padington/cambusa-cabinet/references/README.md

# Источники проекта

[Полный индекс ссылок](source-index.json) указывает, в каких файлах использовался или упоминался каждый адрес. [Исходный список референсов](design-links.txt) включает предоставленные ссылки. Часть публикаций Instagram потребовала входа, поэтому присутствие ссылки не означает, что публикация была просмотрена.

| Что использовали | Где это повлияло на проект | Источник |
|---|---|---|
| Cambusa Fly, пропорции и организация хранения | Компактный деревянный корпус на высоком основании, рамочные двери с внутренними полками | [Каталог Riva 1920](https://www.riva1920.it/it/prodotti/mobili-zona-giorno/mobili-contenitori/cambusa-fly) · [Фотография из галереи](https://www.riva1920.it/components/com_riva/files/product_gallery/76/cambusa-fly-1753679982.jpg) |
| Скосы, открытая кромка фанеры, стол и панель с отверстиями | Ранние эскизы и подбор пропорций. Стол использован как референс формы | [Референсы дизайна](design-links.txt) · [The IDEA](https://www.instagram.com/the_idea/) |
| Врезные петли Sugatsune HES3D-120BL | Номинальные карманы, размерные базы и расчётные крайние положения v15/v16 | [Петля](https://www.sugatsune.com/3-way-adjustable-concealed-hinge-black-hes3d-120bl/) · [Монтажная схема](https://www.sugatsune.com/content/site-assets/Instructions/0522-7_hes3d120e.pdf) · [Каталожный чертёж](https://www.sugatsune.com/content/site-assets/201B_PDF/182.pdf) · [Страница CAD и траектории](https://global.sugatsune.com/global/en/tech/products/21590_t) |
| Промышленный профиль 30 × 30 | Габарит каркаса v16. Пазы профиля в модели упрощены | [Bosch Rexroth 3842990723](https://www.boschrexroth.com/en/de/p/strut-profile-3842990723/) |
| Blum TANDEM 560H3500B и T51.1700.04 | Историческая проверка ящика v14. Полная сборка с парой замков остаётся в очереди | [Конфигуратор Blum](https://www.blum.com/us/en/services/e-services/onlineproductconfigurator/) · [Каталог, код DQD1XA](https://publications.blum.com/2024/catalogue/en/435/) · [Отчёт v14](../history/outputs/tandem-review-v14/ПРОЧИТАТЬ-СНАЧАЛА.md) |
| Раскрой и фрезеровка в Санкт-Петербурге | Подбор поставщиков и исторические ставки v10 | [Исследование поставщиков](../history/work/spb-plywood-research.json) · [Расчёт v10](../history/outputs/layout-cost-v10/РАСЧЁТ.md) |
| Печать и коммерческие соединители | Ранние варианты изготовления и сборки | [3D-печать в СПб](../history/work/spb-printing-research.json) · [Соединители](../history/work/order_hardware_candidates.json) |
| Проекты мебели с помощью ИИ | Сравнение подходов к проектированию и подготовке производства | [Проверенные примеры](../history/work/ai-furniture-cases.json) |

Присланные фотографии и скриншоты собраны в [фотогалерее](photos/README.md). Каталоги и исходный CAD производителей приведены ссылками на оригиналы. Собственные модели, эскизы, карты раскроя и код собраны в [истории проекта](../history/README.md) и в [актуальных исходниках](../README.md).
