padington/cambusa-cabinet/references/photos/README.md

# Фотографии и скриншоты для проекта

Референсы формы, материалов и деталей. Авторство исходных изображений принадлежит их авторам.

| Референс | Файл |
|---|---|
| Комод со скошенными боковинами | [Открыть фото](beveled-sideboard.jpg) |
| Слои фанеры и скругление торца | [Открыть фото](plywood-edge-detail.jpg) |
| Наклонный профиль секретера | [Открыть фото](sloped-secretary.jpg) |
| Стол YOUK, тёмный вариант | [Открыть фото](youk-dark-angle.jpg) |
| Стол YOUK, пропорции опор | [Открыть фото](youk-natural-angle.jpg) |
| Стол YOUK, диагональный вид | [Открыть фото](youk-yellow-angle.jpg) |
| Стол YOUK, детали верхней секции | [Открыть фото](youk-yellow-detail.jpg) |
| Стол YOUK, вид спереди | [Открыть фото](youk-yellow-front.jpg) |
| Перфорированная боковина | [Открыть фото](pegboard-reference.png) |
| Cambusa Fly, фотография из каталога Riva 1920 | [Открыть фото](cambusa-fly-riva.png) |
| Cambusa Fly с открытыми створками и подсветкой | [Открыть фото](cambusa-open-lit.jpg) |
| Крупный план петли, полок и ящиков | [Открыть фото](cambusa-hinge-shelves.jpg) |
| Открытый шкаф Cambusa Fly, вид спереди | [Открыть фото](cambusa-open-front.jpg) |
