padington/cambusa-cabinet/references/design-links.txt

Референсы пользователя, без утверждения о доступности всех публикаций:
https://www.instagram.com/reel/DeNH8KUxL0F/
https://www.instagram.com/reel/DQRs9qPiD78/
https://www.instagram.com/p/DdYVaM4irWC/
https://www.instagram.com/reel/DeH7xiDxZNn/
https://www.instagram.com/domj0hnson/
https://www.instagram.com/greg.dean.mann/
https://www.instagram.com/reel/DMUpQAet0EN/
https://www.instagram.com/reel/DMUqrTBt7dS/
https://www.instagram.com/p/DUC9AhtCOgn/
https://www.instagram.com/p/DUDbeApl1VM/
https://www.instagram.com/guillaume_jandin/
https://www.riva1920.it/ru/produkty/mebel-dlya-dnevnoj-zony/mebel-dlya-khraneniya
https://www.riva1920.it/ru/produkty/mebel-dlya-dnevnoj-zony/knizhnye-shkafy
https://www.riva1920.it/it/prodotti/mobili-zona-giorno/mobili-contenitori/cambusa-fly
