padington/cambusa-cabinet/outputs/cambusa-doors-v15/ПРОЧИТАТЬ-СНАЧАЛА.md

# Cambusa v15 — рамочные двери с полками

[3D с открытыми дверями](open.glb) · [3D с закрытыми дверями](closed.glb) · [Общий вид](ДВЕРИ-v15.png) · [Карман петли крупно](КАРМАНЫ-ПЕТЛИ.png) · [Координаты операций и результаты проверок](ПРОВЕРКА.json)

Шкаф 1000 × 1800 × 500 мм. Деревянный корпус высотой 1000 мм стоит на чёрном основании высотой 800 мм. В каждой створке 457,5 × 958 × 85 мм три полки с бортиками. Полезная площадка каждой полки — 379,5 × 58,2 мм. Стойка у центрального шва тоньше, а глубокая часть двери заканчивается за 20 мм до шва. Это даёт место для начала поворота. Стык створок в закрытом положении — 6 мм.

## Привязки карманов

В сборке начало координат — на полу под передним левым углом корпуса. X идёт вправо, Y вглубь шкафа, Z вверх. Все размеры в миллиметрах. Дверной карман расположен в торце со стороны петли, ответный — на обращённом к проёму торце стойки корпуса. Глубину измеряем от поверхности этого торца.

| Привязка | Дверь | Стойка корпуса |
|---|---:|---:|
| Передняя граница кармана от передней кромки детали | 3 | 4 |
| Ширина кармана | 23 | 25 |
| Нижняя граница внешней ступени от низа детали, нижняя и верхняя петли | 79 / 759 | 82 / 762 |
| Высота × глубина внешней ступени | 120 × 6,5 | 120 × 6,5 |
| Нижняя граница глубокой ступени от низа детали, нижняя и верхняя петли | 94 / 774 | 97 / 777 |
| Высота × полная глубина глубокой ступени | 90 × 21 | 90 × 21 |
| Радиус в углах | 6 | 6 |
| Остаток дерева за глубокой ступенью | 19 | 15 |

Центры обеих пар петель находятся на высотах 960 и 1640 мм от пола. Номинальные оси винтов идут по середине кармана на 53 мм выше и ниже центра петли. Предусмотрены отдельные стойки корпуса толщиной 36 мм, чтобы карман глубиной 21 мм помещался целиком. Пилотные отверстия и обработку сопряжённых кромок нужно согласовать на пробном узле. [Монтажная схема Sugatsune HES3D-120](https://www.sugatsune.com/content/site-assets/Instructions/0522-7_hes3d120e.pdf)

## Что показала модель

- Вырезаны все 16 ступеней карманов и пазы дверных деталей. В закрытом положении и в расчётном положении на 180° пересечений деревянных деталей не обнаружено. На 180° шкаф занимает 1843 мм по ширине.
- При закрытых дверях между их тыльной границей и внутренними полками остаётся 17 мм. Это зазор пустых полок. При загрузке нужно учитывать выступ предметов.
- Проверен путь вставки передней панели в пазы до установки последней стойки. После закрытия рамки полки и бортики вставляются со стороны внутренней поверхности. Проверка касается геометрии дерева. Разъёмные крепления рамки и фиксаторы полок ещё нужно подобрать.
- Для зазора у шва рассчитан сценарий поворота вокруг неподвижного ребра. Он помог подобрать форму стойки. Реальная HES3D-120BL перемещает створку на рычагах, поэтому движение между 0 и 180° нужно проверить по файлу траектории или на собранной паре стоек с петлёй.

Масса пустой двери с двумя петлями оценена в 9,15 кг при плотности дерева 720 кг/м³, без прочей фурнитуры. Каталожная грузоподъёмность пары петель 30 кг относится к условиям производителя. Для дверных полок нужны отдельная проверка нагрузки и проверка устойчивости шкафа с открытыми створками. Выпуск обработки для полного заказа пока закрыт. [Данные HES3D-120BL](https://www.sugatsune.com/3-way-adjustable-concealed-hinge-black-hes3d-120bl/)

Ящики отложены. Проход в каждую секцию после установки стоек — 455 мм. Фасад прежнего ящика шириной 465 мм в этот проём не проходит. Короб шириной 455 мм также требует пересчёта для рабочего зазора.
