padington/cambusa-cabinet/history/outputs/cabinet-six-concepts/01-portal.png

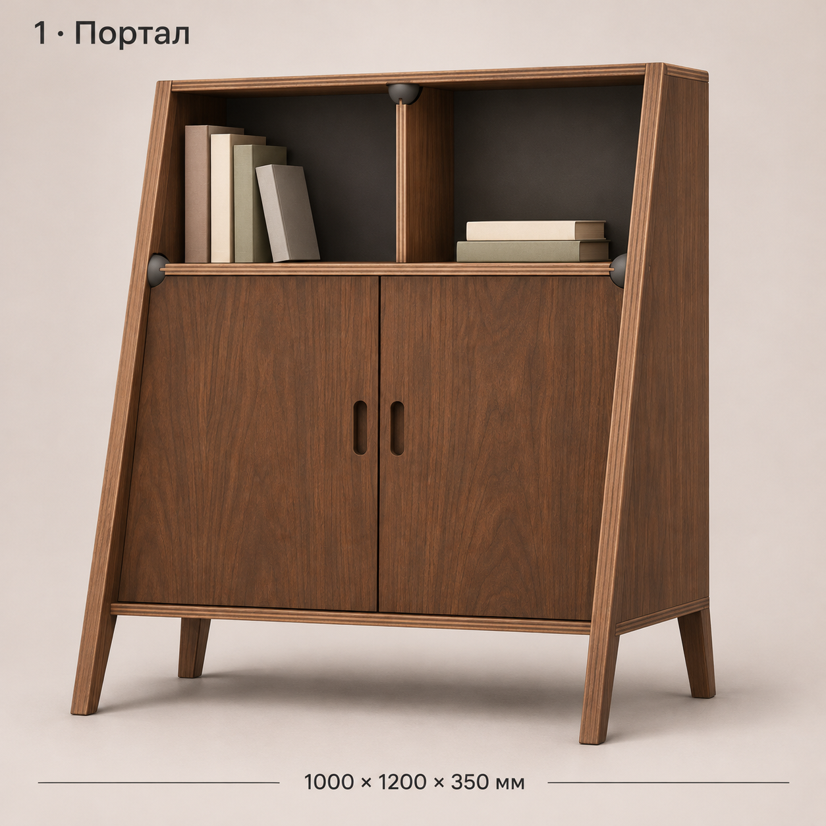
history/outputs/cabinet-six-concepts/01-portal.png
