padington/cambusa-cabinet/history/outputs/cabinet-six-concepts/02-vertical.png

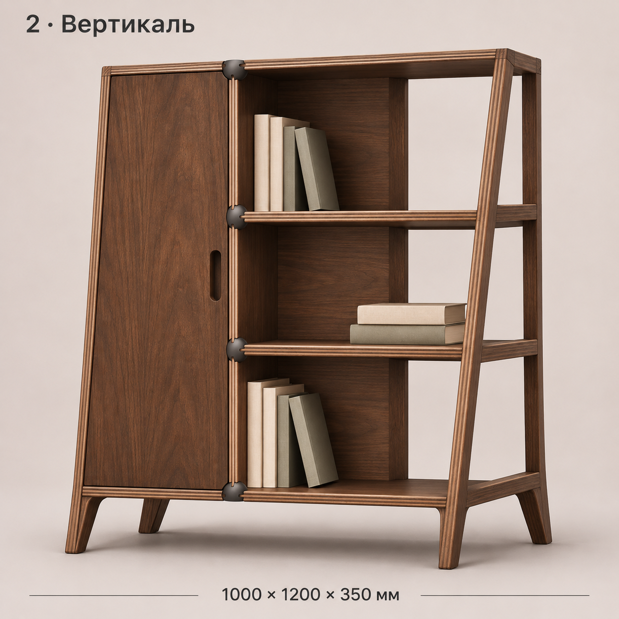
history/outputs/cabinet-six-concepts/02-vertical.png
