padington/cambusa-cabinet/history/outputs/cabinet-six-concepts/03-offset.png

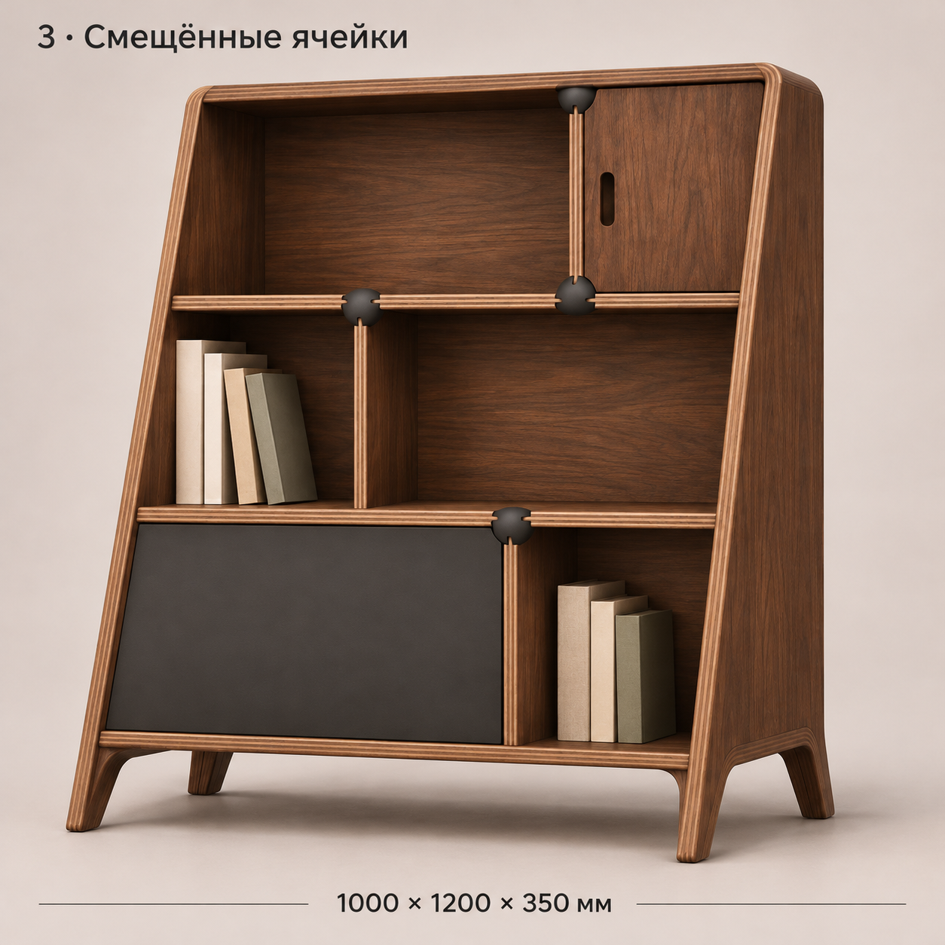
history/outputs/cabinet-six-concepts/03-offset.png
