padington/cambusa-cabinet/history/outputs/cabinet-six-concepts/05-ladder.png

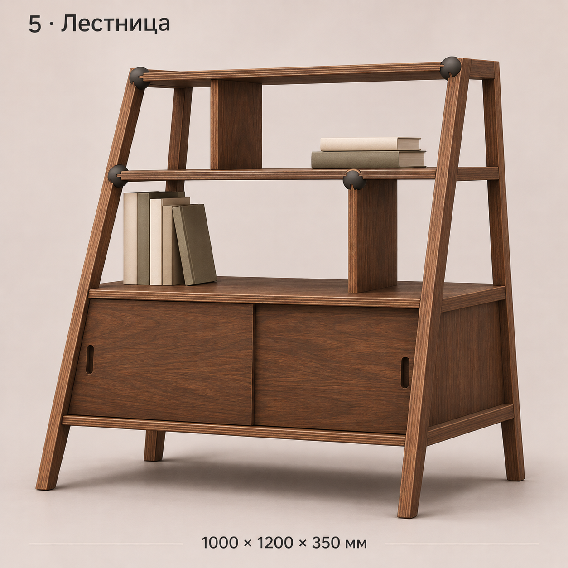
history/outputs/cabinet-six-concepts/05-ladder.png
