padington/cambusa-cabinet/history/outputs/cabinet-six-concepts/06-gallery.png

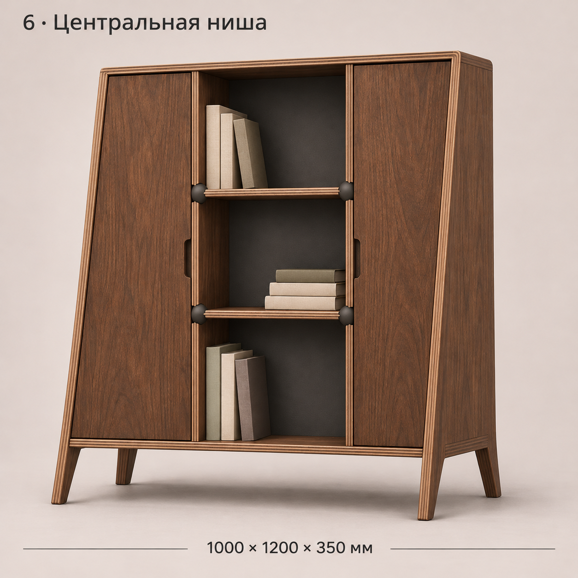
history/outputs/cabinet-six-concepts/06-gallery.png
