padington/cambusa-cabinet/history/outputs/early-visual-sketches/sloped-cabinet-concept-v01.png

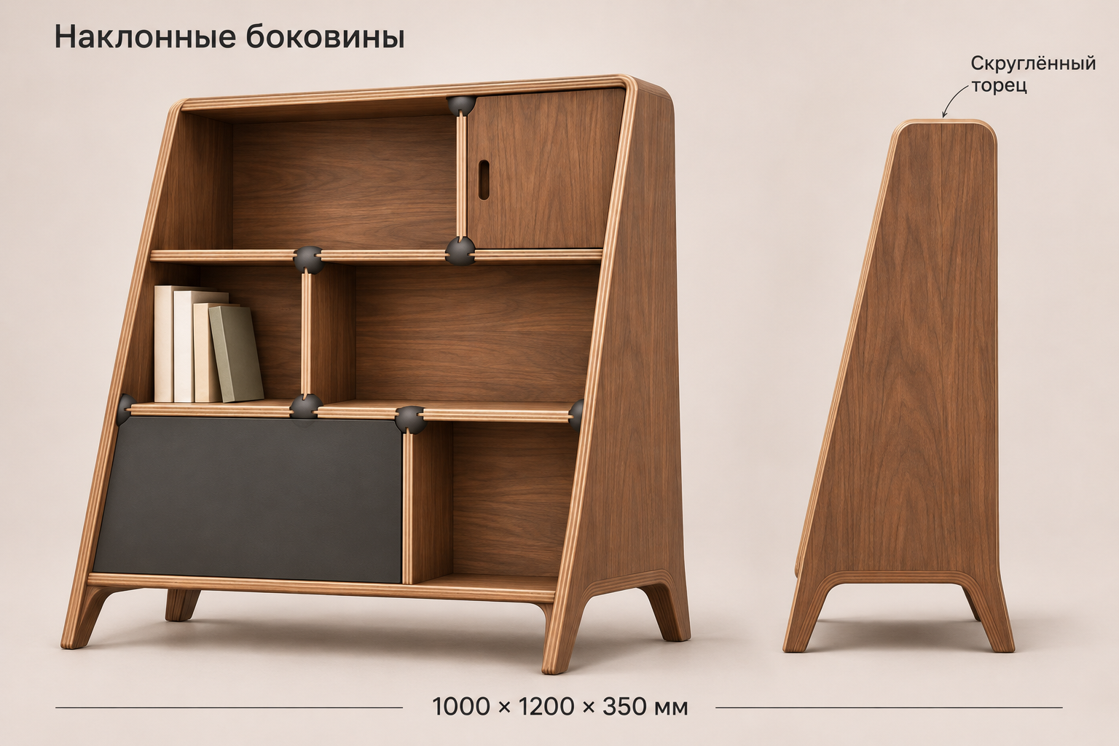
history/outputs/early-visual-sketches/sloped-cabinet-concept-v01.png
