padington/cambusa-cabinet/history/outputs/early-visual-sketches/spherical-cabinet-riva-concept-v01.png

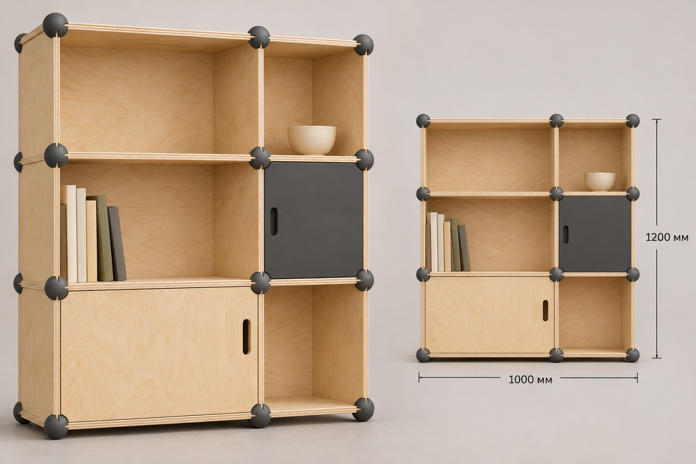
history/outputs/early-visual-sketches/spherical-cabinet-riva-concept-v01.png
