padington/cambusa-cabinet/history/outputs/sphere-bayonet-v02/mechanism-overview.png

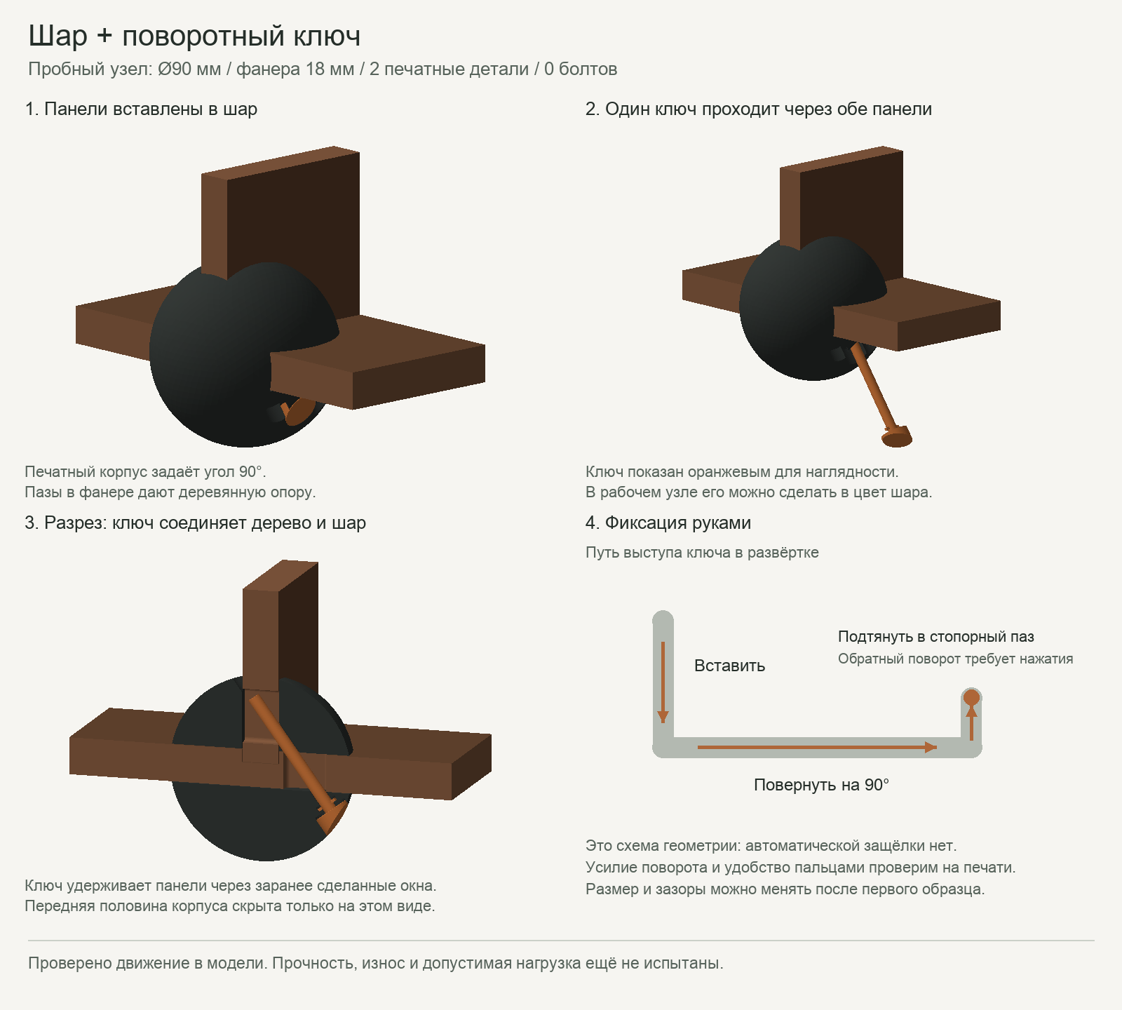
history/outputs/sphere-bayonet-v02/mechanism-overview.png
