padington/cambusa-cabinet/history/work/reference-designs-open.png

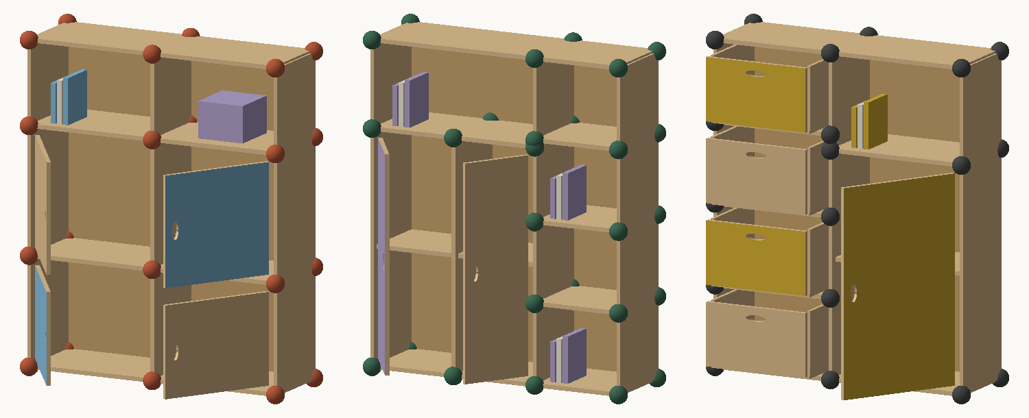
history/work/reference-designs-open.png
