padington/cambusa-cabinet/outputs/cambusa-doors-v15/closed.png

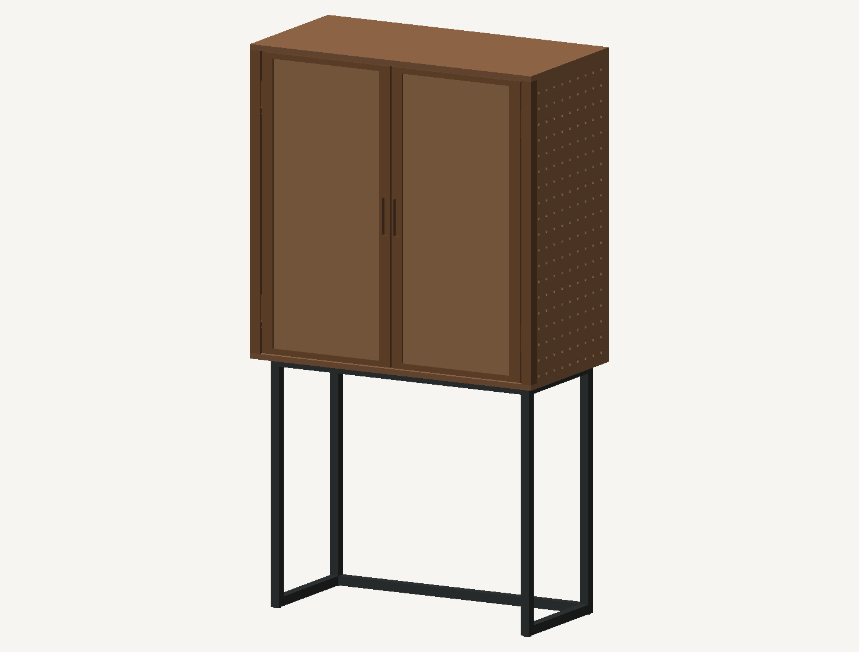
outputs/cambusa-doors-v15/closed.png
