padington/cambusa-cabinet/outputs/cambusa-doors-v15/open.png

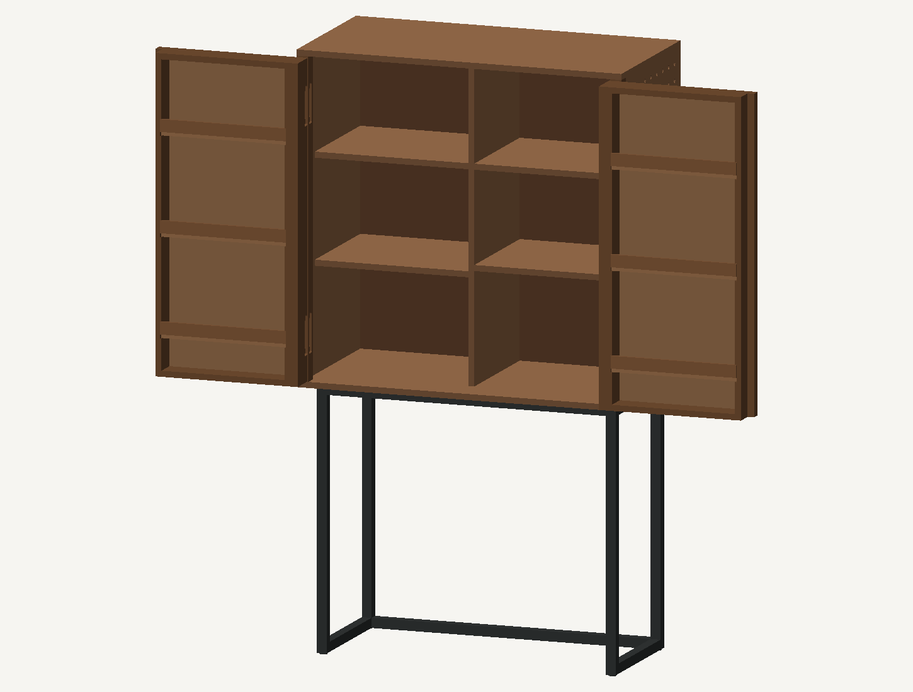
outputs/cambusa-doors-v15/open.png
