padington/cambusa-cabinet/outputs/cambusa-doors-v15/ДВЕРИ-v15.png

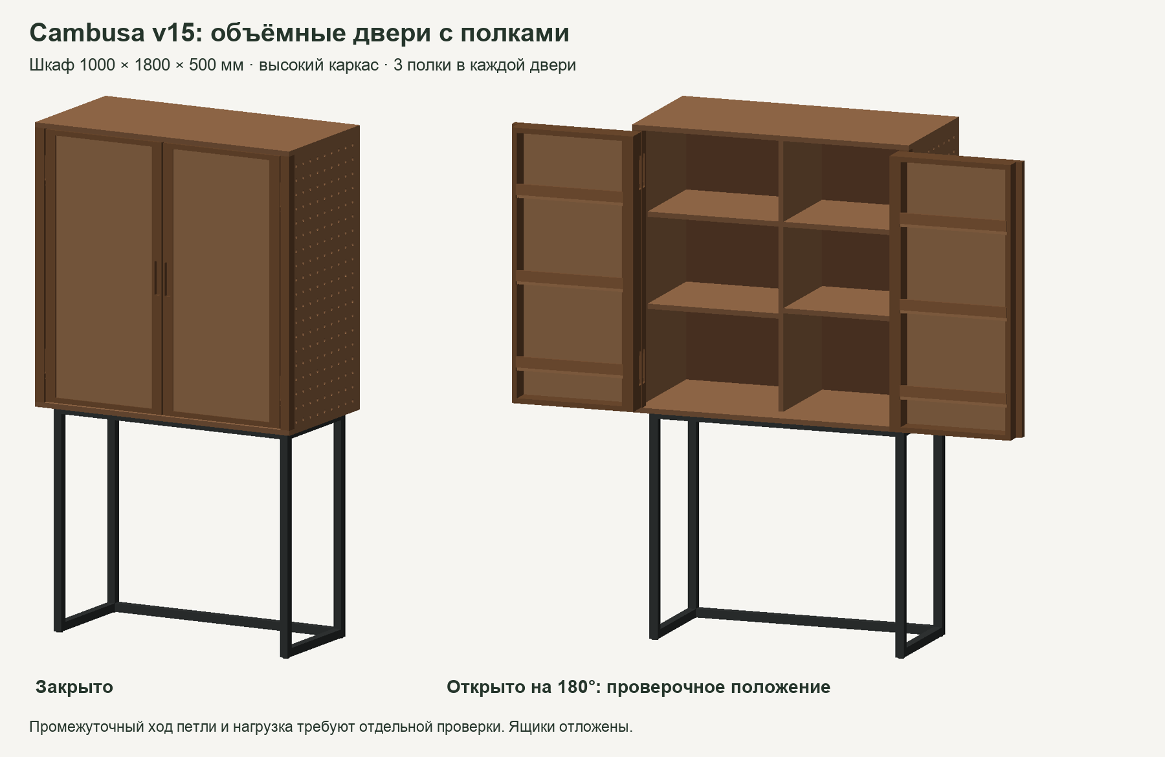
outputs/cambusa-doors-v15/ДВЕРИ-v15.png
