padington/cambusa-cabinet/outputs/cambusa-doors-v15/КАРМАНЫ-ПЕТЛИ.png

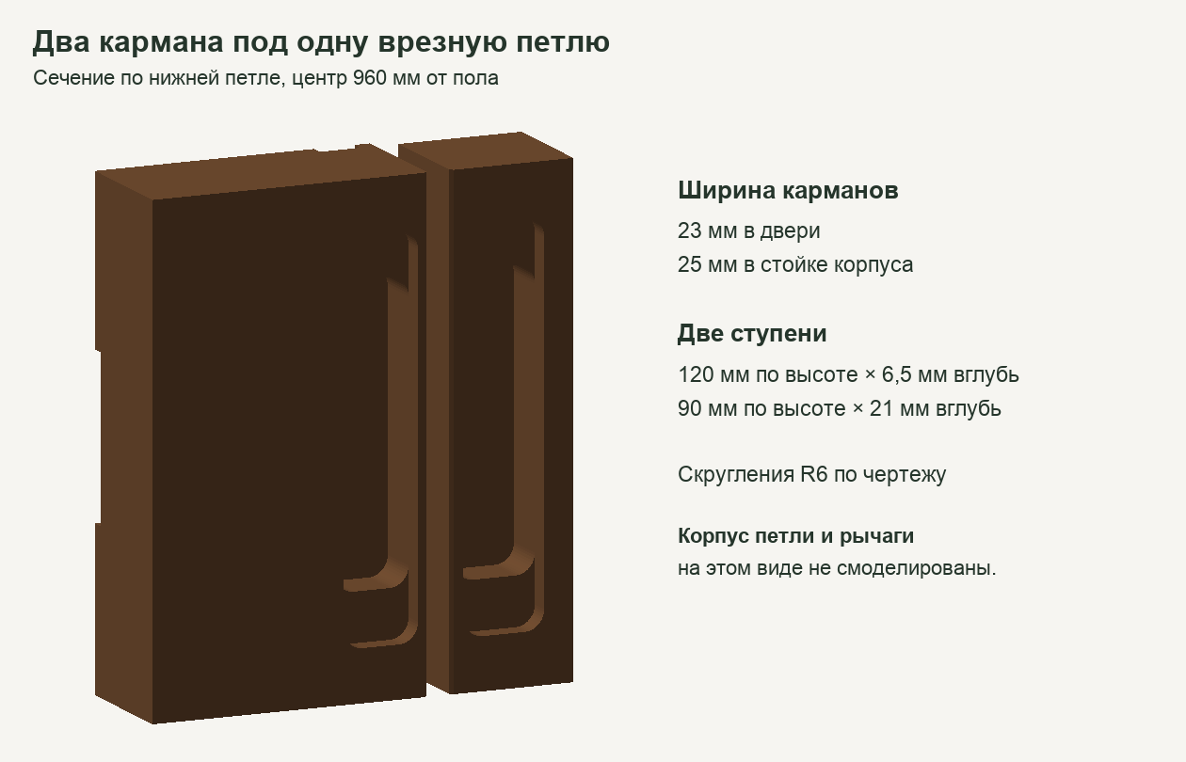
outputs/cambusa-doors-v15/КАРМАНЫ-ПЕТЛИ.png
