padington/cambusa-cabinet/outputs/cambusa-frame-v17/storage/01-solid.png

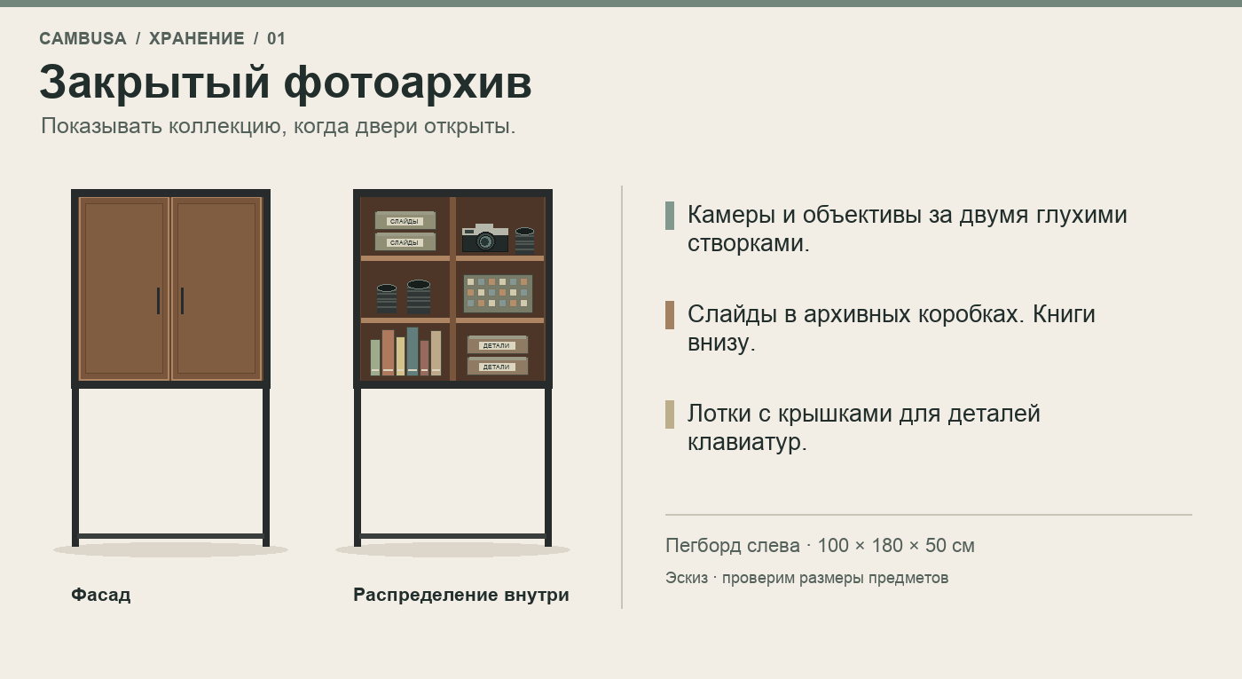
outputs/cambusa-frame-v17/storage/01-solid.png
