padington/cambusa-cabinet/outputs/cambusa-frame-v17/storage/03-books.png

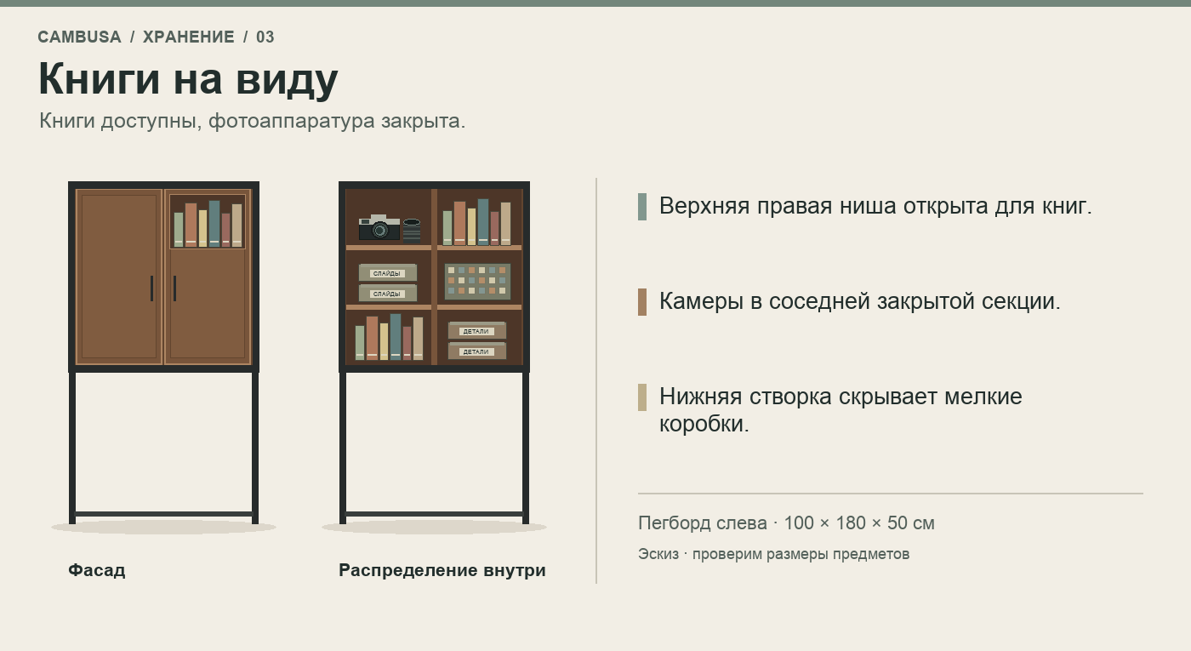
outputs/cambusa-frame-v17/storage/03-books.png
