padington/cambusa-cabinet/references/photos/beveled-sideboard.jpg

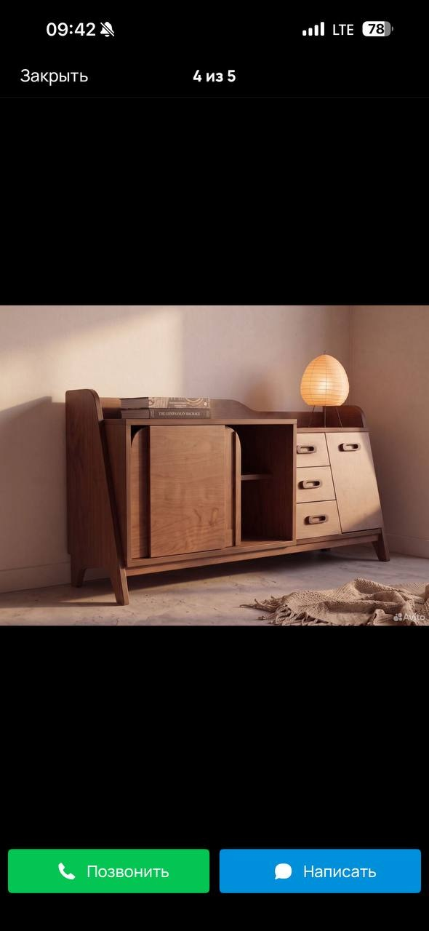
references/photos/beveled-sideboard.jpg
