padington/cambusa-cabinet/references/photos/cambusa-fly-riva.png

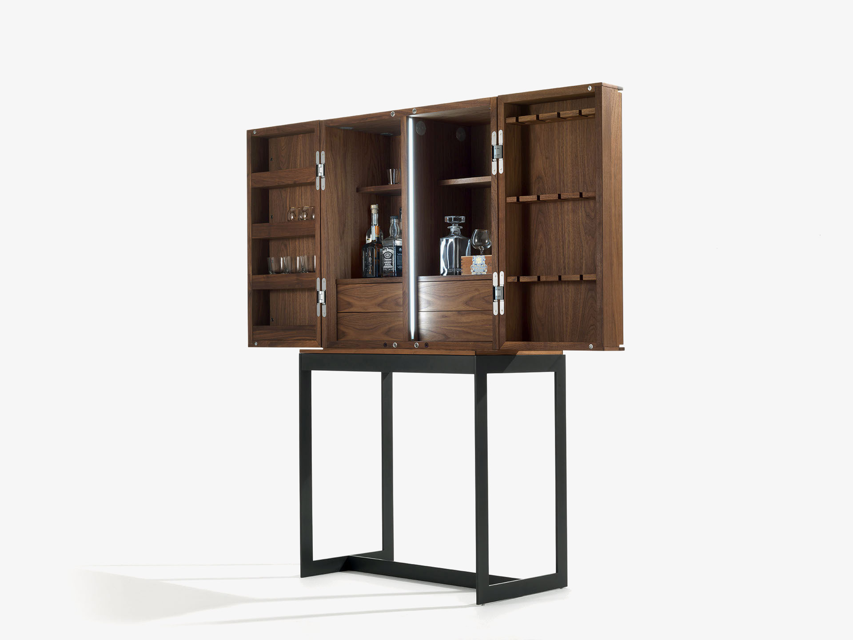
references/photos/cambusa-fly-riva.png
