padington/cambusa-cabinet/references/photos/cambusa-hinge-shelves.jpg

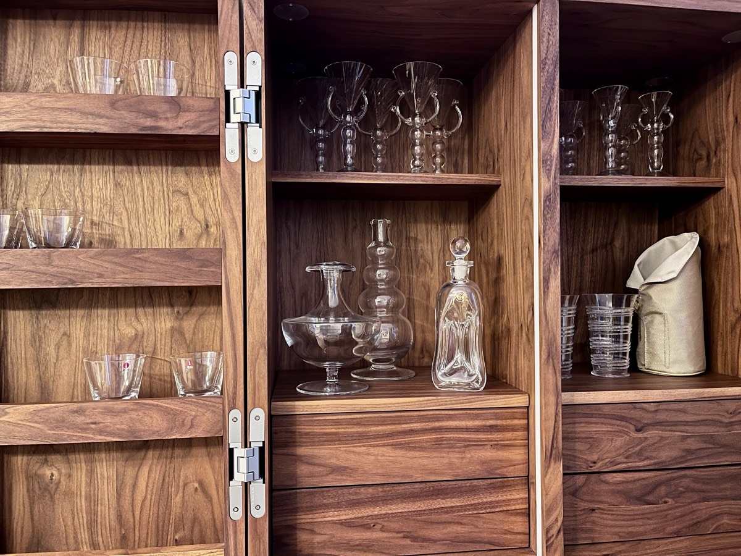
references/photos/cambusa-hinge-shelves.jpg
