padington/cambusa-cabinet/references/photos/cambusa-open-front.jpg

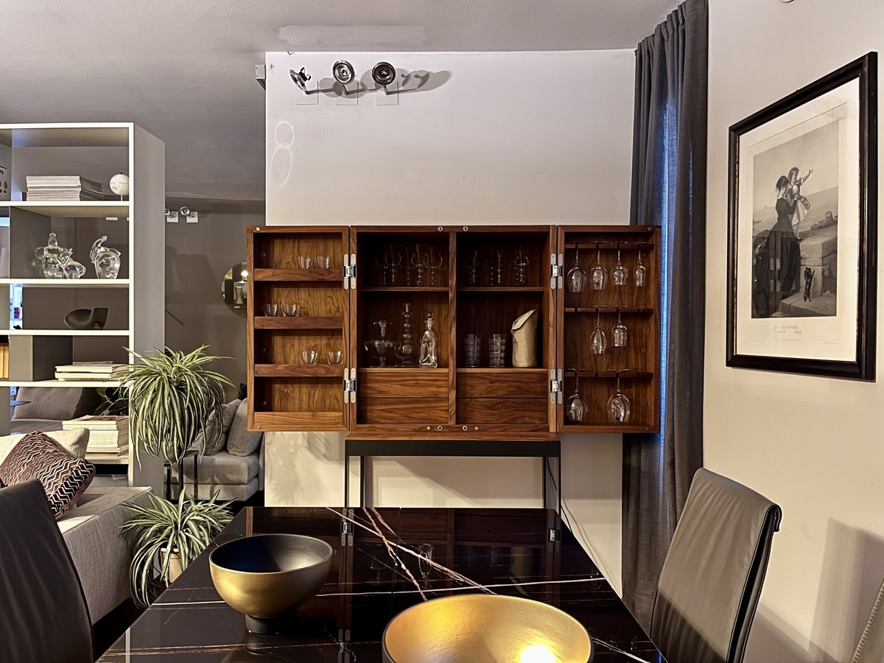
references/photos/cambusa-open-front.jpg
