padington/cambusa-cabinet/references/photos/cambusa-open-lit.jpg

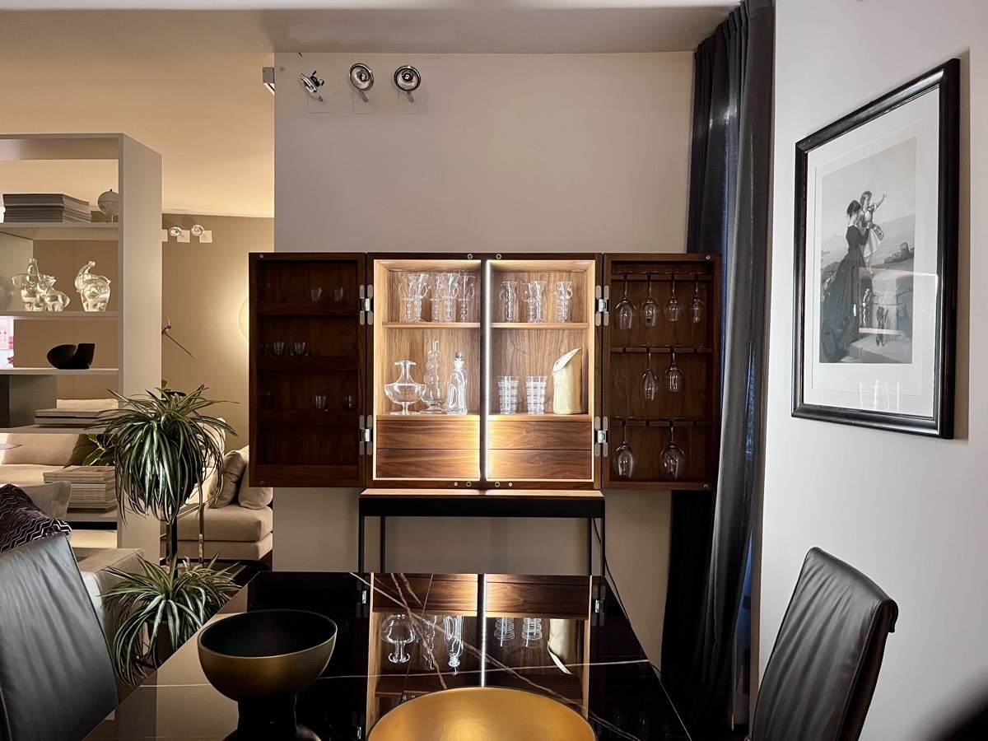
references/photos/cambusa-open-lit.jpg
