padington/cambusa-cabinet/references/photos/pegboard-reference.png

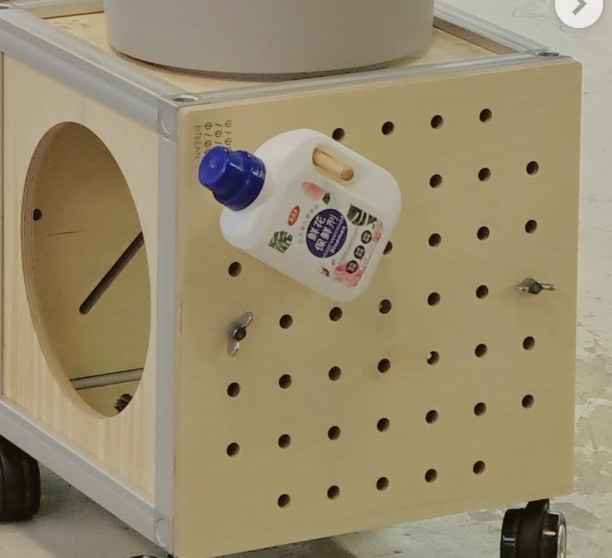
references/photos/pegboard-reference.png
