padington/cambusa-cabinet/references/photos/plywood-edge-detail.jpg

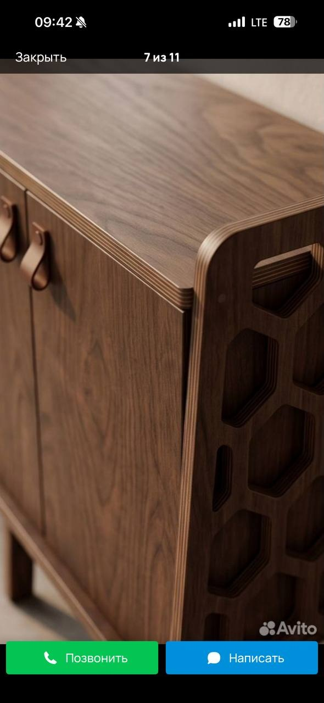
references/photos/plywood-edge-detail.jpg
