padington/cambusa-cabinet/references/photos/sloped-secretary.jpg

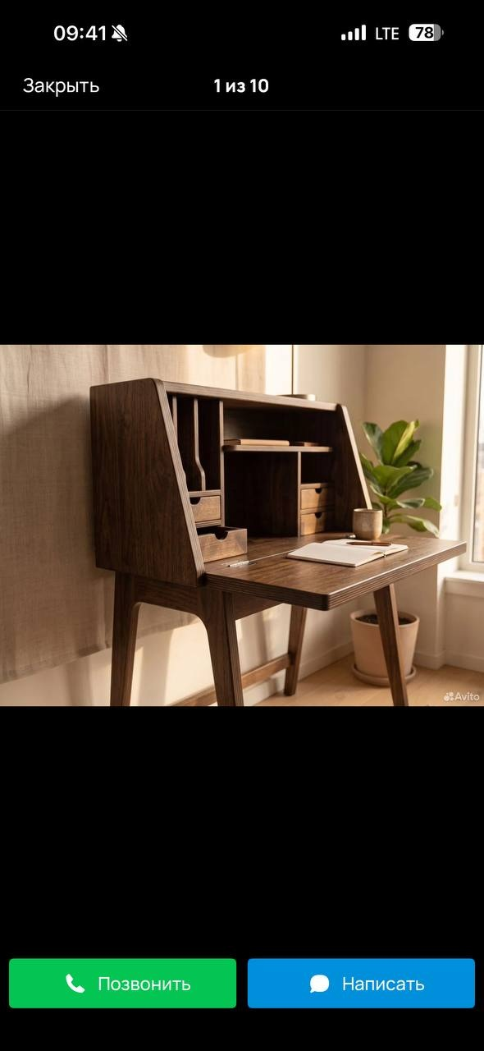
references/photos/sloped-secretary.jpg
