padington/cambusa-cabinet/references/photos/youk-dark-angle.jpg

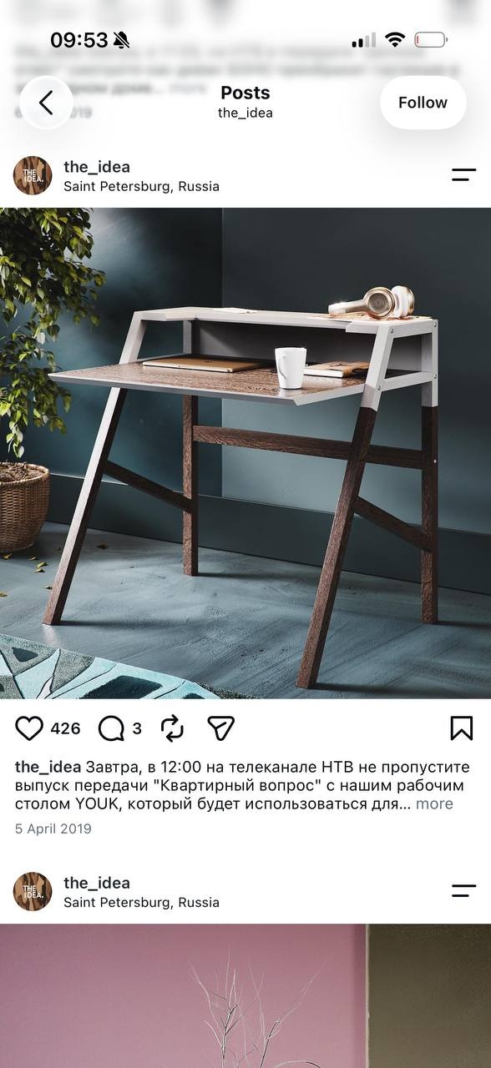
references/photos/youk-dark-angle.jpg
