padington/cambusa-cabinet/references/photos/youk-natural-angle.jpg

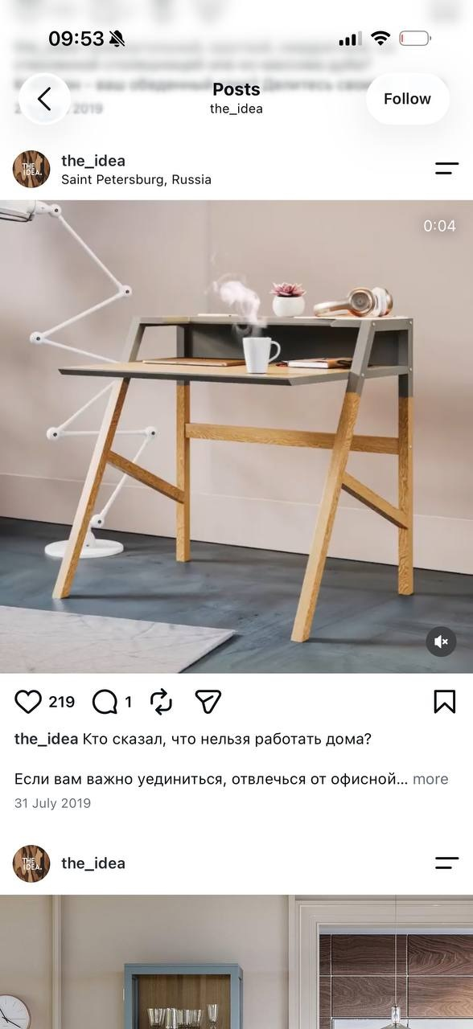
references/photos/youk-natural-angle.jpg
