padington/cambusa-cabinet/references/photos/youk-yellow-angle.jpg

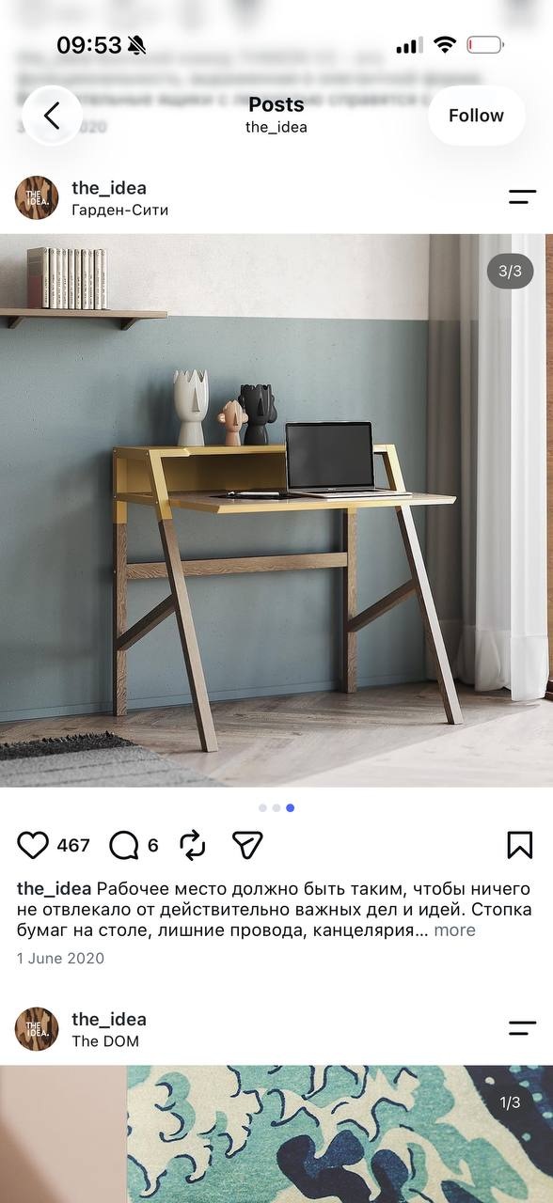
references/photos/youk-yellow-angle.jpg
