padington/cambusa-cabinet/references/photos/youk-yellow-detail.jpg

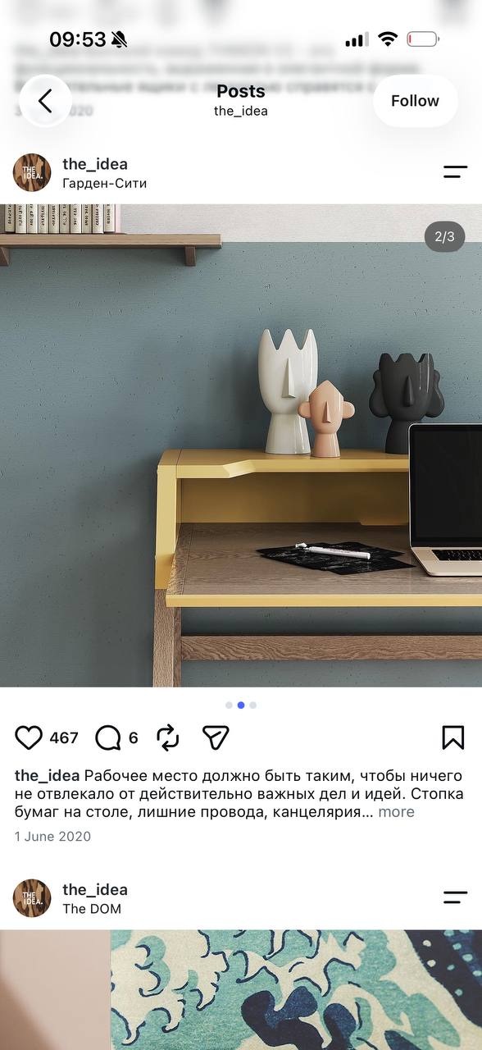
references/photos/youk-yellow-detail.jpg
