padington/cambusa-cabinet/references/photos/youk-yellow-front.jpg

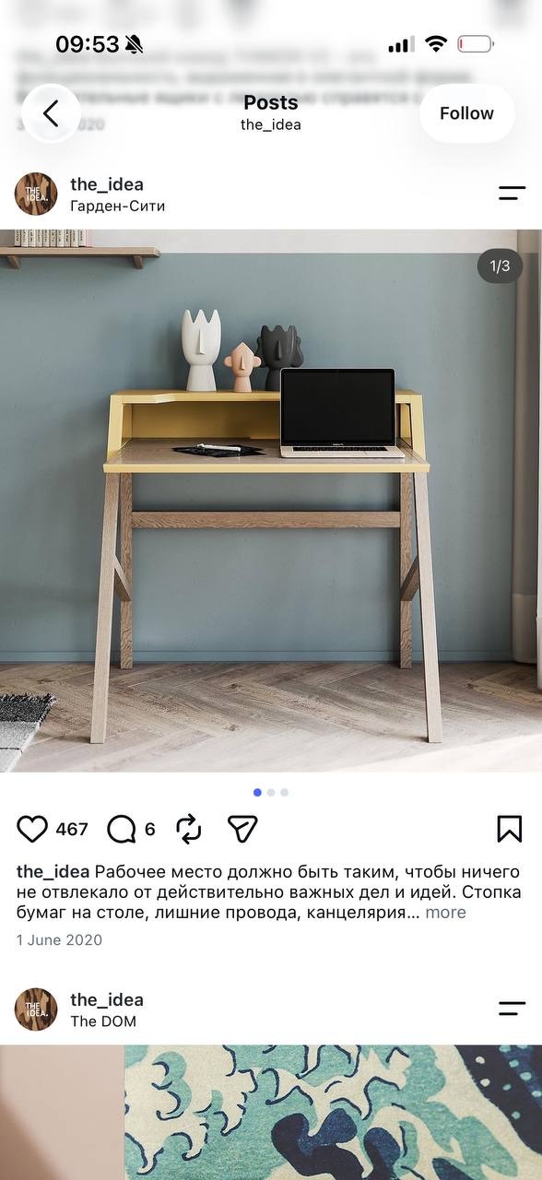
references/photos/youk-yellow-front.jpg
