padington/cambusa-cabinet/history/outputs/order-preparation-v06/profile-blanks.csv

id | section_mm | slot | length_mm | quantity
A-post-0-0 | 30x30 | 8 mm, exact system pending | 1064 | 1
A-post-0-1 | 30x30 | 8 mm, exact system pending | 1064 | 1
A-post-1-0 | 30x30 | 8 mm, exact system pending | 1064 | 1
A-post-1-1 | 30x30 | 8 mm, exact system pending | 1064 | 1
A-post-2-0 | 30x30 | 8 mm, exact system pending | 1064 | 1
A-post-2-1 | 30x30 | 8 mm, exact system pending | 1064 | 1
A-cross-left-0-0 | 30x30 | 8 mm, exact system pending | 447 | 1
A-cross-right-0-0 | 30x30 | 8 mm, exact system pending | 445 | 1
A-cross-left-0-1 | 30x30 | 8 mm, exact system pending | 447 | 1
A-cross-right-0-1 | 30x30 | 8 mm, exact system pending | 445 | 1
A-depth-0-0 | 30x30 | 8 mm, exact system pending | 434 | 1
A-depth-0-1 | 30x30 | 8 mm, exact system pending | 434 | 1
A-depth-0-2 | 30x30 | 8 mm, exact system pending | 434 | 1
A-cross-right-1-0 | 30x30 | 8 mm, exact system pending | 445 | 1
A-cross-left-1-1 | 30x30 | 8 mm, exact system pending | 447 | 1
A-cross-right-1-1 | 30x30 | 8 mm, exact system pending | 445 | 1
A-depth-1-0 | 30x30 | 8 mm, exact system pending | 434 | 1
A-depth-1-1 | 30x30 | 8 mm, exact system pending | 434 | 1
A-depth-1-2 | 30x30 | 8 mm, exact system pending | 434 | 1
A-cross-left-2-0 | 30x30 | 8 mm, exact system pending | 447 | 1
A-cross-right-2-0 | 30x30 | 8 mm, exact system pending | 445 | 1
A-cross-left-2-1 | 30x30 | 8 mm, exact system pending | 447 | 1
A-cross-right-2-1 | 30x30 | 8 mm, exact system pending | 445 | 1
A-depth-2-0 | 30x30 | 8 mm, exact system pending | 434 | 1
A-depth-2-1 | 30x30 | 8 mm, exact system pending | 434 | 1
A-depth-2-2 | 30x30 | 8 mm, exact system pending | 434 | 1
A-cross-left-3-0 | 30x30 | 8 mm, exact system pending | 447 | 1
A-cross-right-3-0 | 30x30 | 8 mm, exact system pending | 445 | 1
A-cross-left-3-1 | 30x30 | 8 mm, exact system pending | 447 | 1
A-cross-right-3-1 | 30x30 | 8 mm, exact system pending | 445 | 1
A-depth-3-0 | 30x30 | 8 mm, exact system pending | 434 | 1
A-depth-3-1 | 30x30 | 8 mm, exact system pending | 434 | 1
A-depth-3-2 | 30x30 | 8 mm, exact system pending | 434 | 1
