padington/cambusa-cabinet/history/outputs/order-preparation-v06/READ-ME-RU.txt

КОМПЛЕКТ ДЕТАЛЕЙ ТУМБЫ — ПОДГОТОВКА К РАСЧЁТУ, ВЕРСИЯ 06
3 ноября 2026

ЦЕЛЬ
Заказать отдельные подготовленные детали и самостоятельно собрать всю тумбу
дома. Сборка каркаса и коробов ящиков на стороне не входит в проект.
Точные операции изготовления выполняет поставщик деталей по заданию:
раскрой, фрезеровка, сверление, обработка кромок и отделка.
Ранее разрешённые готовые мебельные петли могут приходить на отдельных
панелях. Это не означает заказ собранного корпуса.

В ЭТОЙ ВЕРСИИ
Корпус 1000 × 1200 × 500 мм, высота включает колёса.
Два внутренних ящика, левая дверца с двумя лотками, открытые ниши,
перфорация на всю правую боковину. Тёмная фанера и тонкая тёмная рама.
Добавлены центральные передняя и задняя стойки: перекладины теперь
имеют опоры на обоих концах. Детали больше не заканчиваются в воздухе.
Задняя стенка вынесена на заднюю плоскость рамы; это позволяет поставить
её последней снаружи, не продевая через собранные перекладины.
Добавлены отдельное основание под колёса и верхняя крышка.
Рама: 33 отрезка профиля 30 × 30, всего 18,281 м без пропила и запаса.
Фанера: 38 заготовок, включая раздельные стороны и днища обоих ящиков.
Это отдельные детали, а не заказ готовых собранных ящиков.

ФАЙЛЫ
profile-blanks.csv — каждый отрезок профиля с маркировкой и длиной.
plywood-blanks.csv — каждая заготовка фанеры с толщиной и размером.
quote-outlines/ — контуры для оценки работ: DXF в миллиметрах и SVG 1:1.
assembled.glb — закрытый корпус, open.glb — условное открывание,
exploded.glb — разнесённые детали. GLB в метрах, Y вверх.
assembled.png, open.png, exploded.png — изображения той же геометрии.
verification.json — проверки сеток и крупных геометрических пересечений.
hardware-candidates.json — проверенные кандидаты и исключённые варианты.

ВАЖНЫЙ СТАТУС ФАЙЛОВ
Это пакет для расчёта и проверки конструкции, НЕ разрешение на резку.
Во всех DXF слои помечены QUOTE_ONLY. Присадка для крепежа, петель,
фиксаторов и направляющих пока не выпущена. Не все контуры окончательны:
после выбора креплений могут измениться торцевые пазы, припуски и днища.
Полный заказ в производство до выбора креплений делать нельзя.
Вопрос о допустимости ключа/отвёртки из комплекта задан пользователю отдельно.
До ответа сохраняется исходная цель сборки только руками. Обычный
алюминиевый каркас сам по себе этому условию не отвечает: его соединения
обычно затягиваются ключом. Вариант с профилем пока не утверждён по крепежу.

ПЕРФОРАЦИЯ
Панель 500 × 1064 × 18 мм. Номинально Ø12 мм, шаг 50 мм, 180 отверстий.
20 рядов, 9 колонок. Новая сетка не пересекается с перекладинами за панелью:
центры по глубине 50..450 мм с шагом 50; по высоте от пола 190..1140 мм.
Предыдущую сетку версии 05 (189 отверстий) не применять к этой раме.
Навесы в версии 06 не показаны: сначала требуется определить крепления
и проверить посадку штырей после отделки. Система не заявлена совместимой
с каким-либо брендом pegboard.

КОЛЁСА
В расчётной геометрии заложены колёса Ø75, монтажная высота 100 мм,
условная площадка 60 × 60 мм. Это габаритная модель кандидата,
не CAD конкретного колеса и не подтверждённый артикул для покупки.
Пример габарита — Blickle LPA-TPA 75G-FI. Наличие в России не подтверждено.
Точное колесо, его сверление, крепление к основанию, тормоз и нагрузка
должны быть выбраны до выпуска основания в производство.
Паспортная нагрузка колеса не равна допустимой нагрузке всей тумбы.

ЯЩИКИ
В эскизе два короба наружным габаритом около 409 × 390 мм.
Расчётная толщина боковин 12 мм, днищ 9 мм, внутренний фасад 12 мм.
Кандидат-направляющая: скрытая, номинальная длина 400 мм, с фиксатором.
Файлы пока показывают габариты и зазоры. Пазы днищ, задние вырезы,
сверления фиксаторов, стыки коробов и крепление направляющих не выпущены.
Инструкция не может начинаться с «вставить готовый ящик»: каждый короб
также должен собираться пользователем из перечисленных деталей.

ВАРИАНТЫ СОЕДИНЕНИЙ
Если допустим простой ручной инструмент из комплекта: можно использовать
обычную доступную фурнитуру профиля и мебельные винтовые крепления внутри.
Тогда поставщик режет и сверлит, а всю сборку выполняет пользователь.

Если только руками: потребуются специальные скрытые защёлки или ручные
замки и отдельное решение для направляющих и колёс. OVVO и Lockdowel
подтверждают соответствующие принципы, но наличие нужных артикулов и
исполнителя их точных пазов в СПб пока не подтверждено. Их нельзя молча
заменить на обычный профиль с винтами или на предварительную сборку каркаса.

ПОРЯДОК СБОРКИ, КОТОРЫЙ ДОЛЖЕН ПОЛУЧИТЬСЯ
1. Проверить маркировку и комплектность отдельных деталей.
2. Поставить колёса на основание выбранным способом.
3. Собрать низ рамы и стойки, затем остальные перекладины.
4. Установить полки, центральные перегородки и боковые вставки.
5. Закрепить цельную перфорированную боковину.
6. Закрепить заднюю стенку, выровняв геометрию корпуса.
7. Самостоятельно собрать оба короба, поставить направляющие и фиксаторы.
8. Поставить ящики и дверцы, отрегулировать зазоры по инструкции фурнитуры.
9. Проверить лёгкость движения и тормоза, затем испытать назначенную нагрузку.
Это целевая последовательность, а не уже проверенная инструкция монтажа:
крепёжные операции и доступ к ним нужно подтвердить после выбора фурнитуры.

ЧТО ПРОВЕРЕНО
Замкнутость сеток, габариты и отсутствие объёмных пересечений крупных
панелей и элементов рамы в закрытом состоянии. Эти проверки не доказывают
прочность, устойчивость, кинематику настоящих петель или сборку соединений.

СЛЕДУЮЩИЙ ВЫПУСК ДЛЯ ЗАКАЗА
После выбора допустимого инструмента: точные артикулы и количество
креплений, окончательная присадка всех деталей, схема крепления колёс,
узлы коробов и направляющих, контрольный образец, затем полный раскрой.
Нет заказанных деталей, отправленных заявок или подтверждённых цен.
