padington/cambusa-cabinet/outputs/cambusa-frame-v17/planning/BOM.md

# Ведомость и смета Cambusa v17

Расчёт по габаритам деталей в closed.glb. Это план закупки и контроль раскладки. Карты используют прямоугольные заготовки с припуском, а пазы и отверстия задаются отдельно.

Деталей в модели — **53**, фанеры — **5 листов**, длинномерных заготовок — **6**.

| Позиция | Количество | Единица | Цена | Сумма |
|---|---:|---|---:|---:|
| Фанера 12 мм | 1 | лист | требует уточнения | требует уточнения |
| Фанера 18 мм | 2 | лист | требует уточнения | требует уточнения |
| Фанера 8 мм | 1 | лист | требует уточнения | требует уточнения |
| Фанера 9 мм | 1 | лист | требует уточнения | требует уточнения |
| Профиль 30 × 30, заготовка 6000 мм | 3 | хлыст | требует уточнения | требует уточнения |
| Брусок 40 × 45, заготовка 2400 мм | 1 | заготовка | требует уточнения | требует уточнения |
| Брусок 45 × 90, заготовка 2400 мм | 2 | заготовка | требует уточнения | требует уточнения |
| Врезная петля HES3D-120BL, кандидат | 4 | шт. | требует уточнения | требует уточнения |
| Опоры, подбор по профилю | 4 | шт. | требует уточнения | требует уточнения |
| Соединения профилей, подбор узла | требует уточнения | компл. | требует уточнения | требует уточнения |
| Крепление деревянных стоек к профилю | требует уточнения | компл. | требует уточнения | требует уточнения |
| Крепление панелей, полок и задника | требует уточнения | компл. | требует уточнения | требует уточнения |
| Фиксаторы полок и бортиков в дверях | требует уточнения | компл. | требует уточнения | требует уточнения |
| Крепление шкафа от опрокидывания | требует уточнения | компл. | требует уточнения | требует уточнения |
| Раскрой и обработка деталей | 1 | заказ | требует уточнения | требует уточнения |
| Отделка | 1 | заказ | требует уточнения | требует уточнения |
| Доставка | 1 | заказ | требует уточнения | требует уточнения |

Цены пока не внесены. Итог сметы не рассчитан.

## Детали по модели

| Код | Габарит X × Y × Z, мм | Материал |
|---|---:|---|
| B00-bottom-notched | 964 × 500 × 18 | plywood-18 |
| B01-top-inset | 938 × 438 × 18 | plywood-18 |
| B02-left-pegboard | 18 × 438 × 969 | plywood-18 |
| B03-right-side | 18 × 438 × 969 | plywood-18 |
| B04-back | 964 × 8 × 964 | plywood-8 |
| B05-divider | 18 × 357 × 964 | plywood-18 |
| B10-left-shelf | 473 × 357 × 18 | plywood-18 |
| B11-left-shelf | 473 × 357 × 18 | plywood-18 |
| B20-right-shelf | 473 × 357 × 18 | plywood-18 |
| B21-right-shelf | 473 × 357 × 18 | plywood-18 |
| Beam-body-front | 940 × 30 × 30 | profile-30 |
| Beam-body-rear | 940 × 30 × 30 | profile-30 |
| Beam-body-side-0 | 30 × 440 × 30 | profile-30 |
| Beam-body-side-970 | 30 × 440 × 30 | profile-30 |
| Beam-lower-rear | 940 × 30 × 30 | profile-30 |
| Beam-lower-side-0 | 30 × 440 × 30 | profile-30 |
| Beam-lower-side-970 | 30 × 440 × 30 | profile-30 |
| Beam-top-front | 940 × 30 × 30 | profile-30 |
| Beam-top-rear | 940 × 30 × 30 | profile-30 |
| Beam-top-side-0 | 30 × 440 × 30 | profile-30 |
| Beam-top-side-970 | 30 × 440 × 30 | profile-30 |
| Foot-0-0 | 28 × 28 × 12 | foot |
| Foot-0-470 | 28 × 28 × 12 | foot |
| Foot-970-0 | 28 × 28 × 12 | foot |
| Foot-970-470 | 28 × 28 × 12 | foot |
| L-bottom-rail | 348.5 × 85 × 18 | plywood-18 |
| L-front-panel | 356.1 × 12 × 917.6 | plywood-12 |
| L-hinge-stile | 40 × 85 × 946 | wood-45x90 |
| L-jamb | 36 × 38 × 952 | wood-40x45 |
| L-lip-1 | 356.1 × 9 × 38 | plywood-9 |
| L-lip-2 | 356.1 × 9 × 38 | plywood-9 |
| L-lip-3 | 356.1 × 9 × 38 | plywood-9 |
| L-meeting-stile | 38 × 85 × 946 | wood-45x90 |
| L-shelf-1 | 356.1 × 58.2 × 12 | plywood-12 |
| L-shelf-2 | 356.1 × 58.2 × 12 | plywood-12 |
| L-shelf-3 | 356.1 × 58.2 × 12 | plywood-12 |
| L-top-rail | 348.5 × 85 × 18 | plywood-18 |
| Post-0-0 | 30 × 30 × 1788 | profile-30 |
| Post-0-470 | 30 × 30 × 1788 | profile-30 |
| Post-970-0 | 30 × 30 × 1788 | profile-30 |
| Post-970-470 | 30 × 30 × 1788 | profile-30 |
| R-bottom-rail | 348.5 × 85 × 18 | plywood-18 |
| R-front-panel | 356.1 × 12 × 917.6 | plywood-12 |
| R-hinge-stile | 40 × 85 × 946 | wood-45x90 |
| R-jamb | 36 × 38 × 952 | wood-40x45 |
| R-lip-1 | 356.1 × 9 × 38 | plywood-9 |
| R-lip-2 | 356.1 × 9 × 38 | plywood-9 |
| R-lip-3 | 356.1 × 9 × 38 | plywood-9 |
| R-meeting-stile | 38 × 85 × 946 | wood-45x90 |
| R-shelf-1 | 356.1 × 58.2 × 12 | plywood-12 |
| R-shelf-2 | 356.1 × 58.2 × 12 | plywood-12 |
| R-shelf-3 | 356.1 × 58.2 × 12 | plywood-12 |
| R-top-rail | 348.5 × 85 × 18 | plywood-18 |

## Раскрой длинномерных заготовок

| Материал | Заготовка | Детали по порядку, мм | Остаток, мм |
|---|---:|---|---:|
| profile-30 | 1 | Post-970-470 — 1788, Post-970-0 — 1788, Post-0-470 — 1788, Beam-top-side-970 — 440 | 164 |
| profile-30 | 2 | Post-0-0 — 1788, Beam-top-rear — 940, Beam-top-front — 940, Beam-lower-rear — 940, Beam-body-rear — 940 | 417 |
| profile-30 | 3 | Beam-body-front — 940, Beam-top-side-0 — 440, Beam-lower-side-970 — 440, Beam-lower-side-0 — 440, Beam-body-side-970 — 440, Beam-body-side-0 — 440 | 2822 |
| wood-40x45 | 1 | R-jamb — 958, L-jamb — 958 | 468 |
| wood-45x90 | 1 | R-meeting-stile — 952, R-hinge-stile — 952 | 480 |
| wood-45x90 | 2 | L-meeting-stile — 952, L-hinge-stile — 952 | 480 |
