padington/cambusa-cabinet/history/outputs/layout-cost-v10/ОСНОВАНИЕ.md

# Основание: детали, крепёж и подготовка

Чёрный профиль 30 × 30, паз 8, серия 30. Размер рамы в плане 920 × 410 мм, общая высота с опорами 800 мм. Все количества проектные до проверки узлов.

| Деталь / операция | Артикул | Количество к покупке | Сумма по строке | Источник |
|---|---|---:|---:|---|
| Чёрный профиль 30×30: три хлыста по 3020 мм | OB-3030-RAL9005 | 9.06 м | 10237.80 ₽ (Прайс) | [Страница](https://www.rsi-llc.ru/catalog/69/3522/) |
| Уголок 30×30 | 1037 | 18 шт | 1170.00 ₽ (Прайс) | [Страница](https://www.rsi-llc.ru/catalog/73/424/) |
| Чёрная покраска уголка |  | 18 шт | 900.00 ₽ (Прайс) | [Страница](https://www.rsi-llc.ru/catalog/73/424/) |
| Комплект: 2 Т-гайки 5006 + 2 винта М6×12 | 5006 + ISO7380 | 18 компл | 745.20 ₽ (Прайс) | [Страница](https://www.rsi-llc.ru/catalog/73/424/) |
| Дополнительные Т-гайки M6 для корпуса | 5006 | 10 шт | 139.00 ₽ (Прайс) | [Страница](https://www.rsi-llc.ru/catalog/85/193/) |
| Запасные винты М6×12 | ISO7380 M6×12 | 2 шт | 13.60 ₽ (Прайс) | [Страница](https://www.rsi-llc.ru/catalog/137/561/) |
| Чёрные крышки уголков | 1037cap/4050 | 18 шт | 640.80 ₽ (Прайс) | [Страница](https://www.rsi-llc.ru/catalog/158/449/) |
| Чёрная лента в пазы, верхний запас | 4048 | 30 м | 2400.00 ₽ (Прайс) | [Страница](https://www.rsi-llc.ru/catalog/76/) |
| Торцевые заглушки 30×30 | 4002 | 4 шт | 100.00 ₽ (Прайс) | [Страница](https://www.rsi-llc.ru/catalog/157/214/) |
| Регулируемые опоры М8×50, кандидат | D30M8H50 | 4 шт | 300.00 ₽ (Прайс) | [Страница](https://www.rsi-llc.ru/catalog/117/2178/) |
| Контргайка опоры M8 | 4398001 / DIN439 | 4 шт | 4.24 ₽ (Прайс) | [Страница](https://tdmtdm.ru/catalog/gayki/din_439_iso_4035_gayka_nizkaya/din439_m8_gayka_nizkaya_tsink/) |
| Потайные винты корпуса M6×25 | 00042770 / DIN7991 | 10 шт | 61.40 ₽ (Прайс) | [Страница](https://oniks-krep.ru/catalog/din_7991_a2/din_7991_vint_s_potajnoj_golovkoj_vnutr_shestigr_nerzh_a2_m6x25/) |
| Резка 11 отрезков и снятие заусенцев |  | 1 заказ | 1000.00 ₽ (Оценка) | [Страница](https://www.rsi-llc.ru/catalog/179/) |
| Резьба М8 в нижних торцах стоек |  | 4 шт | 200.00 ₽ (Прайс) | [Страница](https://www.rsi-llc.ru/catalog/179/) |

## Не задвоить крепёж

18 комплектов уголков содержат 36 винтов M6×12 и 36 Т-гаек. Дополнительно учтены только 2 запасных винта и 10 Т-гаек для 8 креплений корпуса и двух запасных. Винтов корпуса M6×25 покупаем 10: восемь рабочих и два запасных.

## Отрезки

- 4 стойки: 770 минус установленная высота опоры, мм.
- 3 поперечины по 860 мм.
- 2 верхних продольных профиля по 410 мм.
- 2 нижних продольных профиля по 350 мм.

Под смету куплены условно три целых хлыста по 3020 мм. Покупки не выполнялись. Для примера h=20 (стойки 750): хлыст 1 - 860+860+860; хлыст 2 - 750+750+750; хлыст 3 - 750+410+410+350+350. Даже с 3 мм на каждый из 11 резов всё помещается. Реальная карта резки пересчитывается после выбора опоры.

## Подготовка у поставщика

Порезать профили в согласованный размер, убрать заусенцы, подготовить резьбу М8 в четырёх нижних торцах и нарезать ленту пазов по свободным участкам. Центральный канал профиля, глубина резьбы и вкручивание опоры требуют сверки. Внутренние винты корпуса заводятся сверху через подготовленные отверстия в фанере в Т-гайки.

## Открытые вопросы

- D30M8H50: несогласованный диаметр на сайте и не проверенная установочная высота. Не выпускать длины стоек.
- 18 уголков: совместимые изделия найдены, но размещение в трёхсторонних углах, доступ ключа, жёсткость и нагрузка не проверены.
- 30 м ленты - верхний запас, не измеренный расход. Требуется нарезка поставщиком.
- Гайки DIN439: на странице есть цена поштучно, минимальную фасовку подтвердить.
- Крепление высокого шкафа от опрокидывания не спроектировано; резерв в смете не заменяет решения.

RSI отгружает из Челябинска, винты и контргайки найдены у продавцов СПб. Согласование поставщикам и покупка не выполнялись.
