padington/cambusa-cabinet/history/outputs/layout-cost-v10/РАСЧЁТ.md

# Раскладка и стоимость v10

**Габариты: 100 × 180 × 50 см. Основа формы v08, размеры деревянных заготовок из предложения v09.**

## Листы фанеры

| Толщина | Формат | Листов | Чистая площадь деталей | Цена листа | Всего |
|---|---|---:|---:|---:|---:|
| 18 мм | 1525 × 1525 | 3 | 3.919 м² | 3,000 ₽ | 9,000 ₽ |
| 12 мм | 1525 × 1525 | 1 | 1.471 м² | 2,350 ₽ | 2,350 ₽ |
| 9 мм | 1525 × 1525 | 1 | 0.563 м² | 1,800 ₽ | 1,800 ₽ |

Материал: **13 150 ₽**, берёзовая ФК 1/2 Ш2 по [прайсу НеваТорг](https://neva-torg.ru/tseny/). Сорт 1/2 выбран для более чистой видимой пласти; с обратной стороны возможны дефекты сорта 2. Визуальный отбор листов и фактическая толщина требуют подтверждения.

Три листа 18 мм нужны при заданном направлении рисунка. Семь крупных деталей длиннее половины полезной стороны листа; их ширины поперёк волокон суммарно 3248 мм против 3010 мм на двух листах. Это нижняя граница для этой ориентации, а не доказательство оптимальности для любых размеров и поворотов.

Раскладка: отступ 10 мм, зазор между контурами 8 мм, фреза до 6 мм. Проверены все 48 деталей, отсутствие наложений, зазоры, границы и направление рисунка. Карта рассчитана для ЧПУ, а не как последовательность гильотинных резов. Припуски на дополнительное шлифование или подрезку здесь не добавлены; изменение припусков требует пересчёта.

## Стоимость всего комплекта

| Раздел | Плановая сумма |
|---|---:|
| Фанера | 13,150 ₽ |
| Основание | 17,912 ₽ |
| Фурнитура | 25,055 ₽ |
| Обработка | 22,375 ₽ |
| Отделка | 21,745 ₽ |
| Прочее | 8,500 ₽ |
| **Итого до резерва** | **108,736 ₽** |
| **С резервом 20%** | **130,484 ₽** |

Из суммы до резерва 58,174 ₽ рассчитано по опубликованным ставкам, 50,562 ₽ - по явно помеченным допущениям. Это не подтверждённая цена заказа: количество фурнитуры и состав обработки ещё проектные. Прайсы взяты у разных поставщиков. Оплата, поставка и включение НДС проверяются в коммерческом предложении; отдельный налог сверху автоматически не добавлен.

Покрытие посчитано по обеим пластям, торцам и стенкам перфорации: около 12.79 м² × 1700 ₽/м². Ставка отделки - наша оценка, не предложение цеха. Точный цвет подбирать на пробе рядом со столом.

В смету входят материал, обработка отдельных деталей, фурнитура, подготовка профиля, отделка, упаковка, доставка и небольшой контрольный комплект. Сборка на стороне не заложена. Не включён второй полный шкаф или масштабная переработка конструкции после испытаний.

## Что есть в чертеже

Общий вид, размеры каждой группы деревянных заготовок, нумерация всех деталей, перфорация W04, пять карт раскладки и схема отрезков основания. Это чертёж контуров для обсуждения и расчёта. Присадки петель, Rastex, направляющих, крепления лотков, пазов днищ и ручек пока не выпущены, модель с ними не проверена. По одному этому PDF заказывать готовый к сборке комплект нельзя.

## Основание: комплектующие

Точный список со ссылками и составом упаковок - в ОСНОВАНИЕ.md. Опоры D30M8H50 оставлены кандидатами: на сайте конфликт диаметра 30/50 мм и не подтверждена установочная высота. Длина стойки 770 минус высота опоры. 750 мм на схеме - только пример при h=20, не размер для резки.

## Версии

v08 - выбранная форма; parts-v09 - подбор; layout-cost-v10 - этот расчёт раскладки и стоимости. Старые модели и документы сохранены без изменений.
