padington/cambusa-cabinet/history/outputs/parts-spec-v09/ДЕТАЛИ.md

# Детали Cambusa — подбор v09

**Основа формы — v08: 100 × 180 × 50 см, корпус 100 см на основании 80 см, без колёс.**

Это список кандидатов и проектных количеств для расчёта комплекта. Контуры, присадка, опоры и жёсткость основания ещё не утверждены; список пока нельзя использовать как окончательную корзину полного заказа. Поставщикам ничего не отправлено.

## Где заказывать

- **Фанера и все отверстия:** [Лекс Мебель, СПб](https://raspil78.ru/prisadka/), Михайловский пер., 7А, лит. В. Запасной вариант — [Звено, СПб](https://zveno-web.ru/frezerovka/frezerovka-fanery/). Выполнение конкретной присадки и отделки ещё не подтверждено.
- **Профиль и совместимый крепёж:** RSI, производство/отгрузка из Челябинска. Это поставщик с доставкой, не найденный склад в СПб.
- **Петли и планки в СПб:** Мебель Комплект / ФКМ. **Направляющие в СПб:** ТДМ перечисляет точный комплект; резерв — Furnion из Москвы. Цены и остатки различаются.
- **Эксцентрики:** Hettich через ТД Сервер / Партнёр. Шток 48037 технически найден у производителя, розничная поставка в СПб отдельно не подтверждена.

## Фанера

| Толщина | Деталей | Чистая площадь заготовок |
|---|---:|---:|
| 9 мм | 26 | 0.563 м² |
| 12 мм | 11 | 1.471 м² |
| 18 мм | 11 | 3.919 м² |

Всего 48 деревянных деталей. Площадь дана без отходов, пропилов и ориентации рисунка; это не количество листов. Сорт, фактическую толщину и тёмную матовую отделку согласовать на образце. Предлагаемые изменения заготовок перечислены ниже и в wood-parts-proposal.json.

[Размеры деревянных заготовок](ФАНЕРА.md) · [Оговорки по каждой позиции и состав комплектов](ПРИМЕЧАНИЯ.md)

Количество ниже включает небольшой запас там, где он предусмотрен. Точные потребность и запас разделены в примечаниях. Ссылки на технические документы подтверждают характеристики; они не означают найденную розничную поставку.

## Основание

| Позиция | Артикул / размер | Предварительная закупка | Цена на странице |
|---|---|---:|---:|
| A01 · [Профиль чёрный 30×30, серия 30, паз 8](https://www.rsi-llc.ru/catalog/69/3522/) | RSI OB-3030-RAL9005 | 7.164 м | 1130.00 ₽/м |
| A02 · [Угловой соединитель 30×30](https://www.rsi-llc.ru/catalog/73/424/) | RSI 1037 | 18 шт | 65.00 ₽/шт |
| A03 · [Чёрная покраска соединителей](https://www.rsi-llc.ru/catalog/73/424/) | RAL9005 муар, опция RSI | 18 шт | 50.00 ₽/шт |
| A04 · [Т-гайки, паз 8, серия 30, M6](https://www.rsi-llc.ru/catalog/85/193/) | RSI 5006 | 50 шт | не подтверждена |
| A05 · [Винт M6×12 с полукруглой головкой](https://www.rsi-llc.ru/catalog/137/561/) | ISO7380, класс 10.9 | 40 шт | не подтверждена |
| A06 · [Крышка уголка, скрывает винты](https://www.rsi-llc.ru/catalog/73/424/) | RSI 1037cap/4050 | 18 шт | 35.60 ₽/шт |
| A07 · [Лента, закрывающая открытые пазы](https://www.rsi-llc.ru/catalog/76/) | RSI 4048 чёрный | 30 м | 80.00 ₽/м |
| A08 · [Торцевые заглушки 30×30, чёрные](https://www.rsi-llc.ru/catalog/69/) | совместимые с OB-3030 | 4 шт | не подтверждена |
| A09 · [Регулируемые опоры M8](https://www.rsi-llc.ru/catalog/117/2178/) | RSI D30M8H50 | 4 шт | 75.00 ₽/шт |
| A10 · Контргайки опор M8 | DIN439 / ISO4035 M8 | 4 шт | не подтверждена |
| A11 · Крепление деревянного корпуса к верхнему кольцу | M6×25 потай ISO10642 / DIN7991 | 10 шт | не подтверждена |

## Корпус

| Позиция | Артикул / размер | Предварительная закупка | Цена на странице |
|---|---|---:|---:|
| B01 · [Эксцентрик для фанеры 18 мм](https://www.grouppartner.ru/catalog/krepezhnaya-furnitura/ekstsentrikovye-styazhki/hettich_9/styazhka-ekstsentrikovaya-rastex-15-polka-18-mm-bez-burtika-tsinkovoe-li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) | Hettich Rastex 15/18, 9056599 | 40 шт | не подтверждена |
| B02 · [Шток эксцентрика, зажим 20 мм](https://shop.hettich.com/us_EN/Further-products/Connecting-technology/Connecting-fittings-for-cabinet-bodies/Rastex-eccentric-connecting-fitting/Rastex-15-dowels/Scr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) | Hettich Twister DU319T, 48037 | 60 шт | не подтверждена |
| B03 · Деревянные шканты без клея | бук 8×30 | 50 шт | не подтверждена |
| B04 · Крепление задней стенки | шуруп 3,5×30, потай | 30 шт | не подтверждена |
| B05 · [Заглушки эксцентриков под тёмное дерево](https://hettich-shop.ru/soedinitelnaya-furnitura/532/ekstsentrikovye-styazhki-rastex-15/ekstsentriki.html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) | совместимые с Rastex15/18 | 40 шт | не подтверждена |

## Дверцы

| Позиция | Артикул / размер | Предварительная закупка | Цена на странице |
|---|---|---:|---:|
| C01 · [Накладная петля с нулевым вхождением, 155°](https://spb-mk.ru/catalog/furnitura_blum/petli_blum/petli_blum_clip_top_blumotion_s_dovodchikom/) | Blum 71B7550 | 8 шт | 1130.35 ₽/шт |
| C02 · [Монтажная планка CLIP, высота 0 мм](https://fkmspb.ru/brend/blum/page/82/) | Blum 173H7100 | 8 шт | 108.10 ₽/шт |
| C03 · Саморезы петель и монтажных планок | 3,5×16, PZ2 | 40 шт | не подтверждена |
| C04 · [Врезные чёрные ручки — вариант вместо условных прорезей](https://www.mdm-complect.ru/catalog/ruchki/filter/tip-krepleniya-is-vreznoy-montazh-or-vreznoy-montazh-vintami-or-vreznoy-montazh-samorezami/tsvetovaya-gamma-is-cher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) | PULSE SH.04.121.BLM | 2 шт | 471.71 ₽/шт |
| C05 · [Прозрачные буферы](https://www.mdm-complect.ru/catalog/) | силиконовые самоклеящиеся, тонкие | 8 шт | не подтверждена |

## Ящики

| Позиция | Артикул / размер | Предварительная закупка | Цена на странице |
|---|---|---:|---:|
| D01 · [Полное выдвижение, доводчик, номинал 350 мм](https://furnion.ru/komplekt-napravlyayushchikh-tandem-poln-vydvizheniya-s-dovodchikom-s-zamkami-560h3500bt511703/) | Blum 560H3500B + 2×T51.1700.04 | 2 комплект на ящик | 4546.82 ₽/комплект на ящик |
| D02 · [Крепёж направляющих к корпусу](https://d2.blum.com/services/BEC003/me16460573_ep_dok_bau_%24sru_%24aof_%24v4.pdf) | под крепёжные отверстия Blum; предварительно 4×16 | 16 шт | не подтверждена |
| D03 · [Крепёж передних замков](https://d2.blum.com/services/BEC003/me16460573_ep_dok_bau_%24sru_%24aof_%24v4.pdf) | по монтажному листу T51.1700.04 | 10 шт | не подтверждена |
| D04 · [Эксцентрик для стенок 12 мм](https://www.tdserver.ru/catalog/krepezhnaya_furnitura/krepezh_raznyy/ekstsentrikovaya_styazhka_rastex_15_dlya_plit_12_mm_bez_pokrytiya_art_9116019_hettich/) | Hettich Rastex15/12, 9116019 | 20 шт | не подтверждена |
| D05 · Крепление внутренних фасадов к коробам | предварительно саморез 3,5×20 | 10 шт | не подтверждена |

## Лотки на дверцах

| Позиция | Артикул / размер | Предварительная закупка | Цена на странице |
|---|---|---:|---:|
| E01 · [Малый металлический уголок](https://www.ozon.ru/product/ugolok-krepezhnyy-kronshteyn-pmk-tsink-20h20h15-mm-8-sht-v-upak-mebelnyy-krepezhnyy-ugolok-usilennyy-5157956769/) | ПМК / 20×20×15, толщина 1,5 мм | 40 шт | не подтверждена |
| E02 · Короткие шурупы в фанеру 9 мм | 3×8, полукруглая головка | 70 шт | не подтверждена |
| E03 · Крепление лотков к дверцам | 3,5×16, полукруглая головка | 16 шт | не подтверждена |

## Устойчивость

| Позиция | Артикул / размер | Предварительная закупка | Цена на странице |
|---|---|---:|---:|
| F01 · Фиксация от опрокидывания или проверенное самостоятельное решение | пока не выбран | уточнить | не подтверждена |

## Инструмент

| Позиция | Артикул / размер | Предварительная закупка | Цена на странице |
|---|---|---:|---:|
| F02 · Набор для домашней сборки | шестигранник 4 мм, PZ2; ключ 13 мм для контргаек | 1 набор | не подтверждена |

## Что изменяется относительно эскиза

1. **Днища ящиков:** в модели они были условными накладными. Под выбранный TANDEM предлагаются дно 9 мм в пазах и утопление 13 мм (в диапазоне 12–15 из документации). Предварительный размер каждого дна 437 × 322 мм при пазах по 3 мм. Это наша расчётная геометрия, не универсальный размер Blum. Нужны задние вырезы и отверстия под зацепы по монтажному листу.
2. **Задник:** предлагается сделать его накладным 1000 × 1000 × 12 мм, сократив глубину верхней/нижней панелей и боковин на 12 мм. Внешние 500 мм сохраняются; задник устанавливается последним снаружи. Старый задник между стенками нельзя просто прикрутить в воздух.
3. **Опоры:** D30M8H50 заменяют условные подпятники 4 мм. Установочная высота пока не подтверждена. Длина стойки должна быть **770 мм минус установленная высота опоры**; 766 мм из v08 не передавать в резку автоматически.
4. **Уголки основания:** предложено 18 шт с крышками и совместимыми винтами. Это не проверка жёсткости основания. Раскладка трёхсторонних узлов и доступ ключа должны быть подтверждены в CAD и на одном углу.
5. **Лотки:** 6 малых уголков на каждый лоток — только схема для пробного образца. Их внешний вид и удержание в фанере 9 мм ещё не проверены. Окончательные отверстия лотков не выпущены.
6. **Двери:** план 4 петли на дверцу. Масса с лотками, наложение, реальная траектория и положение отверстий относительно перфорации требуют расчёта. Тормоза и колёса в этот комплект не входят.

## Цены: что можно считать

Только три крупные позиции: 7,164 м профиля × 1130 + 8 петель × 1130,35 + 2 комплекта направляющих с замками × 4546,82 = **26 231,76 ₽**. Это частичная сумма, не цена всего шкафа: без фанеры, отделки, обработки, планок, остального крепежа и доставки. При оплате трёх целых хлыстов 3020 мм стоимость профиля считается по 9,06 м; выше использована чистая длина из эскиза. Все опубликованные цены — ориентир на дату поиска, без резервирования склада.

## Проверенные технические источники

- [Blum TANDEM, заказ и проектирование, страницы 20–22](https://d2.blum.com/services/BEC003/me16460573_ep_dok_bau_%24sru_%24aof_%24v4.pdf): 560H3500B, замки T51.1700.04, толщина стенок 11–16, ширина SKW = LW − 42, длина SKL = NL − 10.
- [Blum 155° с нулевым вхождением](https://d2.blum.com/services/BEC003/clp0034-fl-335_fl_dok_bau_%24sru_%24aof_%24v2.pdf): семейство и артикул 71B7550.
- [Hettich — присадка Rastex для толщин 12 и 18 мм](https://catalog.hettich.com/General/TuI/ru_RU/catalogs/TuI_ru_RU/pdf/save/bk_1265.pdf).
- [Чертёж RSI 1037](https://www.rsi-llc.ru/catalog/corner/1037.PDF) и комплекты 5006 + M6×12 на странице товара.

## Следующий выпуск

Чтобы выпустить полный заказ: сверить чертёж опоры, спроектировать и проверить один угол основания, присадить петли с лотками и все камовые соединения, сделать контрольный ящик и лоток, затем назначить нагрузку и способ обеспечения устойчивости. До этого можно запрашивать цены и заказывать отдельные контрольные комплектующие.
