padington/cambusa-cabinet/history/outputs/parts-spec-v09/ПРИМЕЧАНИЯ.md

# Проверки и состав каждой позиции

Это пояснения к предварительному подбору v09, а не подтверждение готовности к заказу.

## A01 · Профиль чёрный 30×30, серия 30, паз 8

**RSI OB-3030-RAL9005**. Статус: кандидат выбран; присадка не выпущена.

Проектная потребность: 7.164 м; закупка с запасом: 7.164 м.

11 отрезков. 7,164 м — длина из v08; четыре стойки пересчитываются под настоящие опоры. Если продают только хлысты — нужно 3 хлыста по 3020 мм; цена по целым хлыстам, резка и доставка отдельно.

## A02 · Угловой соединитель 30×30

**RSI 1037**. Статус: кандидат выбран; присадка не выпущена.

Проектная потребность: 18 шт; закупка с запасом: 18 шт.

Предложенная схема: 4 соединителя верхнего кольца + 8 для стоек в двух плоскостях + 6 концов нижних связей. Количество и отсутствие конфликтов ещё проверить в CAD.

## A03 · Чёрная покраска соединителей

**RAL9005 муар, опция RSI**. Статус: кандидат выбран; присадка не выпущена.

Проектная потребность: 18 шт; закупка с запасом: 18 шт.

Доплата к цене 1037; необязательна при использовании закрывающих крышек.

## A04 · Т-гайки, паз 8, серия 30, M6

**RSI 5006**. Статус: кандидат выбран; присадка не выпущена.

Проектная потребность: 44 шт; закупка с запасом: 50 шт.

36 под 18 уголков + 8 под крепление корпуса. Цена 41,40 руб. за комплект 2 гайки + 2 винта на странице 1037; отдельную цену здесь не дублируем.

## A05 · Винт M6×12 с полукруглой головкой

**ISO7380, класс 10.9**. Статус: кандидат выбран; присадка не выпущена.

Проектная потребность: 36 шт; закупка с запасом: 40 шт.

Пара гайка 5006 + винт M6×12 прямо рекомендована продавцом для 1037. 18 комплектов по 41,40 руб.; не покупать гайки и винты ещё раз при заказе этих комплектов.

## A06 · Крышка уголка, скрывает винты

**RSI 1037cap/4050**. Статус: кандидат выбран; присадка не выпущена.

Проектная потребность: 18 шт; закупка с запасом: 18 шт.

Чёрный цвет и покрытие уточнить; совмещать с нужным вариантом 1037.

## A07 · Лента, закрывающая открытые пазы

**RSI 4048 чёрный**. Статус: кандидат выбран; присадка не выпущена.

Проектная потребность: уточнить м; закупка с запасом: 30 м.

30 м — верхний запас на 4 стороны 7,164 м профиля. Нужна нарезка поставщиком под свободные участки пазов; в местах крепежа ленту не ставят. Это предел закупки, не измеренный расход.

## A08 · Торцевые заглушки 30×30, чёрные

**совместимые с OB-3030**. Статус: тип найден; конкретный артикул открыт.

Проектная потребность: 4 шт; закупка с запасом: 4 шт.

Четыре открытых торца верхних продольных профилей. Артикул не подтверждён.

## A09 · Регулируемые опоры M8

**RSI D30M8H50**. Статус: кандидат; чертёж опоры требует проверки.

Проектная потребность: 4 шт; закупка с запасом: 4 шт.

В названии основание 30 мм, в поле характеристики 50 мм: противоречие сайта. PDF по ссылке не открылся. До сверки чертежа не утверждены диаметр, установочная высота и длины стоек.

## A10 · Контргайки опор M8

**DIN439 / ISO4035 M8**. Статус: кандидат выбран; присадка не выпущена.

Проектная потребность: 4 шт; закупка с запасом: 4 шт.

Нужен ключ 13 мм. Проверить, входят ли в опоры, и не дублировать.

## A11 · Крепление деревянного корпуса к верхнему кольцу

**M6×25 потай ISO10642 / DIN7991**. Статус: стандарт выбран; длина и точки не выпущены.

Проектная потребность: 8 шт; закупка с запасом: 10 шт.

8 винтов и 8 гаек 5006 уже учтены в A04. Предварительные точки: 4 на передней/задней балках и 4 на боковых. Утопленная головка внутри корпуса. Длина под фактическую фанеру и заглубление резьбы требует сверки.

## B01 · Эксцентрик для фанеры 18 мм

**Hettich Rastex 15/18, 9056599**. Статус: кандидат выбран; присадка не выпущена.

Проектная потребность: 32 шт; закупка с запасом: 40 шт.

16 креплений топ/дно к боковинам и перегородке + 16 на четыре полки. Число проектное; шканты и коллизии с перфорацией проверяются при присадке.

## B02 · Шток эксцентрика, зажим 20 мм

**Hettich Twister DU319T, 48037**. Статус: технический артикул найден; местная поставка не подтверждена.

Проектная потребность: 48 шт; закупка с запасом: 60 шт.

32 в корпус + 16 в ящики. Производитель: отверстие 5 мм; длина зажима 20 мм. Это не полная длина штока. Розничный продавец этой позиции в СПб не подтверждён.

## B03 · Деревянные шканты без клея

**бук 8×30**. Статус: стандарт; точный поставщик и посадка открыты.

Проектная потребность: 36 шт; закупка с запасом: 50 шт.

Проектно 28 в корпус и 8 в ящики. Требуется проба ручной посадки; фанера и отверстия должны быть подготовлены поставщиком.

## B04 · Крепление задней стенки

**шуруп 3,5×30, потай**. Статус: стандарт; требуется изменить заготовки задника и четырёх деталей корпуса.

Проектная потребность: 21 шт; закупка с запасом: 30 шт.

Для предложенной накладной задней стенки: 16 по периметру + 5 в центральную перегородку. Пилоты и зенковки выполняет поставщик. В v08 задник был между стенками — тот вариант нельзя просто прикрутить сзади.

## B05 · Заглушки эксцентриков под тёмное дерево

**совместимые с Rastex15/18**. Статус: кандидат выбран; присадка не выпущена.

Проектная потребность: 32 шт; закупка с запасом: 40 шт.

Только внутри. Крышки для 18 мм не переносить автоматически на низкий Rastex15/12.

## C01 · Накладная петля с нулевым вхождением, 155°

**Blum 71B7550**. Статус: кандидат выбран; присадка не выпущена.

Проектная потребность: 8 шт; закупка с запасом: 8 шт.

План: 4 на дверцу высотой 992 мм с лотками. Это запас для расчёта, не подтверждённая грузоподъёмность. Цена и наличие найдены в индексируемом каталоге СПб; сама карточка при открытии недоступна. Количество проверить по массе дверей и лотков.

## C02 · Монтажная планка CLIP, высота 0 мм

**Blum 173H7100**. Статус: кандидат; окончательная пара и присадка открыты.

Проектная потребность: 8 шт; закупка с запасом: 8 шт.

Поставка СПб. Крестовая планка на саморезы. Наложение 16 мм, сверление чашки и допустимость лотков нужно сверить в конфигураторе/чертежах Blum.

## C03 · Саморезы петель и монтажных планок

**3,5×16, PZ2**. Статус: кандидат выбран; присадка не выпущена.

Проектная потребность: 32 шт; закупка с запасом: 40 шт.

По 2 на чашку и 2 на планку. Окончательную длину сверить с крепёжными отверстиями выбранных петель.

## C04 · Врезные чёрные ручки — вариант вместо условных прорезей

**PULSE SH.04.121.BLM**. Статус: кандидат для согласования посадки.

Проектная потребность: 2 шт; закупка с запасом: 2 шт.

Эта ручка не равна прорези модели v08: размеры кармана и крепёж брать из её чертежа. Альтернатива — изготовить удобный фрезерованный хват и заднюю накладку; не покупать оба варианта.

## C05 · Прозрачные буферы

**силиконовые самоклеящиеся, тонкие**. Статус: тип выбран; артикул открыт.

Проектная потребность: 4 шт; закупка с запасом: 8 шт.

Для контакта дверец с корпусом. Толщину согласовать с зазором; не менять фасады случайным толстым буфером.

## D01 · Полное выдвижение, доводчик, номинал 350 мм

**Blum 560H3500B + 2×T51.1700.04**. Статус: кандидат выбран; присадка не выпущена.

Проектная потребность: 2 комплект на ящик; закупка с запасом: 2 комплект на ящик.

Один комплект — левая/правая направляющие + два замка; всего 4 направляющие и 4 замка. Не покупать замки отдельно второй раз. У продавца указано наличие; доставка из Москвы в СПб отдельно. В СПб точная позиция с замками также перечислена ТДМ: https://tdmspb.ru/catalog/products/50109/; карточка не открылась, цена/остаток не подтверждены.

## D02 · Крепёж направляющих к корпусу

**под крепёжные отверстия Blum; предварительно 4×16**. Статус: количество проектное; монтажный лист не выпущен.

Проектная потребность: 12 шт; закупка с запасом: 16 шт.

Три винта на направляющую — план для расчёта. Тип головки и используемые отверстия определяются монтажным листом.

## D03 · Крепёж передних замков

**по монтажному листу T51.1700.04**. Статус: точный саморез требует сверки с фиксаторами.

Проектная потребность: 8 шт; закупка с запасом: 10 шт.

Нужны четыре левых/правых замка всего, они включены в D01. Саморезы не считать частью комплекта без проверки упаковки.

## D04 · Эксцентрик для стенок 12 мм

**Hettich Rastex15/12, 9116019**. Статус: кандидат выбран; присадка не выпущена.

Проектная потребность: 16 шт; закупка с запасом: 20 шт.

Два крепления на угол, четыре угла на ящик. Штоки уже учтены в B02. Не заменять версией для 18 мм. На сайте можно выбрать СПб; остаток не подтверждён.

## D05 · Крепление внутренних фасадов к коробам

**предварительно саморез 3,5×20**. Статус: предложение; положение и длина после уточнения фасада.

Проектная потребность: 8 шт; закупка с запасом: 10 шт.

Через стенку 12 в фасад 12 мм: около 8 мм заглубления. Четыре на фасад; отверстия для регулировки должны быть подготовлены.

## E01 · Малый металлический уголок

**ПМК / 20×20×15, толщина 1,5 мм**. Статус: только кандидат для пробного лотка.

Проектная потребность: 36 шт; закупка с запасом: 40 шт.

План: по 6 на лоток — 2 к дверце, 2 к переднему борту, по 1 к бокам. 5 упаковок по 8 шт. Покрытие, размеры отверстий и возможность скрыть уголки требуют проверки. Это новая схема, её нет в CAD v08.

## E02 · Короткие шурупы в фанеру 9 мм

**3×8, полукруглая головка**. Статус: длина проектная; совместимость отверстий уголка проверить.

Проектная потребность: 60 шт; закупка с запасом: 70 шт.

При уголке 1,5 мм заглубление около 6,5 мм. Головка должна перекрывать отверстие; при необходимости добавляются шайбы. Не заменять 16 мм — выйдут насквозь.

## E03 · Крепление лотков к дверцам

**3,5×16, полукруглая головка**. Статус: проектная схема.

Проектная потребность: 12 шт; закупка с запасом: 16 шт.

По 2 вертикальных крепления на лоток при схеме E01. Рабочая нагрузка лотков не назначена; нужен образец.

## F01 · Фиксация от опрокидывания или проверенное самостоятельное решение

**пока не выбран**. Статус: открытый конструктивный пункт.

Проектная потребность: уточнить комплект; закупка с запасом: уточнить комплект.

Не выбрана конструкция и тип стены. Не подменять это молча сверлением дома: при настенном варианте нужны готовые подходящие точки либо отдельная согласованная установка.

## F02 · Набор для домашней сборки

**шестигранник 4 мм, PZ2; ключ 13 мм для контргаек**. Статус: состав по выбранной фурнитуре.

Проектная потребность: 1 набор; закупка с запасом: 1 набор.

Проверить шлицы каждого реального винта. Изготовительные сверла, фрезы, дрель и пила в домашний комплект не входят.
