padington/cambusa-cabinet/history/outputs/parts-spec-v09/ФАНЕРА.md

# Деревянные заготовки v09

**48 отдельных деталей; предварительные размеры для расчёта. Не карта раскроя и не файлы изготовления.**

Все размеры в миллиметрах. Чистовые размеры и зазоры уточняются с присадкой под реальные петли, стяжки и направляющие. Тёмная отделка и отверстия выполняются до доставки; дома — соединение подготовленных деталей.

| Код | Деталь | Заготовка | Толщина | Количество |
|---|---|---:|---:|---:|
| B00-bottom | Нижняя панель | 1000 × 468 | 18 | 1 |
| B01-top | Верхняя панель | 1000 × 468 | 18 | 1 |
| B02-left-side | Левая боковина | 468 × 964 | 18 | 1 |
| B03-right-pegboard | Правая боковина с перфорацией | 468 × 964 | 18 | 1 |
| B04-back | Накладной задник | 1000 × 1000 | 12 | 1 |
| B05-divider | Центральная перегородка | 384 × 964 | 18 | 1 |
| B10-left-shelf | Полка | 473 × 384 | 18 | 1 |
| B11-left-shelf | Полка | 473 × 384 | 18 | 1 |
| B20-right-shelf | Полка | 473 × 384 | 18 | 1 |
| B21-right-shelf | Полка | 473 × 384 | 18 | 1 |
| B30-door | Дверца | 496 × 992 | 18 | 1 |
| T00-bottom | Лоток: дно | 404 × 65 | 9 | 1 |
| T00-lip | Лоток: передний борт | 404 × 40 | 9 | 1 |
| T00-left | Лоток: боковая стенка | 56 × 40 | 9 | 1 |
| T00-right | Лоток: боковая стенка | 56 × 40 | 9 | 1 |
| T01-bottom | Лоток: дно | 404 × 65 | 9 | 1 |
| T01-lip | Лоток: передний борт | 404 × 40 | 9 | 1 |
| T01-left | Лоток: боковая стенка | 56 × 40 | 9 | 1 |
| T01-right | Лоток: боковая стенка | 56 × 40 | 9 | 1 |
| T02-bottom | Лоток: дно | 404 × 65 | 9 | 1 |
| T02-lip | Лоток: передний борт | 404 × 40 | 9 | 1 |
| T02-left | Лоток: боковая стенка | 56 × 40 | 9 | 1 |
| T02-right | Лоток: боковая стенка | 56 × 40 | 9 | 1 |
| B31-door | Дверца | 496 × 992 | 18 | 1 |
| T10-bottom | Лоток: дно | 404 × 65 | 9 | 1 |
| T10-lip | Лоток: передний борт | 404 × 40 | 9 | 1 |
| T10-left | Лоток: боковая стенка | 56 × 40 | 9 | 1 |
| T10-right | Лоток: боковая стенка | 56 × 40 | 9 | 1 |
| T11-bottom | Лоток: дно | 404 × 65 | 9 | 1 |
| T11-lip | Лоток: передний борт | 404 × 40 | 9 | 1 |
| T11-left | Лоток: боковая стенка | 56 × 40 | 9 | 1 |
| T11-right | Лоток: боковая стенка | 56 × 40 | 9 | 1 |
| T12-bottom | Лоток: дно | 404 × 65 | 9 | 1 |
| T12-lip | Лоток: передний борт | 404 × 40 | 9 | 1 |
| T12-left | Лоток: боковая стенка | 56 × 40 | 9 | 1 |
| T12-right | Лоток: боковая стенка | 56 × 40 | 9 | 1 |
| D0-left | Ящик: боковая стенка | 340 × 110 | 12 | 1 |
| D0-right | Ящик: боковая стенка | 340 × 110 | 12 | 1 |
| D0-front | Ящик: передняя стенка | 431 × 110 | 12 | 1 |
| D0-rear | Ящик: задняя стенка | 431 × 110 | 12 | 1 |
| D0-bottom | Ящик: дно | 437 × 322 | 9 | 1 |
| D0-face | Ящик: внутренний фасад | 465 × 142 | 12 | 1 |
| D1-left | Ящик: боковая стенка | 340 × 110 | 12 | 1 |
| D1-right | Ящик: боковая стенка | 340 × 110 | 12 | 1 |
| D1-front | Ящик: передняя стенка | 431 × 110 | 12 | 1 |
| D1-rear | Ящик: задняя стенка | 431 × 110 | 12 | 1 |
| D1-bottom | Ящик: дно | 437 × 322 | 9 | 1 |
| D1-face | Ящик: внутренний фасад | 465 × 142 | 12 | 1 |

## Предлагаемые изменения после v08

- **B00-bottom**: Предложено сократить глубину на 12 мм под накладной задник.
- **B01-top**: Предложено сократить глубину на 12 мм под накладной задник.
- **B02-left-side**: Предложено сократить глубину на 12 мм под накладной задник; отверстия задней колонки проверить.
- **B03-right-pegboard**: Предложено сократить глубину на 12 мм под накладной задник; отверстия задней колонки проверить.
- **B04-back**: Предложен накладной задник: можно прикрутить снаружи в торцы корпуса, сохраняя общую глубину 500 мм.
- **D0-bottom**: Размер при пазах глубиной 3 мм: (431+6) × (340-24+6). Дно в пазах, ниже дна оставить 13 мм до нижней кромки стенок; уточнить детали под Blum.
- **D1-bottom**: Размер при пазах глубиной 3 мм: (431+6) × (340-24+6). Дно в пазах, ниже дна оставить 13 мм до нижней кромки стенок; уточнить детали под Blum.

Модель v08 сохранена как утверждённая форма; перечисленные изменения ещё не внесены в новую модель с крепежом. Направление волокон, кромки, пазы, отверстия и раскрой на листы здесь не заданы.
