padington/cambusa-cabinet/history/outputs/layout-cost-v10/Чертежи-и-раскладка-v10.pdf

# Деревянные детали и раскладка

### 1000 × 1800 × 500 мм · корпус 1000 + основание 800 · без колёс

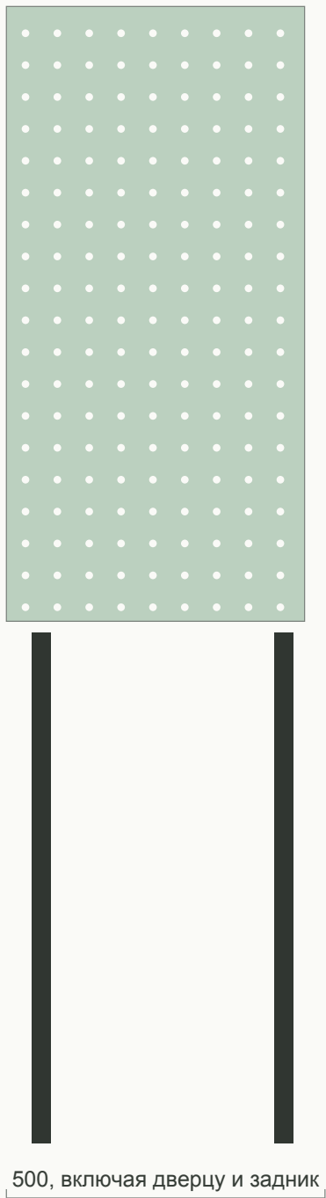
[picture p32: figure]
500, включая дверцу и задник

Cambusa · v10 · 03.11.2026 · мм · предварительные контуры; присадка не выпущена | Лист 1

W02 · верх

W01 · дно

W06

1000

1800

800 1000

### Вид спереди, дверцы условно сняты

### Вид справа, W04

В комплекте 48 деревянных деталей.

Фанера ФК, берёза, шлифовка с двух сторон.

18 мм: корпус, двери, полки, перегородка.

12 мм: задник, стенки и фасады ящиков.

9 мм: днища ящиков и шесть дверных лотков.

Стрелки на деталях показывают рисунок шпона.

Размеры - заготовки до присадки и отделки.

Глубина боковин 468 + 20 спереди + 12 сзади = 500.

Изменения v09: накладной задник и днища в пазах.

### Присадка стяжек, петель, направляющих и ручек

должна быть выпущена после проверки фурнитуры.

Допуски и припуски согласовать с изготовителем.

Полная ведомость, цены и источники - в смете.

Карта раскроя рассчитана под фрезу до 6 мм.

Зазор между контурами 8 мм; от края 10 мм.

Мелкие детали требуют технологического крепления.

# Детали из фанеры 18 мм

Прямоугольные контуры и направление рисунка · размеры в мм · номера соответствуют раскладке

Cambusa · v10 · 03.11.2026 · мм · предварительные контуры; присадка не выпущена | Лист 2

1000

468

W01, W02 · 2 шт.

Верх и дно корпуса · толщина 18

468

964

W03 · 1 шт.

Левая боковина · толщина 18

468

964

W04 · 1 шт.

Правая перфопанель · толщина 18

171 × Ø12; шаг 50; начало: X30, Y22 от нижнего левого угла

384

964

W06 · 1 шт.

Перегородка · толщина 18

473

384

W07, W08, W09, W10 · 4 шт.

Полка · толщина 18

496

992

W11, W24 · 2 шт.

Дверца · толщина 18

Для W04: вид снаружи, нижний левый угол - база. Отверстия Ø12 сквозные. Петли и стяжки проверить на конфликт с сеткой.

# Детали из фанеры 12 мм

Прямоугольные контуры и направление рисунка · размеры в мм · номера соответствуют раскладке

Cambusa · v10 · 03.11.2026 · мм · предварительные контуры; присадка не выпущена | Лист 3

1000

1000

W05 · 1 шт.

Задняя стенка · толщина 12

340

110

W37, W38, W43, W44 · 4 шт.

Ящик: боковина · толщина 12

431

110

W39, W45 · 2 шт.

Ящик: передняя стенка · толщина 12

431

110

W40, W46 · 2 шт.

Ящик: задняя стенка · толщина 12

465

142

W42, W48 · 2 шт.

Ящик: фасад · толщина 12

Для W04: вид снаружи, нижний левый угол - база. Отверстия Ø12 сквозные. Петли и стяжки проверить на конфликт с сеткой.

# Детали из фанеры 9 мм

Прямоугольные контуры и направление рисунка · размеры в мм · номера соответствуют раскладке

Cambusa · v10 · 03.11.2026 · мм · предварительные контуры; присадка не выпущена | Лист 4

404

65

W12, W16, W20, W25, W29, W33 · 6 шт.

Лоток: дно · толщина 9

404

40

W13, W17, W21, W26, W30, W34 · 6 шт.

Лоток: передний борт · толщина 9

56

40

W14, W15, W18, W19, W22, W23, W27, W28, W31, W32, W35, W36 · 12 шт.
Лоток: боковина · толщина 9

437

322

W41, W47 · 2 шт.

Ящик: дно · толщина 9

Для W04: вид снаружи, нижний левый угол - база. Отверстия Ø12 сквозные. Петли и стяжки проверить на конфликт с сеткой.

# Раскладка S18-1: фанера 18 мм

### Лист 1525 × 1525 · 6 деталей · заполнение заготовками 72.5%

Cambusa · v10 · 03.11.2026 · мм · предварительные контуры; присадка не выпущена | Лист 5

W02

1000×468

W07

473×384

W08

473×384

W09

473×384

W10

473×384

W24

496×992

1525

1525

Рисунок шпона вдоль стрелки

### Код / деталь / исходный размер / положение нижнего левого угла X,Y

W02 Верх корпуса 1000×468 (402; 491)

W07 Полка 473×384 (402; 10)

W08 Полка 473×384 (10; 972)

W09 Полка 473×384 (10; 10)

W10 Полка 473×384 (10; 491)

W24 Дверца 496×992 (878; 10)

Зазоры 8 мм; край 10 мм. При смене фрезы, припусков, волокон или размеров нужен новый расчёт.

# Раскладка S18-2: фанера 18 мм

### Лист 1525 × 1525 · 3 деталей · заполнение заготовками 60.7%

Cambusa · v10 · 03.11.2026 · мм · предварительные контуры; присадка не выпущена | Лист 6

W01
1000×468 W03

468×964

W11

496×992

1525

1525

Рисунок шпона вдоль стрелки

### Код / деталь / исходный размер / положение нижнего левого угла X,Y

W01 Дно корпуса 1000×468 (486; 10)

W03 Левая боковина 468×964 (10; 10)

W11 Дверца 496×992 (962; 10)

# Раскладка S18-3: фанера 18 мм

### Лист 1525 × 1525 · 2 деталей · заполнение заготовками 35.3%

Cambusa · v10 · 03.11.2026 · мм · предварительные контуры; присадка не выпущена | Лист 7

W04

468×964

W06

384×964

1525

1525

Рисунок шпона вдоль стрелки

### Код / деталь / исходный размер / положение нижнего левого угла X,Y

W04 Правая перфопанель 468×964 (402; 10)

W06 Перегородка 384×964 (10; 10)

# Раскладка S12-1: фанера 12 мм

### Лист 1525 × 1525 · 11 деталей · заполнение заготовками 63.3%

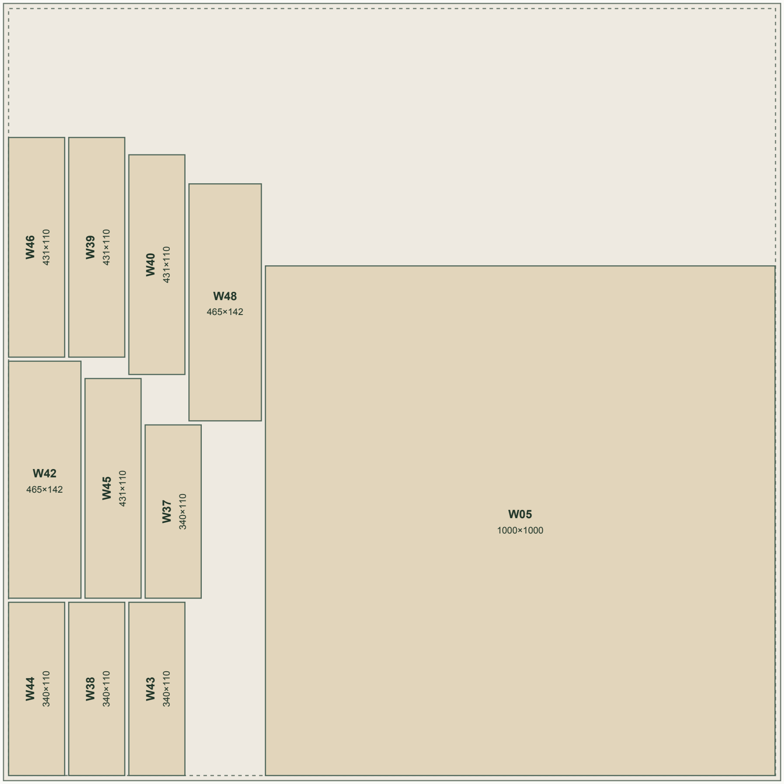
[picture p33: figure]

Cambusa · v10 · 03.11.2026 · мм · предварительные контуры; присадка не выпущена | Лист 8

1525

1525

Рисунок шпона вдоль стрелки

### Код / деталь / исходный размер / положение нижнего левого угла X,Y

W05 Задняя стенка 1000×1000 (514; 10)

W37 Ящик: боковина 340×110 (278; 358)

W38 Ящик: боковина 340×110 (128; 10)

W39 Ящик: передняя стенка 431×110 (128; 831)

W40 Ящик: задняя стенка 431×110 (246; 797)

W42 Ящик: фасад 465×142 (10; 358)

W43 Ящик: боковина 340×110 (246; 10)

W44 Ящик: боковина 340×110 (10; 10)

W45 Ящик: передняя стенка 431×110 (160; 358)

W46 Ящик: задняя стенка 431×110 (10; 831)

W48 Ящик: фасад 465×142 (364; 706)

# Раскладка S9-1: фанера 9 мм

### Лист 1525 × 1525 · 26 деталей · заполнение заготовками 24.2%

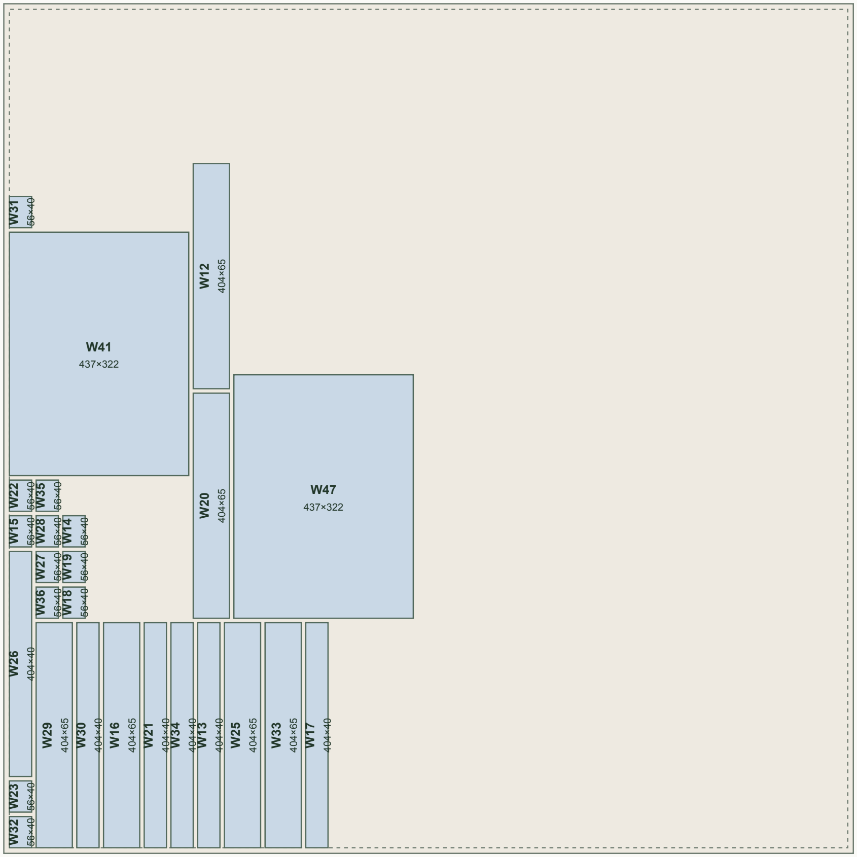
[picture p34: figure]

Cambusa · v10 · 03.11.2026 · мм · предварительные контуры; присадка не выпущена | Лист 9 W¹² 404×65 W¹³ 404×40 W¹⁵ 56×40 | W¹⁴ 56×40 | W¹⁶ 404×65 | W¹⁷ 404×40 W¹⁸ 56×40 W¹⁹ 56×40 | W²⁰ 404×65 W²¹ 404×40 W²² 56×40 W²³ 56×40 | W²⁵ 404×65 W²⁶ 404×40 W²⁷ 56×40 W²⁸ 56×40 W²⁹ 404×65 | W³⁰ 404×40 W³¹ 56×40 W³² 56×40 | W³³ W³⁴ 404×40 | 404×65 W³⁵ 56×40 W³⁶ 56×40

1525

1525

Рисунок шпона вдоль стрелки

### Код / деталь / исходный размер / положение нижнего левого угла X,Y

W12 Лоток: дно 404×65 (340; 834)

W13 Лоток: передний борт 404×40 (348; 10)

W14 Лоток: боковина 56×40 (106; 550)

W15 Лоток: боковина 56×40 (10; 550)

W16 Лоток: дно 404×65 (179; 10)

W17 Лоток: передний борт 404×40 (542; 10)

W18 Лоток: боковина 56×40 (106; 422)

W19 Лоток: боковина 56×40 (106; 486)

W20 Лоток: дно 404×65 (340; 422)

W21 Лоток: передний борт 404×40 (252; 10)

W22 Лоток: боковина 56×40 (10; 614)

W23 Лоток: боковина 56×40 (10; 74)

W25 Лоток: дно 404×65 (396; 10)

W26 Лоток: передний борт 404×40 (10; 138)

W27 Лоток: боковина 56×40 (58; 486)

W28 Лоток: боковина 56×40 (58; 550)

W29 Лоток: дно 404×65 (58; 10)

W30 Лоток: передний борт 404×40 (131; 10)

W31 Лоток: боковина 56×40 (10; 1123)

W32 Лоток: боковина 56×40 (10; 10)

W33 Лоток: дно 404×65 (469; 10)

W34 Лоток: передний борт 404×40 (300; 10)

W35 Лоток: боковина 56×40 (58; 614)

W36 Лоток: боковина 56×40 (58; 422)

W41 Ящик: дно 437×322 (10; 678)

W47 Ящик: дно 437×322 (413; 422)

# Основание: схема отрезков

### Чёрный алюминий 30 × 30, серия 30, паз 8 · схема для расчёта, узлы не выпущены

Cambusa · v10 · 03.11.2026 · мм · предварительные контуры; присадка не выпущена | Лист 10

920

800 с опорами

Вид сзади: нижняя связь сзади; спереди проход открыт.

### Отрезки:

4 стойки: L = 770 - h опоры.

3 поперечины по 860 мм.

2 верхние продольные детали по 410 мм.

2 нижние продольные детали по 350 мм.

h - высота от пола до торца профиля.

При условном h = 20 стойки 750 мм.

### Эту длину нельзя отправлять в резку

до сверки опоры и контргайки.

В плане верхняя рама 920 × 410 мм.

Покупка для сметы: 3 хлыста × 3020 мм.

Запас хлыстов не требует сборки на заводе.

18 уголков; 18 комплектов крепежа.

18 крышек; 4 заглушки; 4 опоры.

8 винтов M6×25 + 8 Т-гаек к корпусу.

Резьбу М8 в стойках делает поставщик.

Сборка и регулировка дома ключами.

Жёсткость и устойчивость ещё не испытаны.
