padington/cambusa-cabinet/history/outputs/layout-cost-v10/Смета-и-детали-v10.xlsx

Sheet: Смета
 | Смета Cambusa
 | 100 × 180 × 50 см. Цены на 03.11.2026, ₽.
 | Плановая стоимость |  |  |  | 108736.42
 | Резерв на уточнения |  |  |  | 20%
 | Стоимость с резервом |  |  |  | 130483.7
 | По опубликованным ставкам |  |  |  | 58174
 | По оценочным ставкам |  |  |  | 50562.42
 | Плановые количества. Оценочные цены выделены жёлтым; это не предложение поставщика.
 | Включена обработка и отделка отдельных деталей. Все детали собирает владелец.
Раздел | Деталь / работа | Количество | Ед. | Цена за ед., ₽ | Сумма, ₽ | Основание | Примечание | Источник
Фанера | ФК берёза 1/2 Ш2, 18 мм, 1525×1525 | 3.00 | лист | 3000.00 | 9000 | Прайс | Лицевая сторона сорта 1; листы отбирать под видимые поверхности. | https://neva-torg.ru/tseny/
Фанера | ФК берёза 1/2 Ш2, 12 мм, 1525×1525 | 1.00 | лист | 2350.00 | 2350 | Прайс | Лицевая сторона сорта 1; листы отбирать под видимые поверхности. | https://neva-torg.ru/tseny/
Фанера | ФК берёза 1/2 Ш2, 9 мм, 1525×1525 | 1.00 | лист | 1800.00 | 1800 | Прайс | Лицевая сторона сорта 1; листы отбирать под видимые поверхности. | https://neva-torg.ru/tseny/
Основание | Чёрный профиль 30×30: три хлыста по 3020 мм | 9.06 | м | 1130.00 | 10237.8 | Прайс | Учтена оплата целых хлыстов, скидка за объём не применена. | https://www.rsi-llc.ru/catalog/69/3522/
Основание | Уголок 30×30 | 18.00 | шт | 65.00 | 1170 | Прайс | Количество проектное, узлы ещё не проверены. | https://www.rsi-llc.ru/catalog/73/424/
Основание | Чёрная покраска уголка | 18.00 | шт | 50.00 | 900 | Прайс | Опция; при закрытии крышками можно исключить. | https://www.rsi-llc.ru/catalog/73/424/
Основание | Комплект: 2 Т-гайки 5006 + 2 винта М6×12 | 18.00 | компл | 41.40 | 745.2 | Прайс | Всего 36 гаек и 36 винтов, уже включены. | https://www.rsi-llc.ru/catalog/73/424/
Основание | Дополнительные Т-гайки M6 для корпуса | 10.00 | шт | 13.90 | 139 | Прайс | 8 рабочих + 2 запасных. | https://www.rsi-llc.ru/catalog/85/193/
Основание | Запасные винты М6×12 | 2.00 | шт | 6.80 | 13.6 | Прайс | Дополнение к 18 комплектам, не повтор всей партии. | https://www.rsi-llc.ru/catalog/137/561/
Основание | Чёрные крышки уголков | 18.00 | шт | 35.60 | 640.8 | Прайс |  | https://www.rsi-llc.ru/catalog/158/449/
Основание | Чёрная лента в пазы, верхний запас | 30.00 | м | 80.00 | 2400 | Прайс | Расход уточнить после уголков; нарезка поставщиком. | https://www.rsi-llc.ru/catalog/76/
Основание | Торцевые заглушки 30×30 | 4.00 | шт | 25.00 | 100 | Прайс |  | https://www.rsi-llc.ru/catalog/157/214/
Основание | Регулируемые опоры М8×50, кандидат | 4.00 | шт | 75.00 | 300 | Прайс | На сайте противоречие Ø30/50; установочную высоту и чертёж сверить. | https://www.rsi-llc.ru/catalog/117/2178/
Основание | Контргайка опоры M8 | 4.00 | шт | 1.06 | 4.24 | Прайс | Фасовка при заказе требует подтверждения. | https://tdmtdm.ru/catalog/gayki/din_439_iso_4035_gayka_nizkaya/din439_m8_gayka_nizkaya_tsink/
Основание | Потайные винты корпуса M6×25 | 10.00 | шт | 6.14 | 61.4 | Прайс | 8 рабочих + 2 запасных, длина уточняется под толщину. | https://oniks-krep.ru/catalog/din_7991_a2/din_7991_vint_s_potajnoj_golovkoj_vnutr_shestigr_nerzh_a2_m6x25/
Основание | Резка 11 отрезков и снятие заусенцев | 1.00 | заказ | 1000.00 | 1000 | Оценка | Услуга найдена, тарифа резки на сайте нет. | https://www.rsi-llc.ru/catalog/179/
Основание | Резьба М8 в нижних торцах стоек | 4.00 | шт | 50.00 | 200 | Прайс | Проверить пригодность центрального канала и глубину под опоры. | https://www.rsi-llc.ru/catalog/179/
Фурнитура | Накладная петля с нулевым вхождением, 155° | 8.00 | шт | 1130.35 | 9042.8 | Прайс | План: 4 на дверцу высотой 992 мм с лотками. Это запас для расчёта, не подтверждённая грузоподъёмность. Цена и наличие найдены в индексируемом каталоге СПб; сама карточка при открытии недоступна. Количество проверить по массе дверей и лотков. | https://spb-mk.ru/catalog/furnitura_blum/petli_blum/petli_blum_clip_top_blumotion_s_dovodchikom/
Фурнитура | Монтажная планка CLIP, высота 0 мм | 8.00 | шт | 108.10 | 864.8 | Прайс | Поставка СПб. Крестовая планка на саморезы. Наложение 16 мм, сверление чашки и допустимость лотков нужно сверить в конфигураторе/чертежах Blum. | https://fkmspb.ru/brend/blum/page/82/
Фурнитура | Врезные чёрные ручки — вариант вместо условных прорезей | 2.00 | шт | 471.71 | 943.42 | Прайс | Эта ручка не равна прорези модели v08: размеры кармана и крепёж брать из её чертежа. Альтернатива — изготовить удобный фрезерованный хват и заднюю накладку; не покупать оба варианта. | https://www.mdm-complect.ru/catalog/ruchki/filter/tip-krepleniya-is-vreznoy-montazh-or-vreznoy-montazh-vintami-or-vreznoy-montazh-samorezami/tsvetovaya-gamma-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
Фурнитура | Полное выдвижение, доводчик, номинал 350 мм | 2.00 | комплект на ящик | 4546.82 | 9093.64 | Прайс | Один комплект — левая/правая направляющие + два замка; всего 4 направляющие и 4 замка. Не покупать замки отдельно второй раз. У продавца указано наличие; доставка из Москвы в СПб отдельно. В СПб точная позиция с замками также перечислена ТДМ: https://tdmspb.ru/catalog/products/50109/; карточка не открылась, цена/остаток не подтверждены. | https://furnion.ru/komplekt-napravlyayushchikh-tandem-poln-vydvizheniya-s-dovodchikom-s-zamkami-560h3500bt511703/
Фурнитура | Эксцентрик для фанеры 18 мм | 40.00 | шт | 20.00 | 800 | Оценка | 16 креплений топ/дно к боковинам и перегородке + 16 на четыре полки. Число проектное; шканты и коллизии с перфорацией проверяются при присадке. | https://www.grouppartner.ru/catalog/krepezhnaya-furnitura/ekstsentrikovye-styazhki/hettich_9/styazhka-ekstsentrikovaya-rastex-15-polka-18-mm-bez-burtika-tsink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
Фурнитура | Шток эксцентрика, зажим 20 мм | 60.00 | шт | 15.00 | 900 | Оценка | 32 в корпус + 16 в ящики. Производитель: отверстие 5 мм; длина зажима 20 мм. Это не полная длина штока. Розничный продавец этой позиции в СПб не подтверждён. | https://shop.hettich.com/us_EN/Further-products/Connecting-technology/Connecting-fittings-for-cabinet-bodies/Rastex-eccentric-connecting-fitting/Rastex-15-dow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
Фурнитура | Деревянные шканты без клея | 50.00 | шт | 3.00 | 150 | Оценка | Проектно 28 в корпус и 8 в ящики. Требуется проба ручной посадки; фанера и отверстия должны быть подготовлены поставщиком. | Расчётное допущение; коммерческого предложения нет
Фурнитура | Заглушки эксцентриков под тёмное дерево | 40.00 | шт | 4.00 | 160 | Оценка | Только внутри. Крышки для 18 мм не переносить автоматически на низкий Rastex15/12. | https://hettich-shop.ru/soedinitelnaya-furnitura/532/ekstsentrikovye-styazhki-rastex-15/ekstsentriki.html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
Фурнитура | Эксцентрик для стенок 12 мм | 20.00 | шт | 20.00 | 400 | Оценка | Два крепления на угол, четыре угла на ящик. Штоки уже учтены в B02. Не заменять версией для 18 мм. На сайте можно выбрать СПб; остаток не подтверждён. | https://www.tdserver.ru/catalog/krepezhnaya_furnitura/krepezh_raznyy/ekstsentrikovaya_styazhka_rastex_15_dlya_plit_12_mm_bez_pokrytiya_art_9116019_hettich/
Фурнитура | Малый металлический уголок | 40.00 | шт | 30.00 | 1200 | Оценка | План: по 6 на лоток — 2 к дверце, 2 к переднему борту, по 1 к бокам. 5 упаковок по 8 шт. Покрытие, размеры отверстий и возможность скрыть уголки требуют проверки. Это новая схема, её нет в CAD v08. | https://www.ozon.ru/product/ugolok-krepezhnyy-kronshteyn-pmk-tsink-20h20h15-mm-8-sht-v-upak-mebelnyy-krepezhnyy-ugolok-usilennyy-5157956769/
Фурнитура | Остальные шурупы, буферы, ключи и отвёртка | 1.00 | набор | 1500.00 | 1500 | Оценка | Строки B04, C03, C05, D02, D03, D05, E02, E03, F02 из v09; без дубля основного крепежа. | Расчётное допущение; коммерческого предложения нет
Обработка | Наружные контуры 18 мм | 27.10 | м | 95.00 | 2574.88 | Прайс | Сумма периметров, без общих резов и петельных отверстий. | https://raspil78.ru/czeny/
Обработка | Наружные контуры 12 мм | 14.36 | м | 80.00 | 1148.48 | Оценка | Точный тариф ЧПУ 12 мм не опубликован; это принятая ставка. | https://raspil78.ru/czeny/
Обработка | Наружные контуры 9 мм | 16.30 | м | 65.00 | 1059.24 | Оценка | Тариф именно для 9 мм не опубликован; это принятая ставка. | https://raspil78.ru/czeny/
Обработка | Перфорация: 171 круг Ø12 | 6.45 | м | 95.00 | 612.42 | Прайс | Фрезеровка контуров; технологические заходы включены в подготовку ниже. | https://raspil78.ru/czeny/
Обработка | Присадка эксцентриков | 48.00 | компл | 68.00 | 3264 | Прайс | Проектное число, состав операции уточнить по чертежу. | https://raspil78.ru/czeny/
Обработка | Присадка шкантов | 36.00 | компл | 31.00 | 1116 | Прайс | Проверить, что обе сопряжённые детали включены. | https://raspil78.ru/czeny/
Обработка | Чашки восьми петель | 8.00 | шт | 75.00 | 600 | Прайс | Прайс присадочных работ; на той же странице фасадная услуга стоит 100, требуется подтверждение. | https://raspil78.ru/czeny/
Обработка | Остальные пилоты, зенковки и гнёзда | 1.00 | заказ | 4000.00 | 4000 | Оценка | Направляющие, замки, задник, корпус к основанию, лотки, крепёж петель. | https://raspil78.ru/czeny/
Обработка | Пазы днищ, вырезы TANDEM и ручки | 1.00 | заказ | 3000.00 | 3000 | Оценка | Вырезы ручек уточнить под выбранную модель. | https://raspil78.ru/czeny/
Обработка | Подготовка ЧПУ, крепление мелких деталей, пробные посадки | 1.00 | заказ | 5000.00 | 5000 | Оценка | Включает технологические заходы, вкладки и подготовку двусторонней обработки; не сборка шкафа. | https://raspil78.ru/czeny/
Отделка | Шлифовка, тёмная тонировка и защитное покрытие | 12.79 | м² | 1700.00 | 21744.7 | Оценка | Обе пласти, торцы и стенки перфорации; точного тарифа этого заказа нет, масло/воск у цеха по запросу. | https://ooo-mgrad.ru/uslugi/pokraska_mdf/
Прочее | Упаковка и доставки между поставщиками и домой | 1.00 | заказ | 5000.00 | 5000 | Оценка | Плановый лимит, не тариф перевозчика. | Расчётное допущение; коммерческого предложения нет
Прочее | Контрольный узел/лоток/ящик и решение устойчивости | 1.00 | резерв | 3500.00 | 3500 | Оценка | До полного изготовления; проект высокой тумбы физически не испытан. | Расчётное допущение; коммерческого предложения нет

Sheet: Детали
 |  | 48 деревянных деталей
 |  | Размеры - мм; X,Y от нижнего левого угла листа.
Код | Код модели | Деталь | Толщина | Ширина | Высота | Кол-во | Волокна | Лист | X | Y | Поворот 90° | Площадь, м²
W01 | B00-bottom | Дно корпуса | 18 | 1000 | 468 | 1 | X | S18-2 | 486 | 10 | да | 0.468
W02 | B01-top | Верх корпуса | 18 | 1000 | 468 | 1 | X | S18-1 | 402 | 491 | да | 0.468
W03 | B02-left-side | Левая боковина | 18 | 468 | 964 | 1 | Y | S18-2 | 10 | 10 | нет | 0.451
W04 | B03-right-pegboard | Правая перфопанель | 18 | 468 | 964 | 1 | Y | S18-3 | 402 | 10 | нет | 0.451
W05 | B04-back | Задняя стенка | 12 | 1000 | 1000 | 1 | Y | S12-1 | 514 | 10 | нет | 1.000
W06 | B05-divider | Перегородка | 18 | 384 | 964 | 1 | Y | S18-3 | 10 | 10 | нет | 0.370
W07 | B10-left-shelf | Полка | 18 | 473 | 384 | 1 | X | S18-1 | 402 | 10 | да | 0.182
W08 | B11-left-shelf | Полка | 18 | 473 | 384 | 1 | X | S18-1 | 10 | 972 | да | 0.182
W09 | B20-right-shelf | Полка | 18 | 473 | 384 | 1 | X | S18-1 | 10 | 10 | да | 0.182
W10 | B21-right-shelf | Полка | 18 | 473 | 384 | 1 | X | S18-1 | 10 | 491 | да | 0.182
W11 | B30-door | Дверца | 18 | 496 | 992 | 1 | Y | S18-2 | 962 | 10 | нет | 0.492
W12 | T00-bottom | Лоток: дно | 9 | 404 | 65 | 1 | X | S9-1 | 340 | 834 | да | 0.026
W13 | T00-lip | Лоток: передний борт | 9 | 404 | 40 | 1 | X | S9-1 | 348 | 10 | да | 0.016
W14 | T00-left | Лоток: боковина | 9 | 56 | 40 | 1 | X | S9-1 | 106 | 550 | да | 0.002
W15 | T00-right | Лоток: боковина | 9 | 56 | 40 | 1 | X | S9-1 | 10 | 550 | да | 0.002
W16 | T01-bottom | Лоток: дно | 9 | 404 | 65 | 1 | X | S9-1 | 179 | 10 | да | 0.026
W17 | T01-lip | Лоток: передний борт | 9 | 404 | 40 | 1 | X | S9-1 | 542 | 10 | да | 0.016
W18 | T01-left | Лоток: боковина | 9 | 56 | 40 | 1 | X | S9-1 | 106 | 422 | да | 0.002
W19 | T01-right | Лоток: боковина | 9 | 56 | 40 | 1 | X | S9-1 | 106 | 486 | да | 0.002
W20 | T02-bottom | Лоток: дно | 9 | 404 | 65 | 1 | X | S9-1 | 340 | 422 | да | 0.026
W21 | T02-lip | Лоток: передний борт | 9 | 404 | 40 | 1 | X | S9-1 | 252 | 10 | да | 0.016
W22 | T02-left | Лоток: боковина | 9 | 56 | 40 | 1 | X | S9-1 | 10 | 614 | да | 0.002
W23 | T02-right | Лоток: боковина | 9 | 56 | 40 | 1 | X | S9-1 | 10 | 74 | да | 0.002
W24 | B31-door | Дверца | 18 | 496 | 992 | 1 | Y | S18-1 | 878 | 10 | нет | 0.492
W25 | T10-bottom | Лоток: дно | 9 | 404 | 65 | 1 | X | S9-1 | 396 | 10 | да | 0.026
W26 | T10-lip | Лоток: передний борт | 9 | 404 | 40 | 1 | X | S9-1 | 10 | 138 | да | 0.016
W27 | T10-left | Лоток: боковина | 9 | 56 | 40 | 1 | X | S9-1 | 58 | 486 | да | 0.002
W28 | T10-right | Лоток: боковина | 9 | 56 | 40 | 1 | X | S9-1 | 58 | 550 | да | 0.002
W29 | T11-bottom | Лоток: дно | 9 | 404 | 65 | 1 | X | S9-1 | 58 | 10 | да | 0.026
W30 | T11-lip | Лоток: передний борт | 9 | 404 | 40 | 1 | X | S9-1 | 131 | 10 | да | 0.016
W31 | T11-left | Лоток: боковина | 9 | 56 | 40 | 1 | X | S9-1 | 10 | 1123 | да | 0.002
W32 | T11-right | Лоток: боковина | 9 | 56 | 40 | 1 | X | S9-1 | 10 | 10 | да | 0.002
W33 | T12-bottom | Лоток: дно | 9 | 404 | 65 | 1 | X | S9-1 | 469 | 10 | да | 0.026
W34 | T12-lip | Лоток: передний борт | 9 | 404 | 40 | 1 | X | S9-1 | 300 | 10 | да | 0.016
W35 | T12-left | Лоток: боковина | 9 | 56 | 40 | 1 | X | S9-1 | 58 | 614 | да | 0.002
W36 | T12-right | Лоток: боковина | 9 | 56 | 40 | 1 | X | S9-1 | 58 | 422 | да | 0.002
W37 | D0-left | Ящик: боковина | 12 | 340 | 110 | 1 | X | S12-1 | 278 | 358 | да | 0.037
W38 | D0-right | Ящик: боковина | 12 | 340 | 110 | 1 | X | S12-1 | 128 | 10 | да | 0.037
W39 | D0-front | Ящик: передняя стенка | 12 | 431 | 110 | 1 | X | S12-1 | 128 | 831 | да | 0.047
W40 | D0-rear | Ящик: задняя стенка | 12 | 431 | 110 | 1 | X | S12-1 | 246 | 797 | да | 0.047
W41 | D0-bottom | Ящик: дно | 9 | 437 | 322 | 1 | X | S9-1 | 10 | 678 | да | 0.141
W42 | D0-face | Ящик: фасад | 12 | 465 | 142 | 1 | X | S12-1 | 10 | 358 | да | 0.066
W43 | D1-left | Ящик: боковина | 12 | 340 | 110 | 1 | X | S12-1 | 246 | 10 | да | 0.037
W44 | D1-right | Ящик: боковина | 12 | 340 | 110 | 1 | X | S12-1 | 10 | 10 | да | 0.037
W45 | D1-front | Ящик: передняя стенка | 12 | 431 | 110 | 1 | X | S12-1 | 160 | 358 | да | 0.047
W46 | D1-rear | Ящик: задняя стенка | 12 | 431 | 110 | 1 | X | S12-1 | 10 | 831 | да | 0.047
W47 | D1-bottom | Ящик: дно | 9 | 437 | 322 | 1 | X | S9-1 | 413 | 422 | да | 0.141
W48 | D1-face | Ящик: фасад | 12 | 465 | 142 | 1 | X | S12-1 | 364 | 706 | да | 0.066

Sheet: Листы
Пять листов фанеры
ФК берёза, сорт 1/2 Ш2. Рисунок наружного шпона вдоль Y листа.
Край 10 мм; зазор 8 мм; фреза до 6 мм. Все 48 деталей учтены.
Лист | Толщина, мм | Ширина, мм | Высота, мм | Деталей | Детали, м² | Лист, м² | Заполнение
S18-1 | 18 | 1525 | 1525 | 6 | 1.687 | 2.326 | 72.5%
S18-2 | 18 | 1525 | 1525 | 3 | 1.411 | 2.326 | 60.7%
S18-3 | 18 | 1525 | 1525 | 2 | 0.821 | 2.326 | 35.3%
S12-1 | 12 | 1525 | 1525 | 11 | 1.471 | 2.326 | 63.3%
S9-1 | 9 | 1525 | 1525 | 26 | 0.563 | 2.326 | 24.2%
Итого |  |  |  | 48 | 5.953 | 11.628
Это карта контуров. Присадка и допуски требуют отдельного выпуска.
