padington/cambusa-cabinet/history/outputs/order-preparation-v06/plywood-blanks.csv

id | thickness_mm | blank_w_mm | blank_h_mm | quantity | group
B00-base | 18 | 1000.0 | 500.0 | 1 | body
B01-shelf | 18 | 922.0 | 434.0 | 1 | body
B02-shelf | 18 | 922.0 | 434.0 | 1 | body
B03-shelf | 18 | 922.0 | 434.0 | 1 | body
B04-top | 18 | 1000.0 | 500.0 | 1 | body
B10-partition | 18 | 434.0 | 282.0 | 1 | body
B11-partition | 18 | 434.0 | 302.0 | 1 | body
B12-partition | 18 | 434.0 | 306.0 | 1 | body
B20-left-side | 18 | 434.0 | 312.0 | 1 | body
B30-right-side | 18 | 434.0 | 312.0 | 1 | body
B21-left-side | 18 | 434.0 | 332.0 | 1 | body
B31-right-side | 18 | 434.0 | 332.0 | 1 | body
B22-left-side | 18 | 434.0 | 336.0 | 1 | body
B32-right-side | 18 | 434.0 | 336.0 | 1 | body
B40-back | 6 | 982.0 | 1064.0 | 1 | back
B50-pegboard | 18 | 500.0 | 1064.0 | 1 | pegboard
B60-left-door | 18 | 439.0 | 620.0 | 1 | door
B61-right-door | 18 | 437.0 | 270.0 | 1 | door
B70-bottom | 9 | 360.0 | 70.0 | 1 | door
B70-lip | 9 | 360.0 | 34.0 | 1 | door
B70-left | 9 | 61.0 | 34.0 | 1 | door
B70-right | 9 | 61.0 | 34.0 | 1 | door
B71-bottom | 9 | 360.0 | 70.0 | 1 | door
B71-lip | 9 | 360.0 | 34.0 | 1 | door
B71-left | 9 | 61.0 | 34.0 | 1 | door
B71-right | 9 | 61.0 | 34.0 | 1 | door
D0-left | 12 | 390.0 | 100.0 | 1 | drawer
D0-right | 12 | 390.0 | 100.0 | 1 | drawer
D0-front | 12 | 385.0 | 100.0 | 1 | drawer
D0-rear | 12 | 385.0 | 100.0 | 1 | drawer
D0-bottom | 9 | 409.0 | 390.0 | 1 | drawer
D0-face | 12 | 411.0 | 130.0 | 1 | drawer
D1-left | 12 | 390.0 | 100.0 | 1 | drawer
D1-right | 12 | 390.0 | 100.0 | 1 | drawer
D1-front | 12 | 385.0 | 100.0 | 1 | drawer
D1-rear | 12 | 385.0 | 100.0 | 1 | drawer
D1-bottom | 9 | 409.0 | 390.0 | 1 | drawer
D1-face | 12 | 411.0 | 130.0 | 1 | drawer
