padington/cambusa-cabinet/history/outputs/layout-cost-v10/Детали-18мм.png

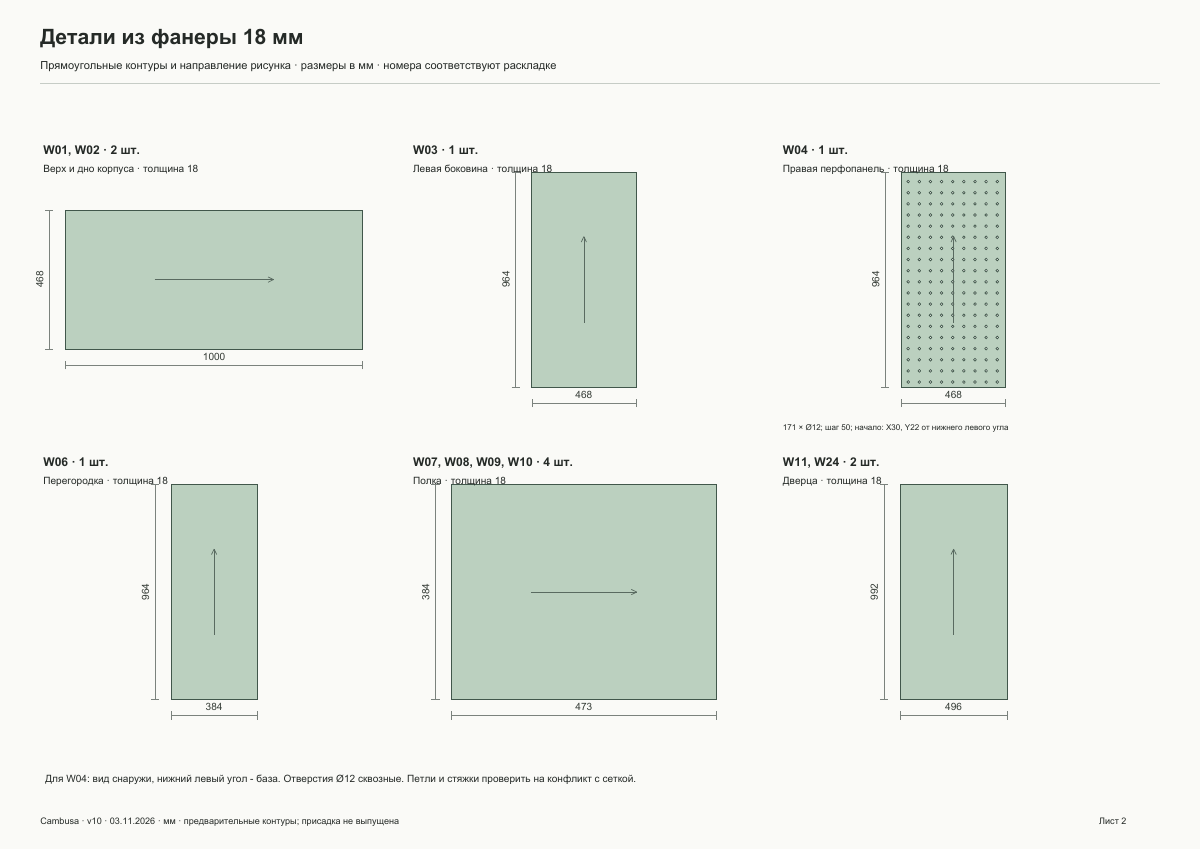
history/outputs/layout-cost-v10/Детали-18мм.png
