padington/cambusa-cabinet/history/outputs/order-preparation-v06/exploded.png

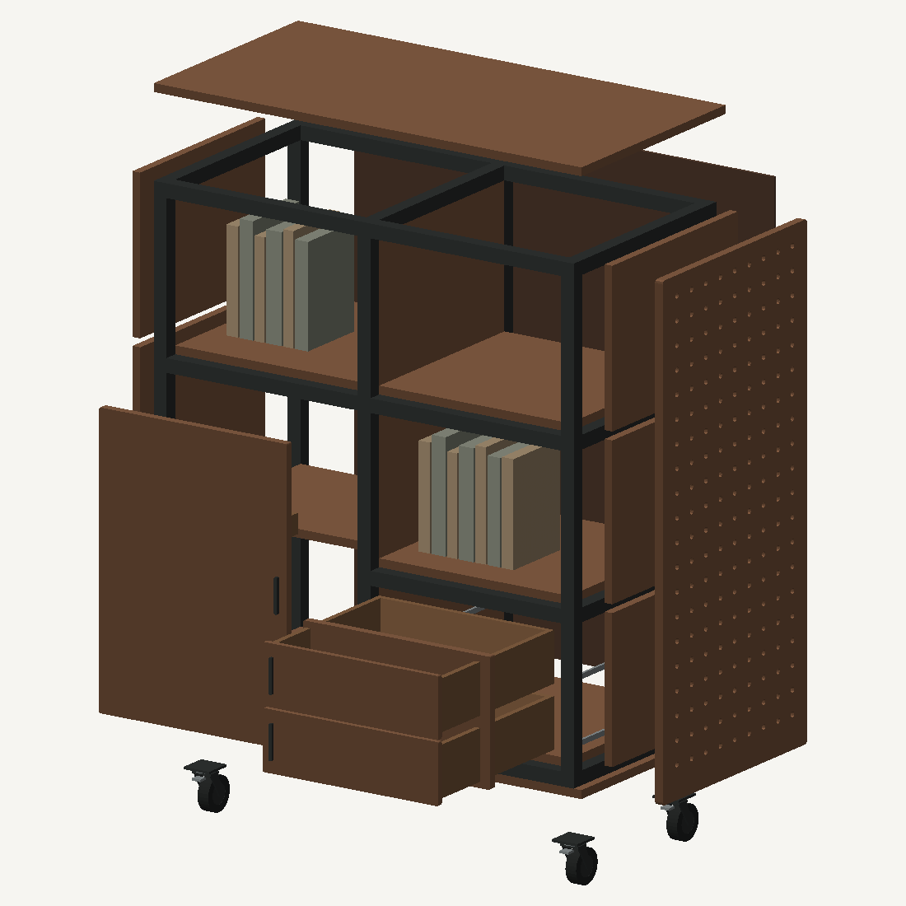
history/outputs/order-preparation-v06/exploded.png
