padington/cambusa-cabinet/history/outputs/order-preparation-v06/open.png

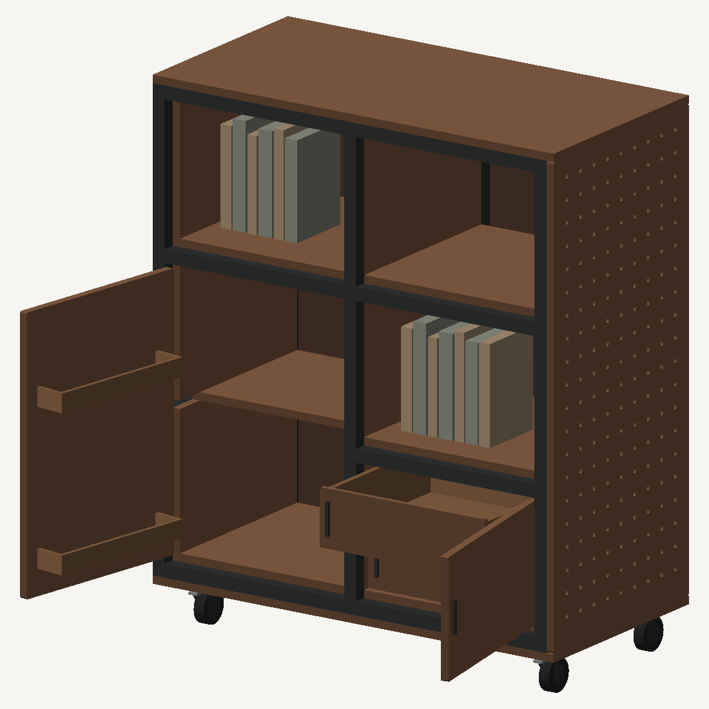
history/outputs/order-preparation-v06/open.png
