padington/cambusa-cabinet/history/outputs/cabinet-03-04-engineering-v1/joint-prototype/fit-coupon-slots-18p2-18p6-19p0.stl

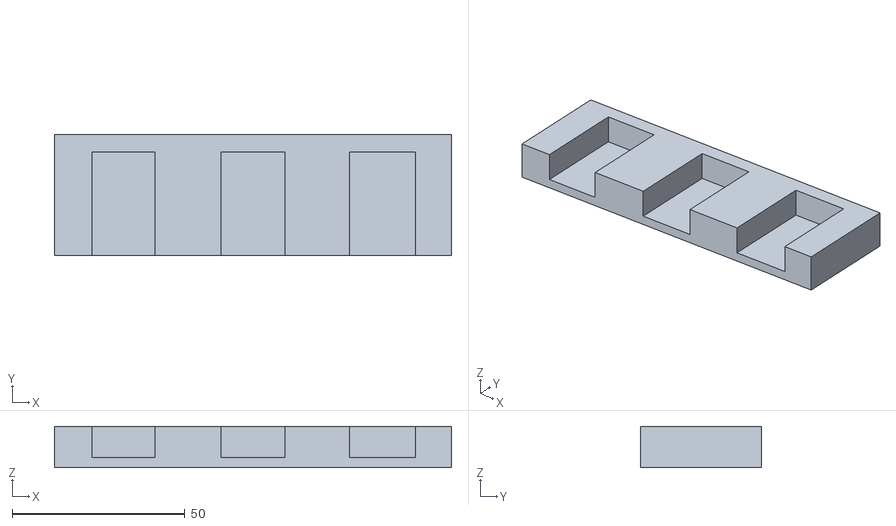
[picture p38: CAD file, 2026-11-04]
history/outputs/cabinet-03-04-engineering-v1/joint-prototype/fit-coupon-slots-18p2-18p6-19p0.stl
115.0 x 35.0 x 12.0
