padington/cambusa-cabinet/history/outputs/cabinet-03-04-engineering-v1/variant-04/door-0.stl

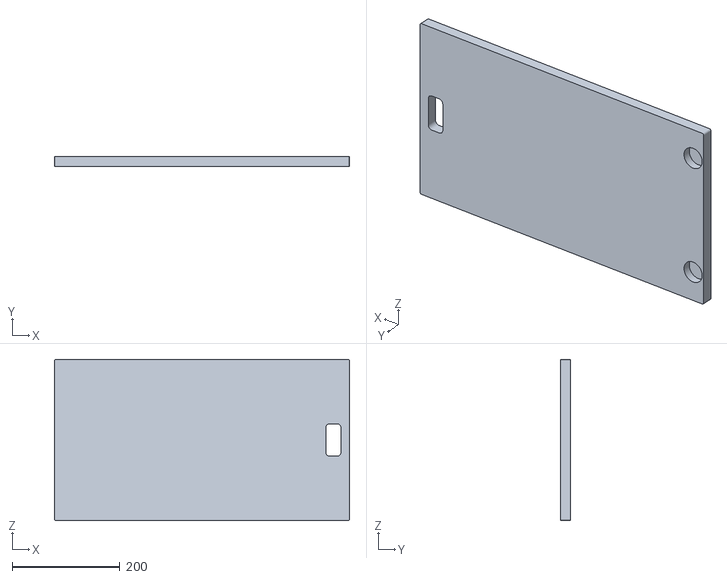
[picture p40: CAD file, 2026-11-04]
history/outputs/cabinet-03-04-engineering-v1/variant-04/door-0.stl
548.0 x 18.0 x 300.0
