padington/cambusa-cabinet/history/outputs/order-preparation-v06/quote-outlines/B32-right-side.dxf

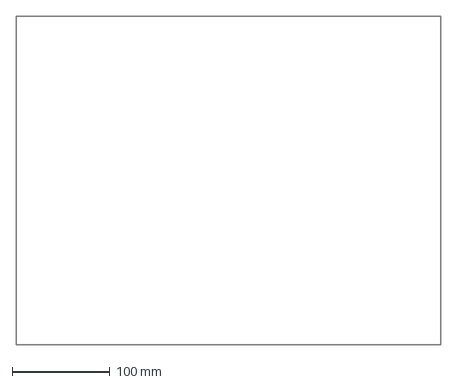
[picture p41: CAD file, 2026-11-04]
history/outputs/order-preparation-v06/quote-outlines/B32-right-side.dxf
434.0 x 336.0 mm
