padington/cambusa-cabinet/history/outputs/round-cabinet/round-t-15mm-gap03.stl

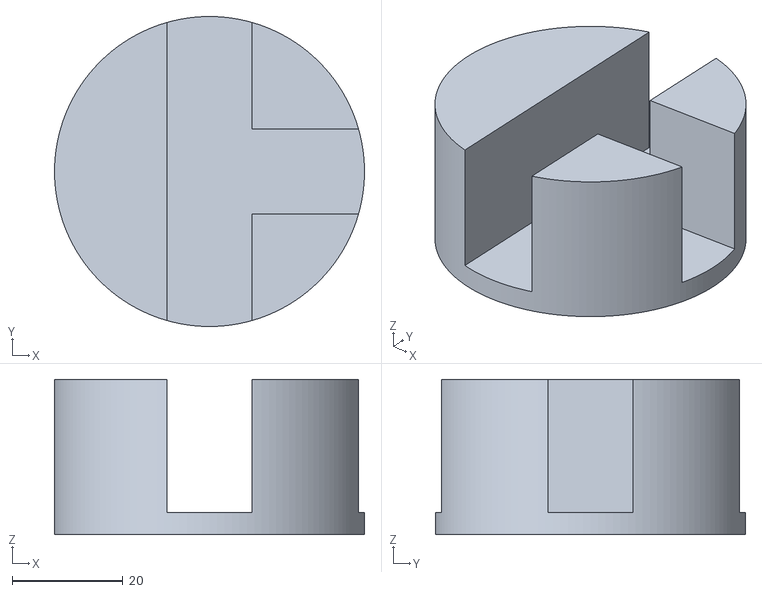
[picture p42: CAD file, 2026-11-04]
history/outputs/round-cabinet/round-t-15mm-gap03.stl
56.0 x 56.0 x 28.0
