padington/cambusa-cabinet/history/outputs/sphere-bayonet-v02/divider-prototype-mm.stl

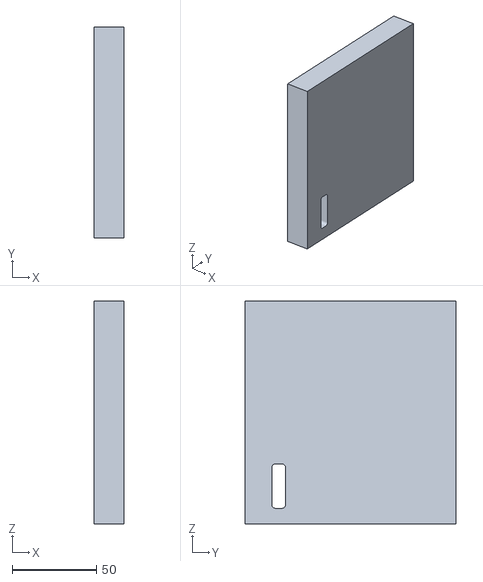
[picture p43: CAD file, 2026-11-04]
history/outputs/sphere-bayonet-v02/divider-prototype-mm.stl
18.0 x 125.0 x 132.0
