padington/cambusa-cabinet/history/outputs/cabinet-03-04-engineering-v1/joint-prototype/plywood-divider-coupon.stl

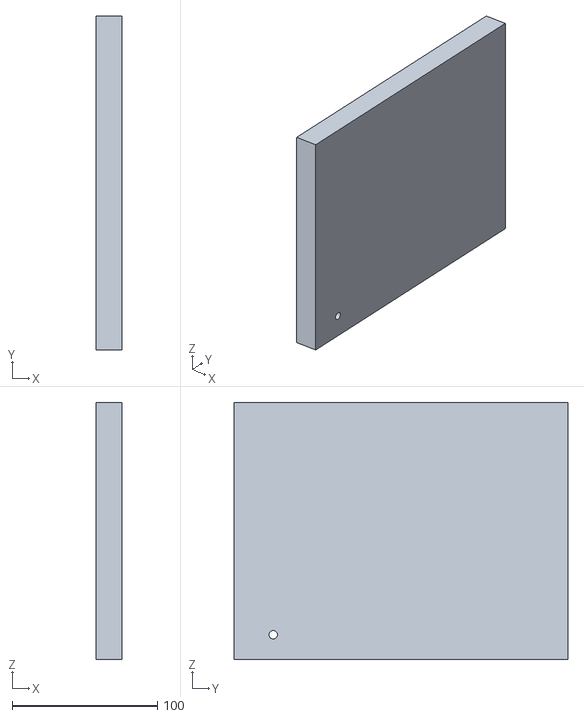
[picture p44: CAD file, 2026-11-04]
history/outputs/cabinet-03-04-engineering-v1/joint-prototype/plywood-divider-coupon.stl
18.0 x 230.0 x 177.0
