padington/cambusa-cabinet/history/outputs/cabinet-03-04-engineering-v1/variant-03/partition-1.stl

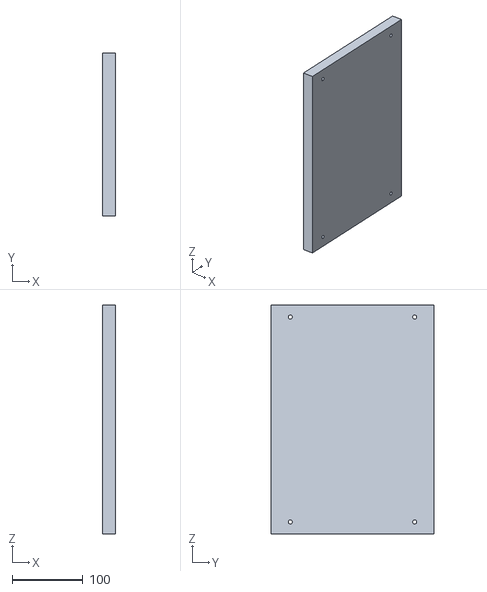
[picture p45: CAD file, 2026-11-04]
history/outputs/cabinet-03-04-engineering-v1/variant-03/partition-1.stl
18.0 x 230.0 x 324.0
