padington/cambusa-cabinet/history/outputs/cabinet-03-04-engineering-v1/variant-04/shelf-2.stl

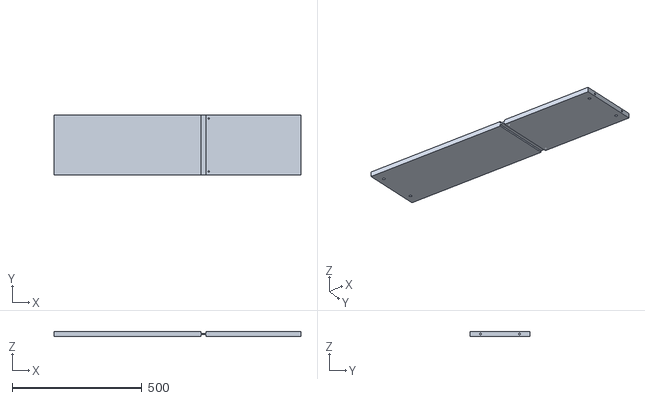
[picture p46: CAD file, 2026-11-04]
history/outputs/cabinet-03-04-engineering-v1/variant-04/shelf-2.stl
952.0 x 230.0 x 18.0
