padington/cambusa-cabinet/history/outputs/order-preparation-v06/quote-outlines/B00-base.dxf

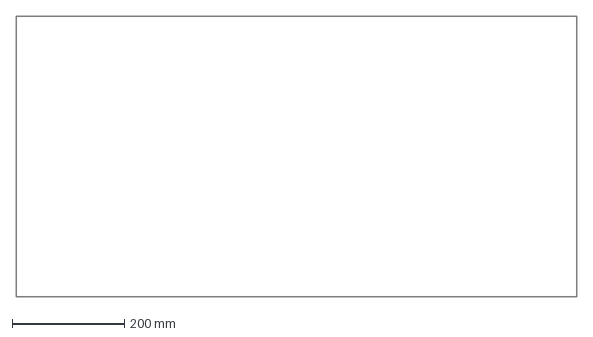
[picture p47: CAD file, 2026-11-04]
history/outputs/order-preparation-v06/quote-outlines/B00-base.dxf
1000.0 x 500.0 mm
