padington/cambusa-cabinet/history/outputs/sphere-bayonet-v02/key-prototype-mm.stl

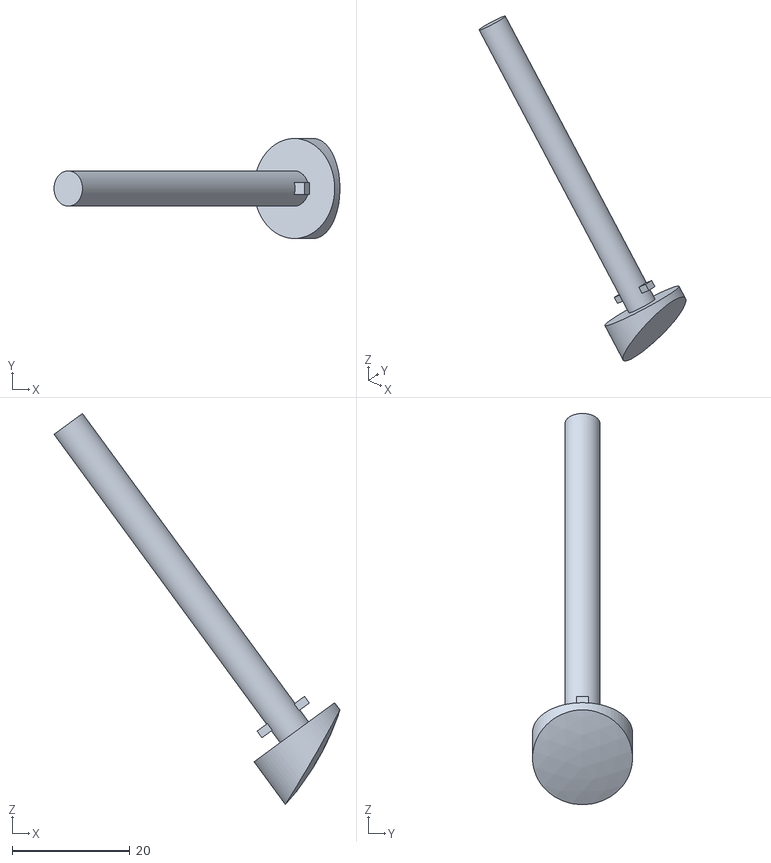
[picture p48: CAD file, 2026-11-04]
history/outputs/sphere-bayonet-v02/key-prototype-mm.stl
48.6 x 17.0 x 66.5
