padington/cambusa-cabinet/history/outputs/cabinet-03-04-engineering-v1/joint-prototype/plywood-shelf-coupon.stl

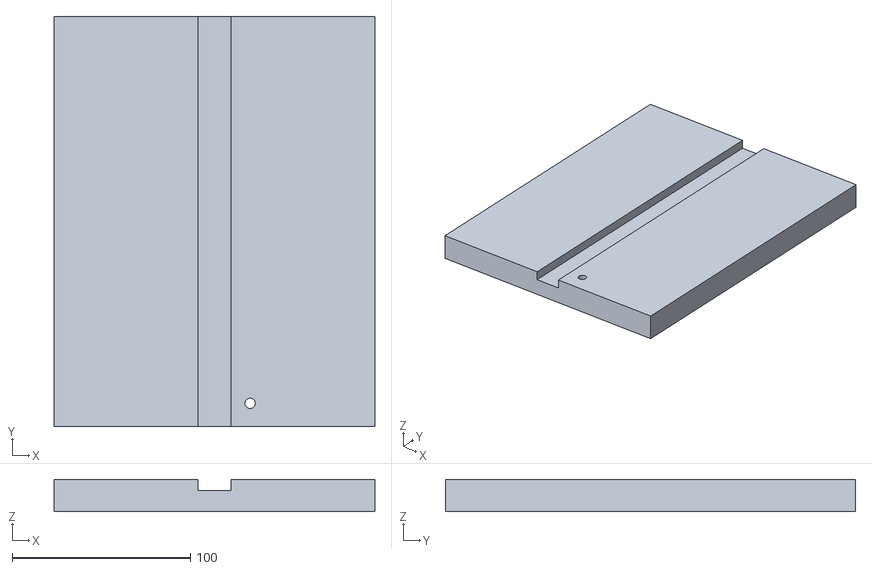
[picture p49: CAD file, 2026-11-04]
history/outputs/cabinet-03-04-engineering-v1/joint-prototype/plywood-shelf-coupon.stl
180.0 x 230.0 x 18.0
