padington/cambusa-cabinet/history/outputs/order-preparation-v06/quote-outlines/B61-right-door.dxf

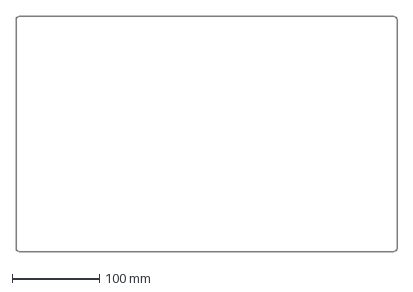
[picture p50: CAD file, 2026-11-04]
history/outputs/order-preparation-v06/quote-outlines/B61-right-door.dxf
437.0 x 270.0 mm
