padington/cambusa-cabinet/history/outputs/round-cabinet/fit-test-015-030-045.stl

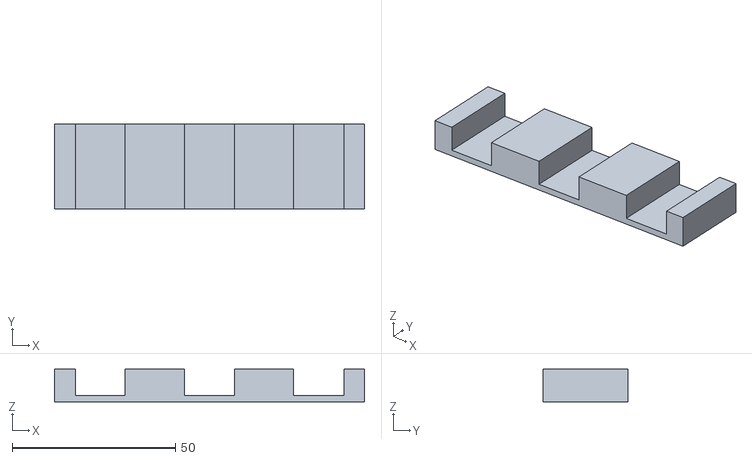
[picture p51: CAD file, 2026-11-04]
history/outputs/round-cabinet/fit-test-015-030-045.stl
95.0 x 26.0 x 10.0
