padington/cambusa-cabinet/history/outputs/sphere-bayonet-v02/shelf-prototype-mm.stl

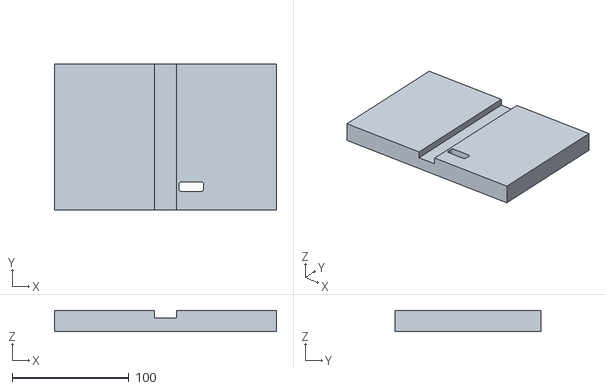
[picture p52: CAD file, 2026-11-04]
history/outputs/sphere-bayonet-v02/shelf-prototype-mm.stl
190.0 x 125.0 x 18.0
