padington/cambusa-cabinet/history/outputs/cabinet-03-04-engineering-v1/joint-prototype/finger-grip-for-M5x60.stl

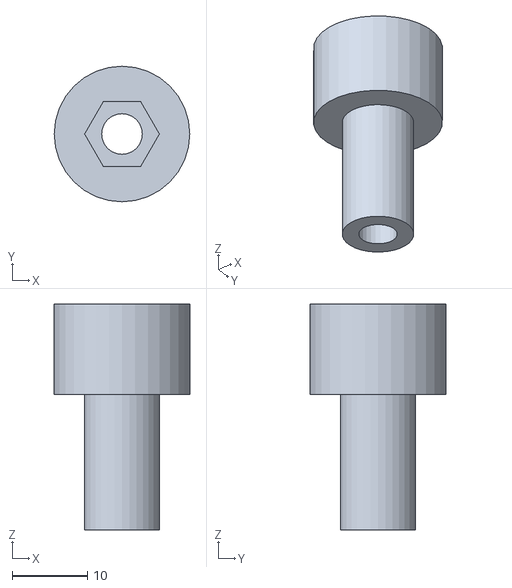
[picture p53: CAD file, 2026-11-04]
history/outputs/cabinet-03-04-engineering-v1/joint-prototype/finger-grip-for-M5x60.stl
18.0 x 18.0 x 30.0
