padington/cambusa-cabinet/history/outputs/cabinet-03-04-engineering-v1/variant-04/frame-left.stl

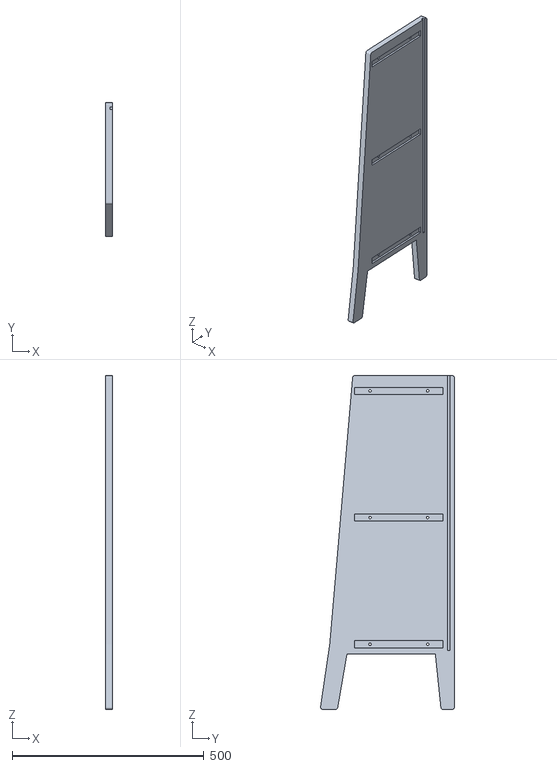
[picture p54: CAD file, 2026-11-04]
history/outputs/cabinet-03-04-engineering-v1/variant-04/frame-left.stl
18.0 x 349.0 x 870.0
