padington/cambusa-cabinet/history/outputs/order-preparation-v06/quote-outlines/D0-face.dxf

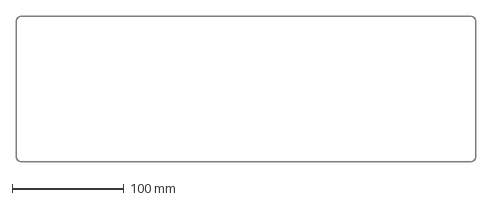
[picture p55: CAD file, 2026-11-04]
history/outputs/order-preparation-v06/quote-outlines/D0-face.dxf
411.0 x 130.0 mm
