padington/cambusa-cabinet/history/outputs/sphere-bayonet-v02/body-prototype-mm.stl

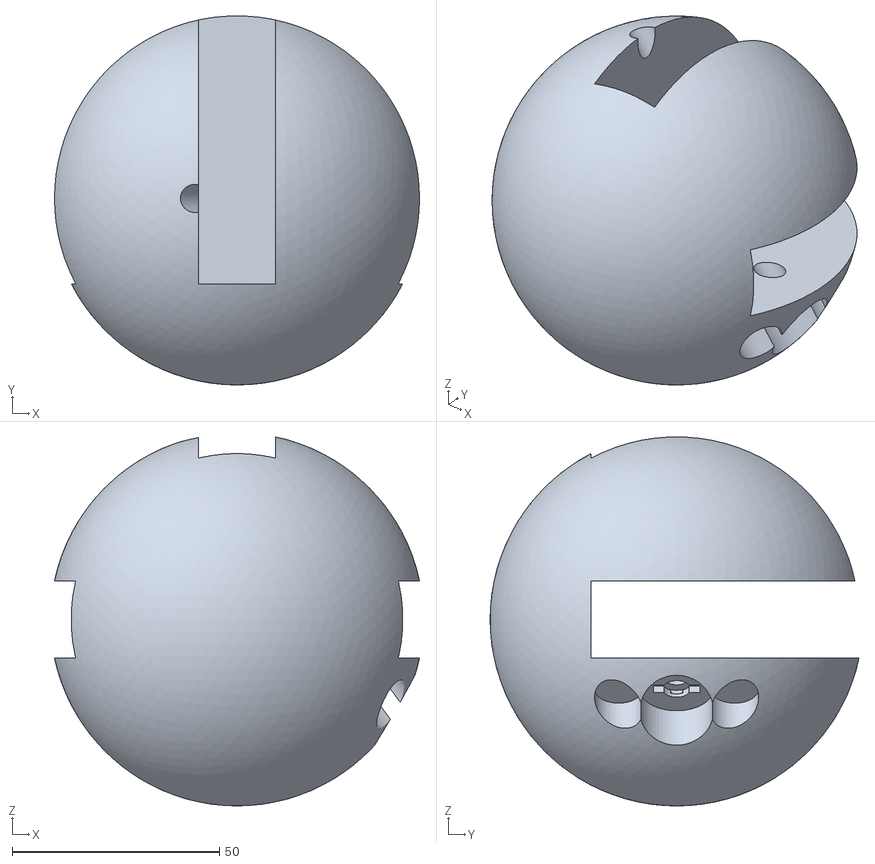
[picture p56: CAD file, 2026-11-04]
history/outputs/sphere-bayonet-v02/body-prototype-mm.stl
88.1 x 89.0 x 89.0
