padington/cambusa-cabinet/history/outputs/cabinet-03-04-engineering-v1/joint-prototype/sphere-T-up-18mm-gap06.stl

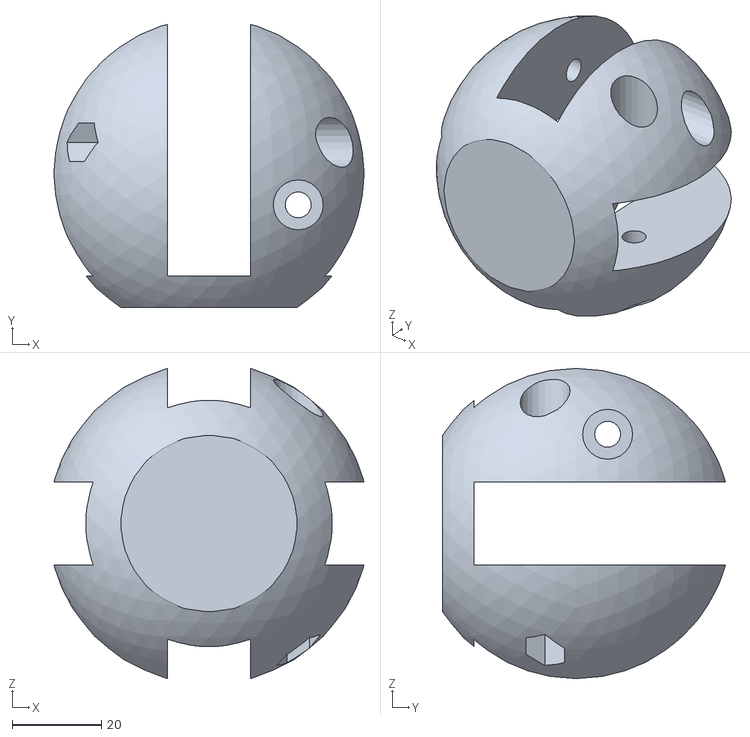
[picture p57: CAD file, 2026-11-04]
history/outputs/cabinet-03-04-engineering-v1/joint-prototype/sphere-T-up-18mm-gap06.stl
69.5 x 63.4 x 69.5
