padington/cambusa-cabinet/history/outputs/cabinet-03-04-engineering-v1/variant-04/back-panel.stl

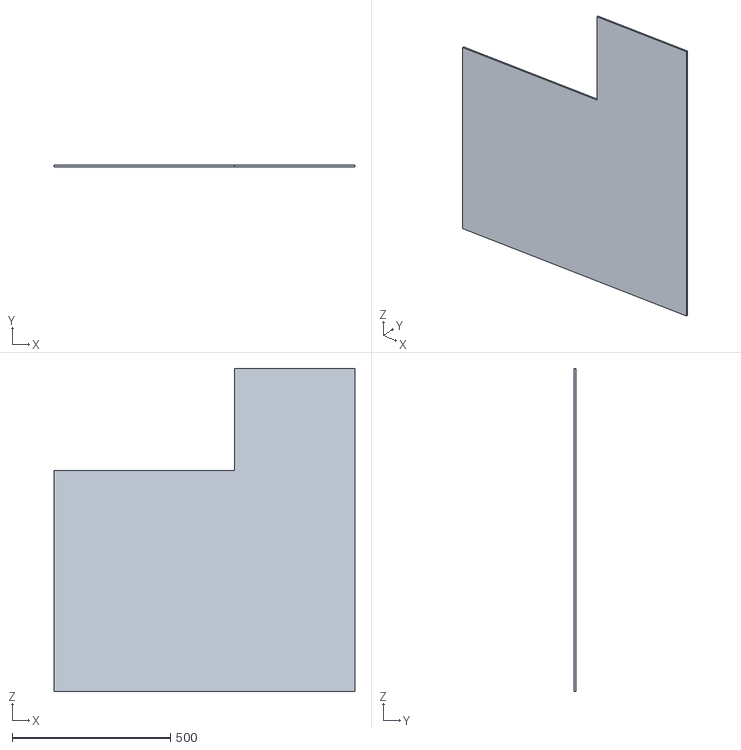
[picture p58: CAD file, 2026-11-04]
history/outputs/cabinet-03-04-engineering-v1/variant-04/back-panel.stl
952.0 x 6.00 x 1022.0
