padington/cambusa-cabinet/history/outputs/order-preparation-v06/quote-outlines/D1-front.dxf

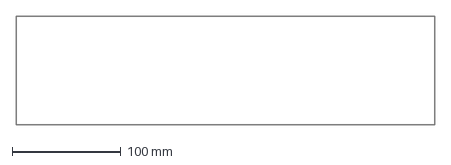
[picture p59: CAD file, 2026-11-04]
history/outputs/order-preparation-v06/quote-outlines/D1-front.dxf
385.0 x 100.0 mm
