padington/cambusa-cabinet/history/outputs/order-preparation-v06/quote-outlines/B70-right.dxf

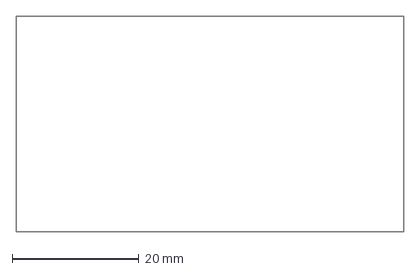
[picture p61: CAD file, 2026-11-04]
history/outputs/order-preparation-v06/quote-outlines/B70-right.dxf
61.0 x 34.0 mm
