padington/cambusa-cabinet/history/outputs/order-preparation-v06/quote-outlines/B11-partition.dxf

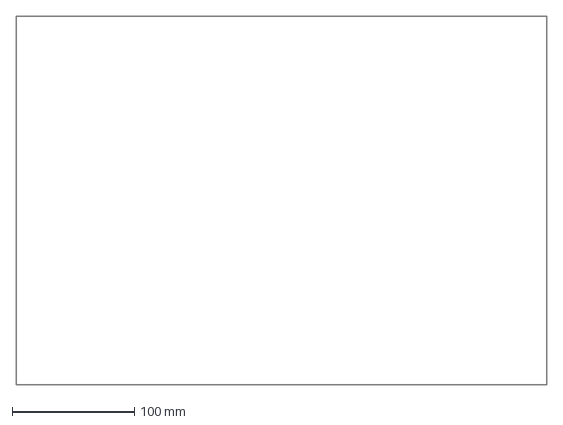
[picture p62: CAD file, 2026-11-04]
history/outputs/order-preparation-v06/quote-outlines/B11-partition.dxf
434.0 x 302.0 mm
