padington/cambusa-cabinet/history/outputs/cabinet-03-04-engineering-v1/variant-03/frame-right.stl

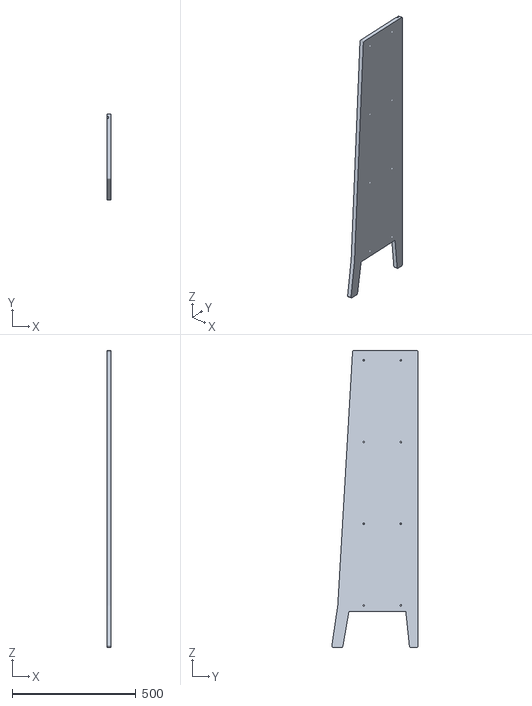
[picture p63: CAD file, 2026-11-04]
history/outputs/cabinet-03-04-engineering-v1/variant-03/frame-right.stl
18.0 x 349.0 x 1200.0
