padington/cambusa-cabinet/history/outputs/order-preparation-v06/quote-outlines/B12-partition.dxf

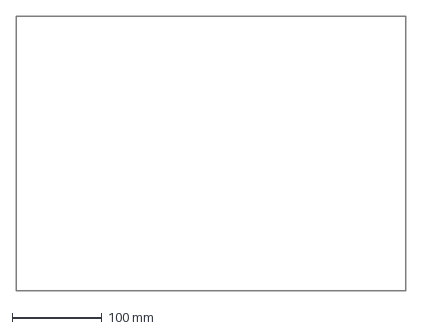
[picture p64: CAD file, 2026-11-04]
history/outputs/order-preparation-v06/quote-outlines/B12-partition.dxf
434.0 x 306.0 mm
