padington/cambusa-cabinet/history/outputs/order-preparation-v06/quote-outlines/B71-bottom.dxf

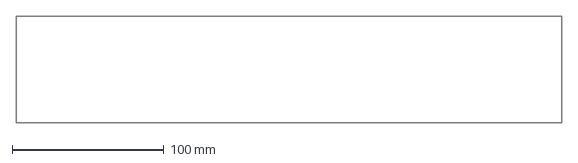
[picture p65: CAD file, 2026-11-04]
history/outputs/order-preparation-v06/quote-outlines/B71-bottom.dxf
360.0 x 70.0 mm
