padington/cambusa-cabinet/history/outputs/cabinet-03-04-engineering-v1/variant-04/node-x600-l2-rear.stl

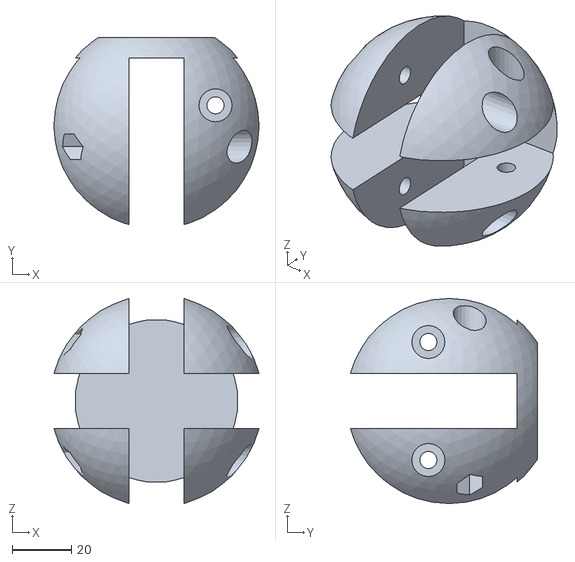
[picture p66: CAD file, 2026-11-04]
history/outputs/cabinet-03-04-engineering-v1/variant-04/node-x600-l2-rear.stl
69.5 x 63.4 x 69.5
