padington/cambusa-cabinet/history/outputs/order-preparation-v06/quote-outlines/B40-back.dxf

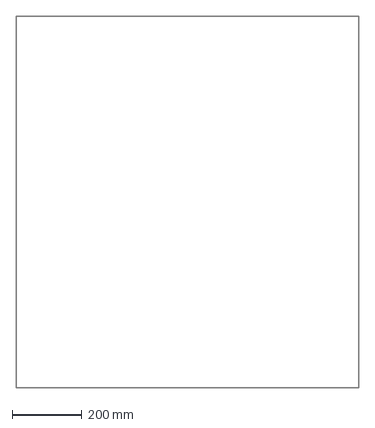
[picture p67: CAD file, 2026-11-04]
history/outputs/order-preparation-v06/quote-outlines/B40-back.dxf
982.0 x 1064.0 mm
