padington/cambusa-cabinet/history/outputs/cabinet-03-04-engineering-v1/variant-03/door-1.stl

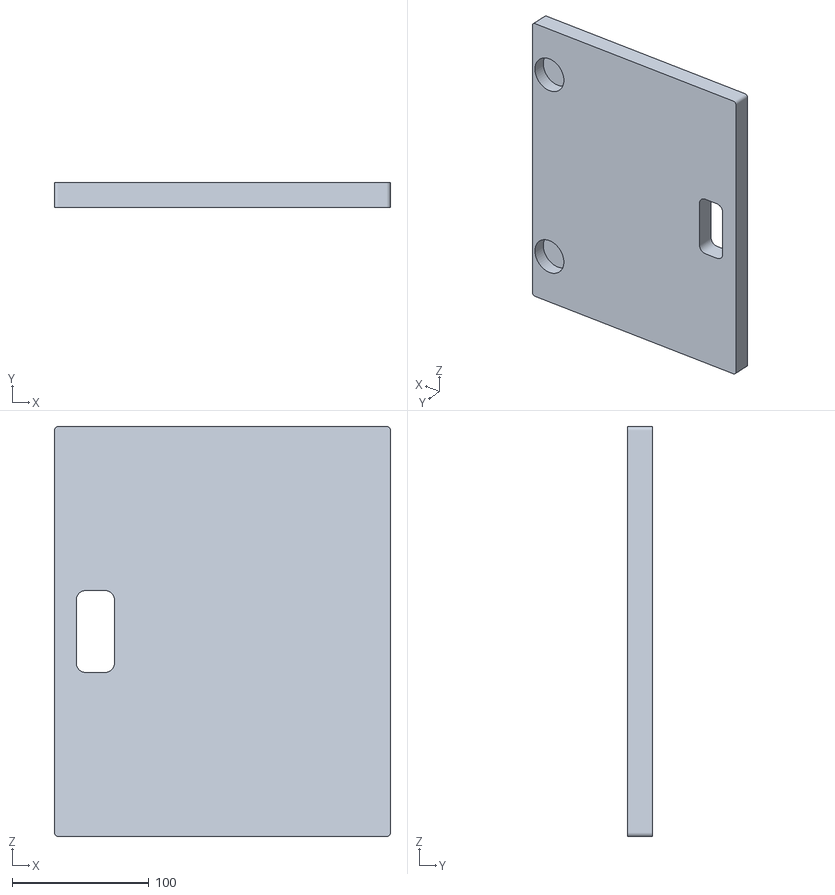
[picture p68: CAD file, 2026-11-04]
history/outputs/cabinet-03-04-engineering-v1/variant-03/door-1.stl
246.0 x 18.0 x 300.0
