padington/cambusa-cabinet/history/outputs/order-preparation-v06/quote-outlines/B71-lip.dxf

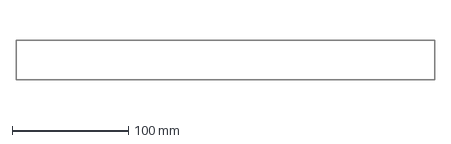
[picture p69: CAD file, 2026-11-04]
history/outputs/order-preparation-v06/quote-outlines/B71-lip.dxf
360.0 x 34.0 mm
