padington/cambusa-cabinet/history/outputs/order-preparation-v06/quote-outlines/B50-pegboard.dxf

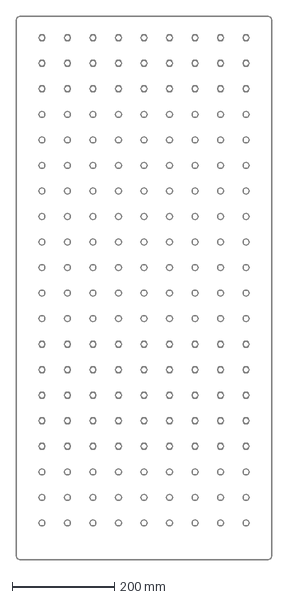
[picture p70: CAD file, 2026-11-04]
history/outputs/order-preparation-v06/quote-outlines/B50-pegboard.dxf
500.0 x 1064.0 mm
