padington/cambusa-cabinet/history/outputs/order-preparation-v06/quote-outlines/B30-right-side.dxf

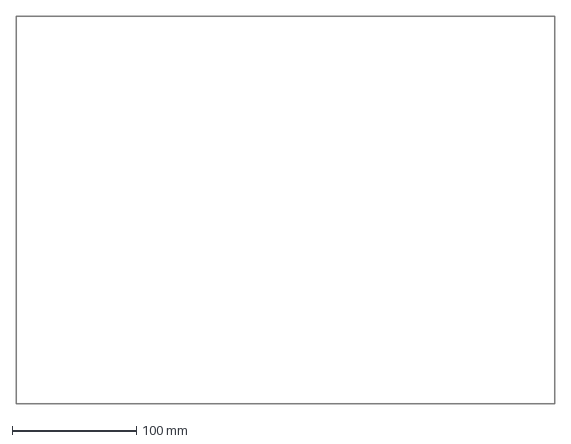
[picture p71: CAD file, 2026-11-04]
history/outputs/order-preparation-v06/quote-outlines/B30-right-side.dxf
434.0 x 312.0 mm
