padington/cambusa-cabinet/history/outputs/order-preparation-v06/quote-outlines/B03-shelf.dxf

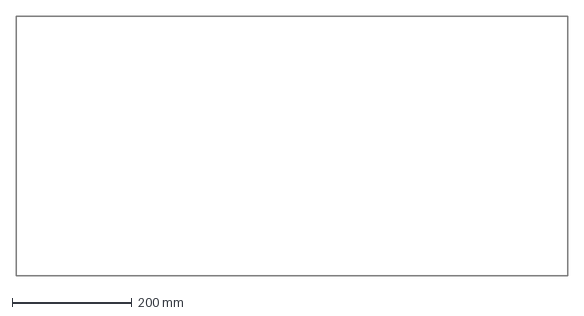
[picture p72: CAD file, 2026-11-04]
history/outputs/order-preparation-v06/quote-outlines/B03-shelf.dxf
922.0 x 434.0 mm
