padington/cambusa-cabinet/history/outputs/cabinet-03-04-engineering-v1/variant-04/shelf-3.stl

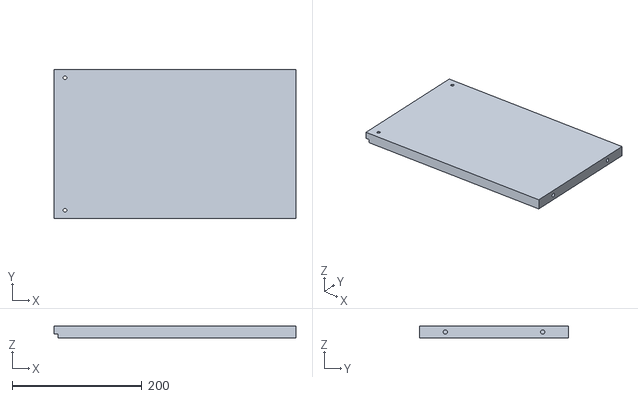
[picture p73: CAD file, 2026-11-04]
history/outputs/cabinet-03-04-engineering-v1/variant-04/shelf-3.stl
373.0 x 230.0 x 18.0
