padington/cambusa-cabinet/history/outputs/order-preparation-v06/quote-outlines/D0-right.dxf

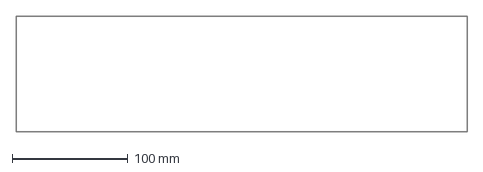
[picture p74: CAD file, 2026-11-04]
history/outputs/order-preparation-v06/quote-outlines/D0-right.dxf
390.0 x 100.0 mm
