padington/cambusa-cabinet/history/outputs/order-preparation-v06/quote-outlines/B60-left-door.dxf

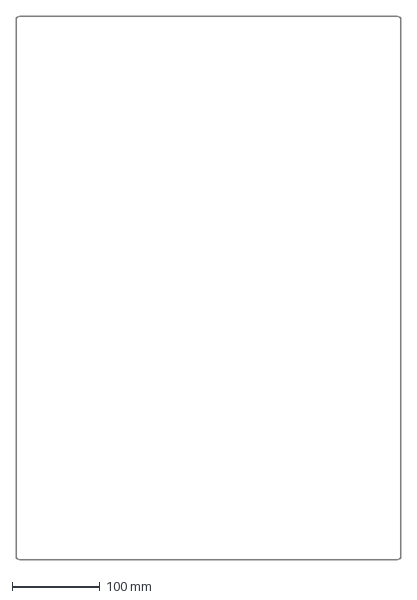
[picture p75: CAD file, 2026-11-04]
history/outputs/order-preparation-v06/quote-outlines/B60-left-door.dxf
439.0 x 620.0 mm
