padington/cambusa-cabinet/history/outputs/order-preparation-v06/quote-outlines/B21-left-side.dxf

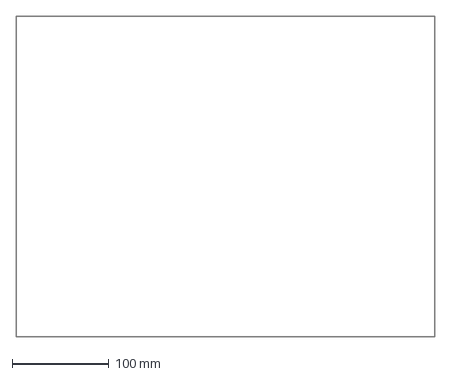
[picture p76: CAD file, 2026-11-04]
history/outputs/order-preparation-v06/quote-outlines/B21-left-side.dxf
434.0 x 332.0 mm
