padington/cambusa-cabinet/history/outputs/order-preparation-v06/quote-outlines/D0-bottom.dxf

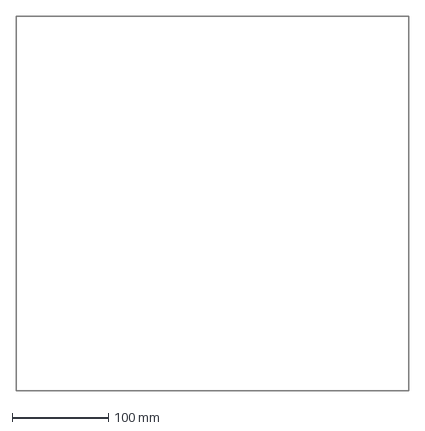
[picture p77: CAD file, 2026-11-04]
history/outputs/order-preparation-v06/quote-outlines/D0-bottom.dxf
409.0 x 390.0 mm
