padington/cambusa-cabinet/history/outputs/order-preparation-v06/quote-outlines/B10-partition.dxf

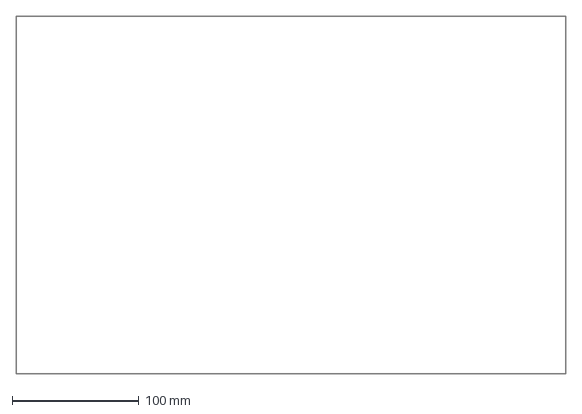
[picture p78: CAD file, 2026-11-04]
history/outputs/order-preparation-v06/quote-outlines/B10-partition.dxf
434.0 x 282.0 mm
