padington/cambusa-cabinet/(list of files, cad)

Other CAD files:
history/outputs/round-cabinet/round-l-15mm-gap03.stl
history/outputs/cabinet-03-04-engineering-v1/variant-03/partition-2.stl
history/outputs/cabinet-03-04-engineering-v1/variant-04/partition-1.stl
history/outputs/cabinet-03-04-engineering-v1/variant-03/shelf-1.stl
history/outputs/cabinet-03-04-engineering-v1/variant-03/node-x700-l2-front.stl
history/outputs/cabinet-03-04-engineering-v1/variant-03/node-x350-l1-front.stl
history/outputs/cabinet-03-04-engineering-v1/variant-03/shelf-2.stl
history/outputs/cabinet-03-04-engineering-v1/variant-04/node-x600-l3-front.stl
history/outputs/cabinet-03-04-engineering-v1/variant-04/partition-2.stl
history/outputs/cabinet-03-04-engineering-v1/variant-03/node-x350-l1-rear.stl
history/outputs/cabinet-03-04-engineering-v1/variant-04/shelf-1.stl
history/outputs/cabinet-03-04-engineering-v1/variant-03/shelf-0.stl
history/outputs/cabinet-03-04-engineering-v1/variant-04/node-x600-l1-rear.stl
history/outputs/cabinet-03-04-engineering-v1/variant-03/node-x600-l0-rear.stl
history/outputs/cabinet-03-04-engineering-v1/variant-04/node-x600-l3-rear.stl
history/outputs/cabinet-03-04-engineering-v1/variant-03/node-x600-l1-front.stl
history/outputs/cabinet-03-04-engineering-v1/variant-04/node-x600-l2-front.stl
history/outputs/cabinet-03-04-engineering-v1/variant-03/node-x350-l2-rear.stl
history/outputs/cabinet-03-04-engineering-v1/variant-04/node-x600-l1-front.stl
history/outputs/cabinet-03-04-engineering-v1/variant-03/shelf-3.stl
history/outputs/cabinet-03-04-engineering-v1/variant-03/node-x700-l2-rear.stl
history/outputs/cabinet-03-04-engineering-v1/variant-03/node-x700-l3-rear.stl
history/outputs/cabinet-03-04-engineering-v1/variant-03/node-x600-l0-front.stl
history/outputs/cabinet-03-04-engineering-v1/variant-03/node-x700-l3-front.stl
history/outputs/cabinet-03-04-engineering-v1/variant-03/node-x350-l2-front.stl
history/outputs/cabinet-03-04-engineering-v1/variant-03/node-x600-l1-rear.stl
history/outputs/cabinet-03-04-engineering-v1/variant-03/frame-left.stl
history/outputs/cabinet-03-04-engineering-v1/variant-03/partition-0.stl
history/outputs/boltfree-cabinet-v03/pilot-samples/01-side-corner/frame-left-assembly-mm.stl
history/outputs/boltfree-cabinet-v03/pilot-samples/01-side-corner/shelf-0-assembly-mm.stl
history/outputs/boltfree-cabinet-v03/pilot-samples/01-side-corner/sphere-side-left-0-assembly-mm.stl
history/outputs/boltfree-cabinet-v03/pilot-samples/02-back-stop/back-panel-assembly-mm.stl
history/outputs/boltfree-cabinet-v03/pilot-samples/02-back-stop/back-stop-left-print-mm.stl
history/outputs/boltfree-cabinet-v03/pilot-samples/03-inner-T/partition-0-assembly-mm.stl
history/outputs/boltfree-cabinet-v03/pilot-samples/03-inner-T/shelf-0-assembly-mm.stl
history/outputs/boltfree-cabinet-v03/pilot-samples/03-inner-T/sphere-inner-x600-0-front-assembly-mm.stl
history/outputs/boltfree-cabinet-v03/pilot-samples/03-inner-T/sphere-inner-x600-0-front-print-mm.stl
history/outputs/boltfree-cabinet-v03/pilot-samples/04-inner-X/key-inner-x600-1-front-1-assembly-mm.stl
history/outputs/boltfree-cabinet-v03/pilot-samples/04-inner-X/sphere-inner-x600-1-front-assembly-mm.stl
history/outputs/boltfree-cabinet-v03/pilot-samples/04-inner-X/sphere-inner-x600-1-front-print-mm.stl
history/outputs/boltfree-cabinet-v03/variant-03/back-panel.stl
history/outputs/boltfree-cabinet-v03/variant-03/back-stop-left.stl
history/outputs/boltfree-cabinet-v03/variant-03/door-0.stl
history/outputs/boltfree-cabinet-v03/variant-03/door-1.stl
history/outputs/boltfree-cabinet-v03/variant-03/frame-left.stl
history/outputs/boltfree-cabinet-v03/variant-03/frame-right.stl
history/outputs/boltfree-cabinet-v03/variant-03/key-inner-x350-1-front-0.stl
history/outputs/boltfree-cabinet-v03/variant-03/key-inner-x350-1-rear-0.stl
history/outputs/boltfree-cabinet-v03/variant-03/key-inner-x350-2-front-0.stl
history/outputs/boltfree-cabinet-v03/variant-03/key-inner-x350-2-rear-0.stl
history/outputs/boltfree-cabinet-v03/variant-03/key-inner-x600-0-front-0.stl
history/outputs/boltfree-cabinet-v03/variant-03/key-inner-x600-1-front-0.stl
history/outputs/boltfree-cabinet-v03/variant-03/key-inner-x600-1-rear-0.stl
history/outputs/boltfree-cabinet-v03/variant-03/key-inner-x700-2-front-0.stl
history/outputs/boltfree-cabinet-v03/variant-03/key-inner-x700-2-rear-0.stl
history/outputs/boltfree-cabinet-v03/variant-03/key-inner-x700-3-front-0.stl
history/outputs/boltfree-cabinet-v03/variant-03/key-inner-x700-3-rear-0.stl
history/outputs/boltfree-cabinet-v03/variant-03/key-side-left-0-0.stl
history/outputs/boltfree-cabinet-v03/variant-03/key-side-left-1-0.stl
history/outputs/boltfree-cabinet-v03/variant-03/key-side-left-2-0.stl
history/outputs/boltfree-cabinet-v03/variant-03/key-side-left-3-0.stl
history/outputs/boltfree-cabinet-v03/variant-03/key-side-right-2-0.stl
history/outputs/boltfree-cabinet-v03/variant-03/key-side-right-3-0.stl
history/outputs/boltfree-cabinet-v03/variant-03/partition-0.stl
history/outputs/boltfree-cabinet-v03/variant-03/partition-1.stl
history/outputs/boltfree-cabinet-v03/variant-03/partition-2.stl
history/outputs/boltfree-cabinet-v03/variant-03/shelf-0.stl
history/outputs/boltfree-cabinet-v03/variant-03/shelf-1.stl
history/outputs/boltfree-cabinet-v03/variant-03/shelf-2.stl
history/outputs/boltfree-cabinet-v03/variant-03/shelf-3.stl
history/outputs/boltfree-cabinet-v03/variant-03/sphere-inner-x350-1-front.stl
history/outputs/boltfree-cabinet-v03/variant-03/sphere-inner-x350-1-rear.stl
history/outputs/boltfree-cabinet-v03/variant-03/sphere-inner-x350-2-front.stl
history/outputs/boltfree-cabinet-v03/variant-03/sphere-inner-x350-2-rear.stl
history/outputs/boltfree-cabinet-v03/variant-03/sphere-inner-x600-0-front.stl
history/outputs/boltfree-cabinet-v03/variant-03/sphere-inner-x600-0-rear.stl
history/outputs/boltfree-cabinet-v03/variant-03/sphere-inner-x600-1-front.stl
history/outputs/boltfree-cabinet-v03/variant-03/sphere-inner-x600-1-rear.stl
history/outputs/boltfree-cabinet-v03/variant-03/sphere-inner-x700-2-front.stl
history/outputs/boltfree-cabinet-v03/variant-03/sphere-inner-x700-2-rear.stl
history/outputs/boltfree-cabinet-v03/variant-03/sphere-inner-x700-3-front.stl
history/outputs/boltfree-cabinet-v03/variant-03/sphere-inner-x700-3-rear.stl
history/outputs/boltfree-cabinet-v03/variant-03/sphere-side-left-0.stl
history/outputs/boltfree-cabinet-v03/variant-03/sphere-side-left-1.stl
history/outputs/boltfree-cabinet-v03/variant-03/sphere-side-left-2.stl
history/outputs/boltfree-cabinet-v03/variant-03/sphere-side-left-3.stl
history/outputs/boltfree-cabinet-v03/variant-03/sphere-side-right-2.stl
history/outputs/boltfree-cabinet-v03/variant-03/sphere-side-right-3.stl
history/outputs/boltfree-cabinet-v03/variant-04/back-panel.stl
history/outputs/boltfree-cabinet-v03/variant-04/back-stop-left.stl
history/outputs/boltfree-cabinet-v03/variant-04/back-stop-right.stl
history/outputs/boltfree-cabinet-v03/variant-04/door-0.stl
history/outputs/boltfree-cabinet-v03/variant-04/door-1.stl
history/outputs/boltfree-cabinet-v03/variant-04/frame-left.stl
history/outputs/boltfree-cabinet-v03/variant-04/key-inner-x600-0-rear-0.stl
history/outputs/boltfree-cabinet-v03/variant-04/key-inner-x600-1-front-0.stl
history/outputs/boltfree-cabinet-v03/variant-04/key-inner-x600-1-front-1.stl
history/outputs/boltfree-cabinet-v03/variant-04/key-inner-x600-1-rear-0.stl
history/outputs/boltfree-cabinet-v03/variant-04/key-inner-x600-1-rear-1.stl
history/outputs/boltfree-cabinet-v03/variant-04/key-inner-x600-2-front-0.stl
history/outputs/boltfree-cabinet-v03/variant-04/key-inner-x600-2-front-1.stl
history/outputs/boltfree-cabinet-v03/variant-04/key-inner-x600-2-rear-0.stl
history/outputs/boltfree-cabinet-v03/variant-04/key-inner-x600-2-rear-1.stl
history/outputs/boltfree-cabinet-v03/variant-04/key-inner-x600-3-front-0.stl
history/outputs/boltfree-cabinet-v03/variant-04/key-inner-x600-3-rear-0.stl
history/outputs/boltfree-cabinet-v03/variant-04/key-side-left-1-0.stl
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
