padington/cambusa-cabinet/history/outputs/assembly-method-v11/МЕТОДОЛОГИЯ.md

# Методология подготовки и сборки шкафа

Шкаф проектируется как комплект отдельных готовых деталей. Владелец заказывает фанеру с обработкой и отделкой, подготовленный алюминиевый профиль и мебельную фурнитуру, затем собирает всё дома ключами и отвёрткой. Пиление, сверление, фрезеровка и подгонка дома в этот процесс не входят.

Это рабочая методология проекта Cambusa. Порядок ниже задаёт проверки и предполагаемую последовательность сборки. Окончательная инструкция с расположением каждого крепления появится после выпуска присадки и проверки контрольных узлов. На 3 ноября 2026 года полный комплект к изготовлению не выпущен.

## Принятые решения

| Параметр | Решение |
|---|---|
| Внешняя форма | Компактный деревянный корпус на высоком тонком основании, в духе Cambusa Fly |
| Габариты | Ширина 1000, высота 1800, глубина 500 мм |
| Разделение высоты | Корпус 1000 и основание 800 мм; это наши проектные пропорции |
| Материал | Тёмная берёзовая фанера; предварительно 18, 12 и 9 мм |
| Основание | Разборное, чёрный алюминиевый профиль 30 × 30 мм, серия 30, паз 8 |
| Организация хранения | Две дверцы, шесть лотков на дверцах, четыре полки, два внутренних ящика |
| Боковина | Перфорация по всей правой деревянной боковине |
| Колёса | Отменены |
| Домашний инструмент | Шестигранник, PZ2 и ключ для опор; точные размеры по окончательной фурнитуре |
| Исполнение | Владелец собирает корпус, основание, короба ящиков и лотки из отдельных деталей |

Помощник требуется при подъёме крупного корпуса на основание и установке дверей. Возможность собрать весь высокий шкаф строго в одиночку пока не проверена.

## Артефакты и их назначение

| Артефакт | Для чего нужен | Текущий статус |
|---|---|---|
| [Форма v08](../cambusa-proportions-v08/open.glb) | Смотреть пропорции и внутреннюю компоновку | Выбрана пользователем; условные узлы |
| [Подбор деталей v09](../parts-spec-v09/ДЕТАЛИ.md) | Сопоставлять фурнитуру, артикулы и поставщиков | Кандидаты, часть поставок требует уточнения |
| [Чертежи и раскладка v10](../layout-cost-v10/Чертежи-и-раскладка-v10.pdf) | Проверять размеры заготовок, нумерацию и размещение на листах | 48 деталей на пяти листах; присадка не выпущена |
| [Смета и ведомость v10](../layout-cost-v10/Смета-и-детали-v10.xlsx) | Считать целые листы, комплектующие, обработку, отделку и доставку | Плановые количества; прайсы и допущения разделены |
| [Комплект основания](../layout-cost-v10/ОСНОВАНИЕ.md) | Заказывать профиль и совместимый крепёж без задвоения комплектов | Кандидаты найдены; высота опор и узлы требуют проверки |
| Эта методология | Сохранять общий процесс и критерии перехода к следующему этапу | Рабочая версия v11 |
| Производственные файлы и окончательная инструкция | Изготовить детали и собрать шкаф без догадок | Ещё не выпущены |

Номера W01–W48 относятся к ведомости v10. В ней рядом сохранены исходные коды модели, например B00-bottom. Номер детали на чертеже, на карте раскроя, в ведомости и на упаковке должен совпадать.

## Как двигаться от эскиза к заказу

### Зафиксировать конфигурацию

Сначала связываем одну выбранную модель, одну ведомость деталей и одну спецификацию фурнитуры. Для каждого нового изменения записываем, что оно меняет: внешний вид, соединение, размер заготовки, отверстия, раскладку, цену или порядок сборки.

В v10 раскладка использует предложения v09: накладной задник и днища ящиков в пазах. Эти изменения ещё не перенесены в модель с реальной фурнитурой. До производственного выпуска модель и ведомость нужно синхронизировать.

### Проверить реальные соединения

Для каждого соединения составляем маленький монтажный чертёж: какие две детали соединяются, где стоят отверстия, какая фурнитура используется и с какой стороны подходит инструмент. Проверяем не только собранное положение, но и движение детали при установке.

| Узел | Что должно быть проверено |
|---|---|
| Основание | Уголки помещаются в трёхстороннем углу, винты доступны ключу, гайки можно завести в паз до закрытия торцов |
| Опоры | Центральный канал профиля допускает нужную резьбу; определены глубина резьбы и установленная высота опоры |
| Корпус | Каждый эксцентрик соответствует толщине фанеры; шток и отверстия образуют одну совместимую систему |
| Полки и перегородка | Все неподвижные полки можно установить до закрытия корпуса; после закрытия к эксцентрикам остаётся доступ |
| Ящики | Ширина и длина короба соответствуют направляющим; дно, задние вырезы и замки совместимы между собой |
| Дверцы | Петли открываются с лотками и освобождают путь ящикам; отверстия не конфликтуют с перфорацией |
| Лотки | Уголки и короткие шурупы помещаются, держат детали и не выходят насквозь |

Для проверки используем документацию именно выбранных изделий: [Blum TANDEM](https://d2.blum.com/services/BEC003/me16460573_ep_dok_bau_%24sru_%24aof_%24v4.pdf), [петли Blum 155°](https://d2.blum.com/services/BEC003/clp0034-fl-335_fl_dok_bau_%24sru_%24aof_%24v2.pdf), [присадка Hettich Rastex](https://catalog.hettich.com/General/TuI/ru_RU/catalogs/TuI_ru_RU/pdf/save/bk_1265.pdf) и [уголок RSI 1037](https://www.rsi-llc.ru/catalog/73/424/). Рейтинг отдельного изделия не переносим на весь шкаф.

### Заказать контрольные детали

До полного комплекта проверяем один угол основания, одно соединение фанеры, один лоток и один ящик с направляющими. Образцы должны иметь те же материал, обработку и покрытие, что и основной комплект: покрытие и фактическая толщина влияют на посадки.

Принимаем образец, если детали соединяются разрешённым инструментом без сверления и подрезки, крепёж доступен, шурупы не выходят насквозь, а механизм работает по всему ходу. После изменения узла повторяем его проверку и обновляем затронутые файлы. Нагрузку на полки, ящики, дверные лотки и шкаф назначаем отдельно после проверки конструкции.

### Выпустить комплект для изготовления

Для каждой деревянной детали нужны чистовой контур, толщина, направление шпона, все отверстия и карманы с привязками и глубинами, пазы, обработка кромок и обозначение лицевой стороны. Отдельно указываем, какие припуски уже заложены и какие допуски согласованы.

Раскладку пересчитываем после фиксации чистовых размеров, фрезы, припусков и материала. Текущий расчёт: край 10 мм, зазор 8 мм, фреза до 6 мм. Это раскладка для ЧПУ; она не задаёт последовательность прямых резов на форматном станке. Мелкие детали требуют крепления во время фрезеровки и снятия технологических перемычек до доставки.

В заказ профиля включаем отрезки, резьбы, удаление заусенцев и нарезку ленты пазов. Формула стойки — 770 мм минус установленная высота опоры. Размер 750 мм допустим только в расчётном примере при высоте опоры 20 мм.

У поставщиков подтверждаем не только цену, но и состав работ, минимальную фасовку, фактический сорт и толщину, отделку, комплектность фурнитуры, маркировку и упаковку. Согласование цены не означает разрешения на изменение чертежа. Сборку корпуса, ящиков и основания поставщику не передаём.

## Предполагаемый порядок домашней сборки

### Приёмка и подготовка

Сверить 48 деревянных деталей по кодам, отдельные профили и комплектность крепежа. Проверить отверстия, торцы, покрытие и наличие подготовленных резьб. Детали с несовпадающими отверстиями или неполной обработкой возвращаем на исправление по чертежу, а не дорабатываем дома.

Разложить детали на мягкой ровной поверхности. Отделить рабочий крепёж от запаса. Комплекты уголков уже содержат по два винта и две Т-гайки; их не нужно покупать или считать второй раз. В комплекты направляющих включены передние замки.

### Собрать основание

1. Заранее завести в пазы гайки, которые окажутся недоступны после закрытия торцов. Отметить переднюю сторону: нижняя поперечина находится сзади.
2. Соединить верхнюю раму, стойки и нижние связи по окончательной схеме узлов. До выравнивания оставить возможность небольшой регулировки соединений.
3. Проверить прямоугольность и отсутствие перекоса, затем затянуть крепёж по требованиям изготовителя соединений. Момент затяжки самостоятельно не назначаем.
4. Вкрутить опоры в готовые резьбы и зафиксировать их контргайками. Проверить контакт всех четырёх опор с полом. Крышки уголков и ленту ставить после контроля затяжки и доступа к креплению корпуса.

Расстановка 18 уголков — проектная. Конкретная последовательность соединения рам утверждается после проверки первого угла и доступа инструмента.

### Собрать деревянный корпус

Установить штоки, эксцентрики и шканты в предназначенные для них подготовленные отверстия. Не переносить эксцентрики для 18 мм в детали 12 мм. Не добавлять клей в разборные соединения без изменения конструкции.

Принцип сборки внутренних секций — последовательно связать боковину, полки левой секции, перегородку, полки правой секции и вторую боковину, затем закрыть верх и низ. Этот порядок должен быть проверен на фактическом расположении штоков: если панели невозможно надвинуть на крепёж, меняем конструкцию соединения до изготовления.

Неподвижные полки на эксцентриках устанавливаются до окончательного закрытия корпуса. Нельзя заранее считать, что их удастся вставить в уже закрытый короб. Монтажные планки петель и направляющие ставим тогда, когда их отверстия доступны; двери и ящики пока не навешиваем.

Выровнять корпус, проверить прямоугольность и установить накладной задник в предусмотренные отверстия. Задник не должен стягивать изначально перекошенный корпус. Контроль затяжки провести до закрытия эксцентриков декоративными крышками.

### Соединить корпус с основанием

Поднимать корпус без дверей, лотков и вставленных ящиков с помощником. Установить его на основание и совместить подготовленные отверстия с Т-гайками. Изнутри закрепить корпус восемью рабочими винтами; два дополнительных винта остаются запасными. Убедиться, что головки утоплены и не мешают ящикам.

Длину винтов, точки крепления и способ удержания корпуса при подъёме фиксируем в окончательной инструкции. До установки дверей должно быть выполнено выбранное решение устойчивости; оно пока не спроектировано.

### Собрать и установить ящики

Пазы удерживают днище, поэтому днище заводится до закрытия последней стенки короба. Установить задние вырезы и крепления по чертежу TANDEM, собрать короб, затем поставить замки и внутренний фасад. Перед установкой сверить левую и правую стороны направляющих и замков.

Вставить ящик на направляющие и проверить фиксацию, плавный полный ход, работу доводчика и снятие ящика штатными замками. Проверять без груза. Если есть заедание, выяснить причину в размерах или установке; не увеличивать отверстия дома.

### Собрать лотки и навесить дверцы

Лотки собираем и крепим на лежащей дверце, затем устанавливаем чашки петель в готовые гнёзда. У шурупов лотков должна быть проверена длина с учётом толщины уголка: фанера 9 мм не допускает произвольной замены короткого крепежа длинным.

Навесить дверцы с помощником на монтажные планки, проверить защёлкивание петель и отрегулировать зазоры штатными винтами. Проверить закрывание и весь ход открывания без столкновений лотков, полок, петель и выдвинутых ящиков. Фактический допустимый угол определяем по собранному узлу, а не по условной оси в ранней модели.

## Приёмка собранного шкафа

- Все соединения собраны предусмотренным крепежом, к ним был доступ разрешённым инструментом.
- Корпус закреплён к основанию; основание стоит на четырёх опорах и не качается.
- Дверцы и ящики открываются и закрываются без контакта с соседними деталями.
- Все фиксаторы петель и ящиков работают; буферы и крышки установлены после контроля.
- Решение устойчивости выполнено до использования дверных лотков и загрузки книгами.
- Допустимые нагрузки записаны по результатам проверки конструкции. До этого не назначаем шкафу нагрузку по грузоподъёмности одной петли или направляющей.

Нагрузку увеличиваем по согласованной программе проверки, по одному отсеку за раз. Тяжёлые предметы размещаем ниже, но это не заменяет проверку устойчивости высокого шкафа с открытыми дверями и ящиками.

## Как сохранять проект и возвращаться к версиям

Один общий каталог содержит выбранную форму и связанные с ней документы. Новая раскладка или смета не заменяет выбранную 3D-модель автоматически. У каждого файла есть версия и назначение; статус производственного выпуска хранится отдельно от статуса эскиза.

При изменении сохраняем новый снимок, обновляем ссылки и делаем отдельную запись истории. Старые модели, рисунки, ведомости и теги не перезаписываем. Проверяем контрольные суммы старых файлов. После значимого выпуска обновляем резервный архив с историей.

Для восстановления достаточно назвать версию в чате, например «верни форму cambusa-v08». Откат формы не отменяет новые требования автоматически: тёмная отделка, отсутствие колёс и самостоятельная сборка остаются актуальными, пока пользователь не изменит их.

Полный архив нужно скопировать в выбранное владельцем резервное место. Локальная история на этом же компьютере помогает откатываться, но не защищает от потери компьютера или диска. Публикация и отправка документов поставщикам выполняются только по отдельному поручению.

## Ближайший следующий этап

Синхронизировать модель с размерами v10 и реальной фурнитурой. Затем проверить угол основания, опору, соединение корпуса, лоток и ящик; выпустить присадку и окончательную последовательность сборки. После этого пересчитать раскладку и подтвердить стоимость полного заказа.
