padington/cambusa-cabinet/history/outputs/boltfree-cabinet-v03/assembled.png

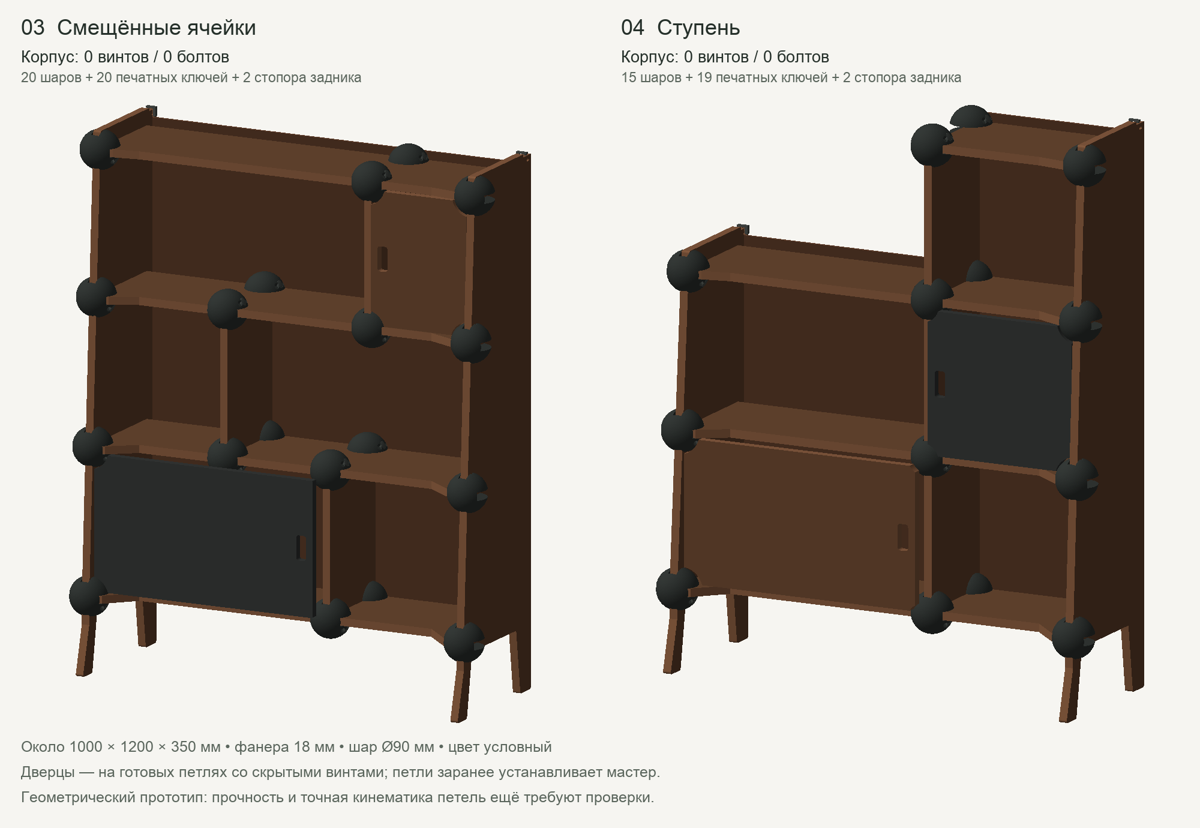
history/outputs/boltfree-cabinet-v03/assembled.png
