padington/cambusa-cabinet/history/outputs/cabinet-six-concepts/04-step.png

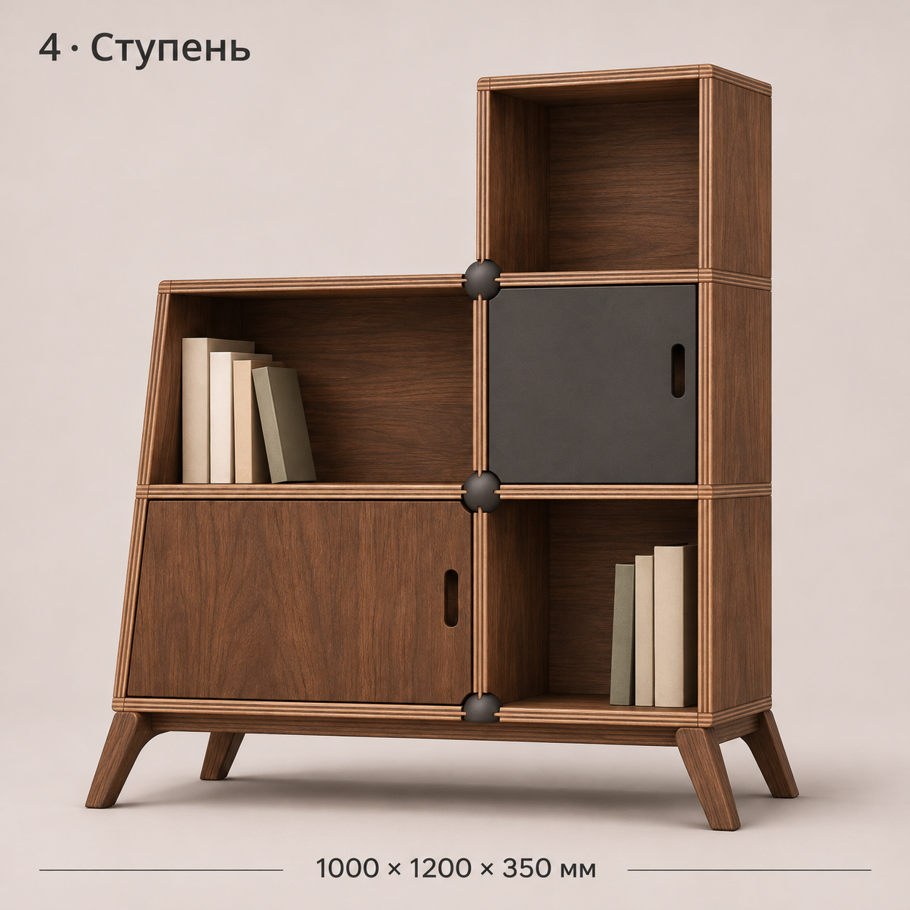
history/outputs/cabinet-six-concepts/04-step.png
