padington/cambusa-cabinet/history/outputs/drawer-proof-v13/assembled.png

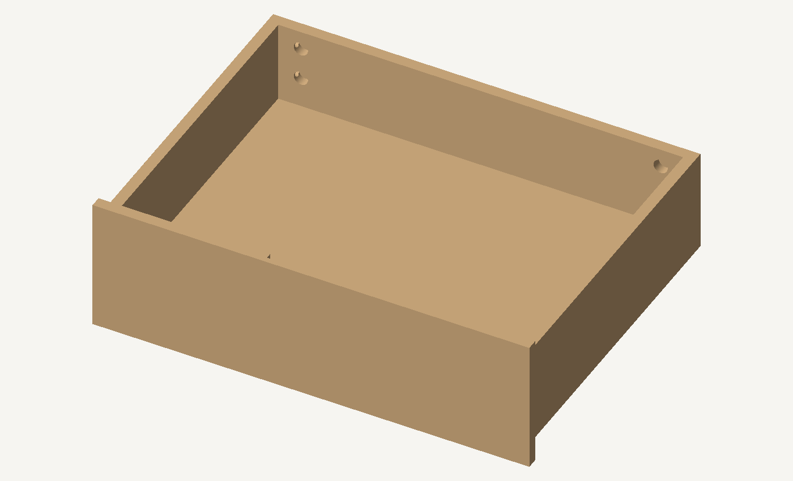
history/outputs/drawer-proof-v13/assembled.png
