padington/cambusa-cabinet/history/outputs/order-preparation-v06/assembled.png

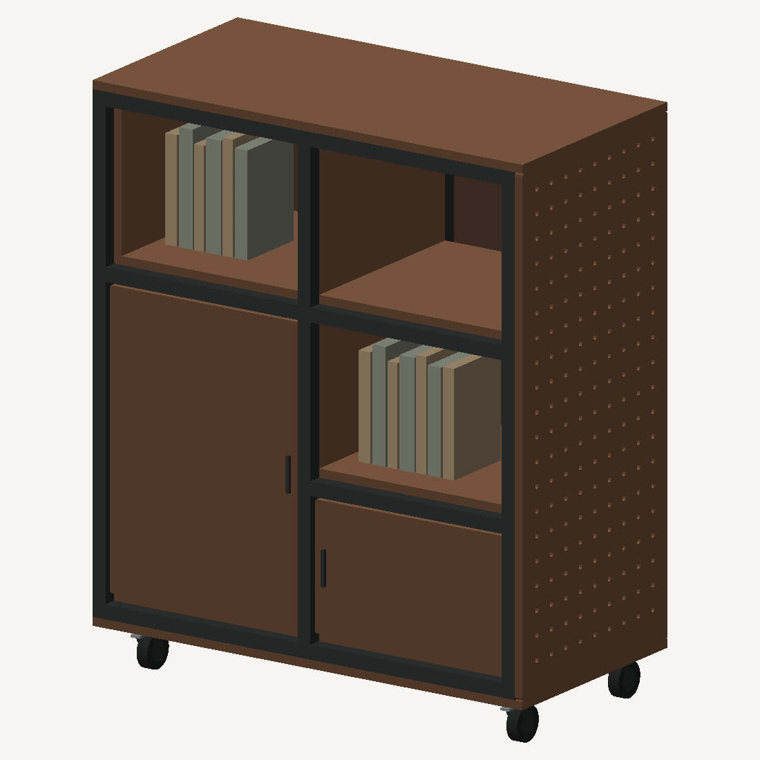
history/outputs/order-preparation-v06/assembled.png
