padington/cambusa-cabinet/history/outputs/sphere-bayonet-v02/assembled.png

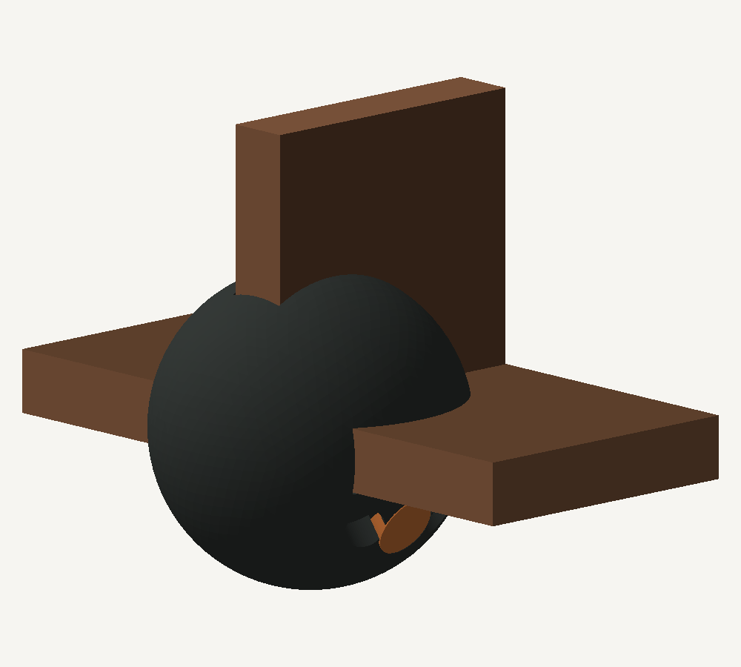
history/outputs/sphere-bayonet-v02/assembled.png
