padington/cambusa-cabinet/history/outputs/cabinet-03-04-engineering-v1/READ-ME-RU.txt

ТУМБА: ВАРИАНТЫ 03 И 04 — ИССЛЕДОВАНИЕ СБОРКИ, ВЕРСИЯ 1
Дата: 3 ноября 2026

Статус: точные объёмные модели для обсуждения и пробного узла.
Это НЕ комплект, разрешённый к полному производству.

В обоих вариантах:
• Габарит с наружными ручками: 1000 × 1200 × 350 мм.
• Основная фанера — условно 18 мм; задняя стенка — 6 мм.
• Глубина самих полок — 230 мм. Часть общей глубины занята фасадами,
  соединителями и задней стенкой. Крупные альбомы нужно проверять отдельно.
• Боковины стоят вертикально. Наклон есть в их переднем контуре и ножках:
  это плоские детали для контурной фрезеровки, гнуть фанеру не требуется.
• Деревянные пазы поддерживают полки. Металлические винты и гайки удерживают
  соединения. Напечатанные детали не считаются единственными несущими опорами.

ЧЕМ ОТЛИЧАЕТСЯ ОТ КРАСИВОГО ЭСКИЗА
Вариант 03 сохраняет три смещённые перегородки, две дверцы и открытые ниши.
Вариант 04 имеет общие панели вместо пяти отдельных коробов с двойными стенками.
Шаровые узлы остались на внутренних пересечениях. На боковинах стоят обычные
металлические мебельные стяжки с ручками: сплошная боковая панель мешала бы
надеть шар с закрытой передней перемычкой. Это исправление геометрии.
Печатные шарики Ø72 мм получили выступающие ручки: их можно захватить пальцами,
при этом ручки не сталкиваются друг с другом. Внешний вид ещё можно улучшать.

СОСТАВ
03: 12 деревянных деталей, 12 сферических узлов, 24 винта М5 для узлов,
    16 боковых стяжек М6. В том числе 2 боковины, 4 полки, 3 перегородки,
    задник и 2 дверцы.
04: 12 деревянных деталей, 8 сферических узлов, 20 винтов М5 для узлов,
    14 боковых стяжек М6.
В дерево заранее установлены металлические поперечные гайки; в шарики —
шестигранные гайки. Их временное удержание до затяжки должен обеспечить цех.
Все отверстия, пазы, шлифовка, покрытие и первоначальная установка петель —
до доставки. Для домашней сборки предполагаются готовые детали и ручные винты.

ПОРЯДОК СБОРКИ
1. На мягкой ровной поверхности собрать центральную решётку: нижняя полка,
   первая перегородка, следующая полка и так далее. Перегородки ставятся
   ДО замыкания следующих полок: потом в закрытые пазы их не вставить.
2. Сдвинуть боковины на торцы полок. Затянуть боковые ручные стяжки.
3. Надвинуть передние шаровые узлы на кромки, затем вставить и затянуть винты.
4. Поддерживая корпус, открыть доступ сзади и поставить задние узлы.
   Для переворота пока заложен помощник; удобство сборки одним человеком
   не подтверждено.
5. Вставить задник СВЕРХУ в открытые сверху пазы боковин. При ранее установленном
   заднике задние узлы надеть нельзя. Верхние ограничители подъёма задника
   ещё нужно спроектировать и испытать; без них корпус не считать завершённым.
6. Пристегнуть дверцы на заранее установленную и отрегулированную фурнитуру.
7. Защита от опрокидывания требует подходящего крепления к стене. Установка
   настенного крепежа — отдельная операция с инструментом или готовой опорой.

ЧТО ПРОВЕРЕНО НА КОМПЬЮТЕРЕ
• Все объёмные детали замкнуты.
• Проверены все пары деталей: 10 296 пар в 03, 7 381 пара в 04.
  Непредусмотренных объёмных пересечений после исправлений: 0.
• Проверены дискретные положения установки полок, перегородок, боковин,
  шариков с гайками, винтов с ручками и задника: 1269 положений в 03,
  1061 положение в 04. В последних 10 мм хода проверки сгущены.
  Пересечений в проверенных положениях: 0. Это НЕ доказательство непрерывного
  движения при любых перекосах и деформациях.
• Для захвата ручек узлов проверены два условных пальцевых объёма Ø12 мм:
  пересечений с корпусом и крепежом нет. Реальная эргономика ещё не испытана.
• Дверцы проверены от 0 до 110° с шагом 5° вокруг УСЛОВНОЙ оси.
  Это не точная кинематика мебельной петли. Модель конкретной петли и монтажные
  блоки должны быть согласованы с мебельным цехом до производства.

ЧТО ЕЩЁ НЕ ПРОВЕРЕНО
Прочность печати, ползучесть пластика под длительной нагрузкой, жёсткость корпуса,
допустимая масса книг, устойчивость, поведение при толчке, удержание задника,
точная модель петель, удобство затяжки реальными руками и сборка одним человеком.
На эти параметры нет готового подтверждённого результата или нагрузочного допуска.

ПЕРВЫЙ РЕАЛЬНЫЙ ОБРАЗЕЦ
В joint-prototype находятся:
• sphere-T-up-18mm-gap06.stl — корпус одного Т-узла;
• finger-grip-for-M5x60.stl — ручка, нужно 2 штуки;
• fit-coupon-slots-18p2-18p6-19p0.stl — три пробные ширины паза;
• plywood-shelf-coupon.stl и plywood-divider-coupon.stl — два деревянных образца;
• test-joint.glb — образец в сборе.
STL заданы в миллиметрах. GLB — в метрах по принятому формату.
Печатные и деревянные детали нельзя путать: деревянные образцы ФРЕЗЕРОВАТЬ.

Для образца предусмотрены два металлических винта М5×60 с шестигранной головкой
под ключ 8 мм и две гайки М5 под ключ 8 мм. Внутренний шестигранный карман ручки
открыт со стороны головки: винт вставляется до упора, ручка вращает его.
Размеры фактических головок, гаек, длины резьбы и захвата проверить до печати.
На полный корпус не распространяется обещание совместимости с любым покупным
крепежом: выбраны номинальные геометрические размеры.

Посадки в этой версии:
• Паз в шаре 18,6 мм под номинальную фанеру 18 мм: по 0,3 мм с каждой стороны.
• Деревянный паз шириной 18,6 мм, номинальное заглубление перегородки 6 мм,
  в модели глубина выборки 6,3 мм оставляет 0,3 мм по глубине.
• Отверстия под М5 Ø5,8 мм; под М6 Ø6,8 мм.
Сначала измерить реальную готовую фанеру и проверить пробник. Точность принтера,
толщина шпона и покрытия могут потребовать изменения этих значений.

ЧТО ЗАПРОСИТЬ У МАСТЕРСКИХ
Сначала один узел и два деревянных образца. У печатников — согласование ориентации,
материала, периметров, заполнения и посадок, затем фактическая проверка. У цеха —
двусторонняя фрезеровка с точной привязкой, глухие пазы и сверловка, отсутствие
расслоения на кромках. Полную тумбу резать после испытания образца и доработки
ограничителей задника/петель. Материал печати и допустимую нагрузку не назначать
только по красивому виду детали или по наличию пластика в прайсе.

ФАЙЛЫ
assembled.png — два актуальных вида.
exploded.png — разнесённые детали; это не одновременное направление их установки.
open.png — условное открывание фасадов.
joint-prototype.png — крупно первый узел.
variant-03, variant-04 — GLB сборки, GLB разнесённого вида, отдельные STL,
  размеры деревянных деталей и подробный отчёт геометрических проверок.
GLB/STL подходят для просмотра в 3D, но не заменяют согласованные чертежи ЧПУ
с инструментом, базами, допусками и финишной обработкой.

ИСТОЧНИКИ ПО ФУРНИТУРЕ И ЭКСПЛУАТАЦИИ
Бесинструментальное пристёгивание предварительно установленных CLIP-петель:
https://www.blum.com/gb/en/products/hingesystems/clip-top/assembly/
Пластик PETG, общие сведения производителя, без подтверждения нашей нагрузки:
https://help.prusa3d.com/article/petg_2059
Защита высокой мебели от опрокидывания:
https://www.cpsc.gov/Safety-Education/Safety-Education-Centers/AnchorItgov
