padington/cambusa-cabinet/history/outputs/round-cabinet/README.md

# Высокая тумба с круглыми соединителями — эскиз v0.1

Принятые размеры: 1200 × 400 × 350 мм, фанера 15 мм, верхняя открытая ниша и нижняя дверца. Это собственная геометрия по принципу модульных соединителей; чужие STL не копировались.

## Что открыть

- `round-cabinet.scad` — редактируемый источник для бесплатного OpenSCAD: https://openscad.org/downloads.html . По умолчанию показывает тумбу целиком. `part` переключает сборку, угловой соединитель, Т-образный соединитель и образец посадки. `door_angle` открывает дверь. Основные размеры и ширина паза вынесены в параметры. Для полного пересчёта и экспорта STL в OpenSCAD используйте Render (F6).
- `cabinet-concept.glb` — цветная сборка для просмотра, размеры записаны в метрах согласно стандарту glTF. Узлы раздельные. Это визуальный эскиз корпуса и фурнитуры.
- `round-l-15mm-gap03.stl` — круглый угловой соединитель Ø56 × 28 мм; исходный вариант паза 15,30 мм.
- `round-t-15mm-gap03.stl` — Т-образный соединитель тех же внешних размеров для полки под нишей.
- `fit-test-015-030-045.stl` — небольшой образец 95 × 26 × 10 мм с пазами 15,15 / 15,30 / 15,45 мм слева направо, если смотреть на длинную сторону и держать крайний узкий паз слева. В редакторе это порядок по оси X от меньшего к большему. Перед снятием образца со стола принтера подпишите пазы в этом порядке. Образец проверяет только посадку, а не прочность соединения.
- `geometry-checks.json` — результаты проверки замкнутости, числа отдельных тел, габаритов и объёма STL.
- `assembly-checks.json` — проверка отсутствия пересечений дверцы с фанерой и соединителями при открытии на 0 / 30 / 60 / 75 / 90°. Проверка не охватывает подбор и работу реальных петель.

## Конструкция

Габариты включают выступающие круглые соединители и заднюю стенку; металлические противоопрокидывающие крепления выступают дополнительно на 2 мм. Боковины непрерывные. Верхняя, нижняя и разделительная панели стоят между ними. Соединители надвигаются на передние и задние кромки. У каждого есть сплошная лицевая стенка 4 мм и пазы глубиной 24 мм. Они не требуют выборки круглых отверстий в фанере.

Предварительно нужны 8 угловых и 4 Т-образных соединителя. Правые и верхние угловые детали получаются поворотом одного L-соединителя. Т-деталь также переворачивается для противоположной стороны.

Чистый проём ниши — 329 мм по ширине и 287 мм по высоте. В нижнем отделении показана одна съёмная полка на обычных металлических полкодержателях. Дверца прямоугольная, 325 × 778 мм, с круглым отверстием вместо выступающей ручки. Узкие неподвижные планки над и под дверцей дают ей пройти между круглыми узлами. В планках потребуются выемки под соединители; это дополнительный фигурный рез.

Задняя стенка 6 мм крепится винтами/шурупами к корпусу через проставки 4 мм между круглыми узлами. Она нужна для жёсткости корпуса. Петли и два крепления к стене предполагаются металлическими и показаны схематично: их марку и отверстия эта модель не задаёт. Высокая тумба должна быть закреплена к подходящей стене соответствующим крепежом.

## Сначала пробная печать

1. Измерить фактическую толщину подготовленной и покрытой фанеры. Если она отличается от 15 мм, изменить параметр `plywood` и пересчитать образец; готовые STL рассчитаны на номинальные 15 мм.
2. Напечатать образец посадки. Это три значения общего припуска к толщине фанеры: 0,15 / 0,30 / 0,45 мм, а не припуск с каждой стороны. Универсального значения для всех принтеров нет.
3. По подходящему пазу изменить `clearance`. Напечатать один L-соединитель и собрать угол на двух обрезках фанеры. Проверить посадку, отсутствие трещин, люфт и удержание при длительной пробной нагрузке в предполагаемом направлении. Короткий образец не заменяет эту проверку: длинный паз может держать иначе.
4. После результата уточнить диаметр, фиксацию от сползания и режим печати. Затем согласовать раскрой, петли и крепёж. Не распиливать всю фанеру по визуальному эскизу.

Начальный материал для опытного соединителя — PETG. Для первой пробы: слой 0,2 мм, 6 периметров, 40% заполнения; температура — по профилю конкретного филамента и принтера. Соединитель в STL уже расположен сплошной круглой лицевой стороной на столе, пазами вверх. Это исходные настройки эксперимента, а не подтверждение несущей способности.

Геометрия STL проверена программно: замкнутые поверхности, одно связное тело у каждого файла, положительный объём, заданные габариты. Физическая печать, испытания нагрузки и проверка в OpenSCAD не выполнялись. Допустимая нагрузка на полки пока не определена. Параметры источника позволяют проектировать варианты; изменение габаритов потребует повторной проверки зазоров, петель и сборки.

## Справочные источники

- Прототип принципа модульной фанерной мебели: https://www.printables.com/model/185020-modular-and-re-usable-plywood-furniture-connectors
- OpenSCAD, описание возможностей: https://openscad.org/about.html
- Prusa: допуски и необходимость пробных печатей: https://help.prusa3d.com/article/modeling-with-3d-printing-in-mind_164135
- Prusa: PETG для механических деталей: https://help.prusa3d.com/article/petg_2059
