padington/cambusa-cabinet/history/README.md

# Ранние версии и исходники

Эскизы v01–v14 сохранены как исторические снимки. Статус и выводы относятся к указанной версии. Для текущей сборки используйте команды из [главного README](../README.md).

| Версия | Снимок | Статус |
|---|---|---|
| `round-v01` | [Узкая тумба с круглыми соединителями](outputs/round-cabinet/) | Исходный эскиз и образцы посадки |
| `visual-sketches-v01` | [Ранние скосы и сферические узлы](outputs/early-visual-sketches/) | Иллюстрации формы, без производственной геометрии |
| `six-concepts-v01` | [Шесть вариантов формы](outputs/cabinet-six-concepts/) | Изображения для выбора направления |
| `engineering-v01` | [Смещённые ячейки и ступень — узлы с винтами](outputs/cabinet-03-04-engineering-v1/) | Исследование конструкции и пробного узла |
| `bayonet-v02` | [Шаровой узел с поворотным ключом](outputs/sphere-bayonet-v02/) | Геометрический прототип, физически не испытан |
| `boltfree-v03` | [Шаровые узлы без металлических стяжек корпуса](outputs/boltfree-cabinet-v03/) | Архив отвергнутого направления с крупными шарами |
| `mobile-v04` | [Колёса: скосы, алюминий или клинья](outputs/mobile-cabinet-options-v04/) | Три эскизных варианта; прежние допущения о сборке не действуют |
| `cambusa-v05` | [Лотки, ящики и полная перфорация боковины](outputs/cambusa-pegboard-v05/) | Эскиз; схема предварительной сборки на стороне отменена |
| `order-v06` | [Комплект отдельных деталей для расчёта](outputs/order-preparation-v06/) | Сметные контуры; присадка не выпущена |
| `cambusa-v07` | [Высокая Cambusa: закрытый корпус и две дверцы](outputs/cambusa-direction-v07/) | Отклонён: растянутый корпус; колёса отменены |
| `cambusa-v08` | [Cambusa: компактный корпус на высоком основании, без колёс](outputs/cambusa-proportions-v08/) | Исправленный эскиз; крепления основания ещё не выбраны |
| `cambusa-v15` | [Cambusa — рамочные двери с полками и врезными петлями](../outputs/cambusa-doors-v15/) | Проверочный эскиз дверей. Крайние положения проверены по дереву; ход петли и нагрузка требуют проверки. |
| `cambusa-v16` | [Cambusa — алюминиевый каркас во всю высоту](../outputs/cambusa-frame-v16/) | Геометрический эскиз. Соединения и устойчивость требуют проверки. |

## Где искать

- [work/](work/) содержит редактируемые Python, JavaScript, HTML, исходные JSON и исследования.
- [outputs/](outputs/) содержит исторические GLB, STL, OpenSCAD, DXF, карты листов, чертежи и отчёты.
- [previews/](previews/) содержит сохранённые интерактивные виды.
- [Манифест](manifest.json) перечисляет файлы снимка и контрольные суммы SHA-256.

Старые скрипты могут ссылаться на зависимости той итерации, браузерный рантайм и файлы в `input-materials/`. Они сохранены для чтения и воспроизведения с соответствующими входами. Для `render_reference_designs.py` распакуйте `work/reference-design-meshes.json.gz` в `work/reference-design-meshes.json`. Актуальная сборка v16 запускается из корня репозитория через `scripts/build.py`.

Присланные фотографии собраны в [фотогалерее](../references/photos/README.md). Для отдельных файлов CAD поставщиков указаны [ссылки на источники](../references/README.md).
