padington/cambusa-cabinet/history/outputs/boltfree-pilot-v03/READ-ME-RU.txt

ТУМБА НА ПЕЧАТНЫХ ШАРОВЫХ УЗЛАХ — ВЕРСИЯ 03
3 ноября 2026

РЕЗУЛЬТАТ
Переработаны оба корпуса: 03 «Смещённые ячейки» и 04 «Ступень».
Все соединения полок, перегородок, боковин и задней стенки спроектированы
без металлических винтов, болтов, гаек, мебельных стяжек и клея.
Используются деревянные посадочные пазы, печатные шары с поворотными ключами
и два печатных поворотных стопора задника.

СОГЛАСОВАННОЕ ИСКЛЮЧЕНИЕ
Пользователь разрешил обычные готовые мебельные петли со скрытыми винтами.
Мастер заранее устанавливает и регулирует петли на дверцах и корпусе.
При домашней сборке дверцы пристёгиваются без инструмента. Поэтому вся вещь
не называется полностью безметаллической: ноль винтов и болтов относится
именно к корпусу. Точный комплект петель и присадку ещё необходимо согласовать.

СТАТУС
Геометрический макет и набор опытных образцов. Полный производственный
комплект пока не выпущен. Физического образца, подтверждённой нагрузки,
испытаний пластика, реальной сборки и точной кинематики мебельных петель нет.

РАЗМЕРЫ
Номинальный габарит 1000 × 1200 × 350 мм. Фактический габарит текущих сеток
около 998 × 1200 × 348,5 мм: некоторые крайние точки удалены пазами и скруглениями.
Основная фанера 18 мм, задник 6 мм, шар Ø90 мм.
Глубина основной прямой части полок — 215 мм. У боковин полки выдвинуты вперёд
для соединения с наклонным контуром рам. Крупные книги и альбомы по глубине
могут выступать; не путать общую глубину тумбы 350 мм с глубиной полки.
Положение полок по высоте: 170, 500, 830, 1155 мм.

СОСТАВ
03: 12 деревянных деталей, 20 шаровых корпусов, 20 печатных поворотных ключей,
    2 печатных стопора задника. 54 геометрические детали без петель.
04: 12 деревянных деталей, 15 шаровых корпусов, 19 печатных поворотных ключей,
    2 печатных стопора задника. 48 геометрических деталей без петель.
В пересечениях четырёх панелей варианта 04 один шар содержит два ключа.
Число уникальных типов печати меньше числа установленных деталей; в папках
вариантов каждая деталь названа по её месту в корпусе.

ЧТО ИЗМЕНЕНО
1. Боковые стяжки М6 убраны. Полки получили передние выступы, которыми входят
   в шаровые узлы у боковых рам. Сами рамы остались плоскими деталями с наклонным
   передним контуром и цельными ножками.
2. Внутренние винтовые узлы заменены печатными шаром и ключом без резьбы.
3. Задник вставляется сверху в открытые пазы рам, затем запирается двумя
   поворотными стопорами. Стопоры удерживаются выступами в обработанных пазах
   деревянной рамы; крепёж для них не нужен.
4. Задние шары отодвинуты от задника, чтобы его можно было установить.
5. Дверцы расположены по переднему контуру соответствующих рам. Их углы
   получили округлые вырезы, рассчитанные с учётом движения возле шаров.
   В макете принят угол открывания 86°.

ПРЕДЛОЖЕННЫЙ ПОРЯДОК СБОРКИ
Это порядок с проверенной геометрией, не инструкция по уже испытанному изделию.
1. На мягкой ровной поверхности собрать центральную решётку: нижняя полка,
   первая перегородка, следующая полка и так далее. Следующая полка замыкает
   паз над перегородкой; переставить перегородку после замыкания нельзя.
   При раскладке на задних кромках использовать упаковочные опоры около 60 мм,
   чтобы более глубокие боковые рамы не упёрлись в поверхность.
2. Надвинуть боковины на торцы полок по пазам.
3. Надеть передние шаровые узлы без ключей, затем вставить каждый ключ,
   повернуть на 90° и слегка вытянуть в стопорный паз. Разборка — с нажатием
   ключа примерно на 0,8 мм и обратным поворотом.
4. Поддерживая корпус, открыть доступ сзади и установить задние шаровые узлы.
   Для переворота/подъёма пока предусмотрен помощник. Удобство и безопасность
   сборки одним человеком не подтверждены.
5. Вставить задник сверху. До задника должны быть установлены задние шары.
6. Вставить верхние стопоры задника, нажать примерно на 2 мм, повернуть на 90°
   и приподнять в стопорный паз. Их нависающие лапки не дают заднику подняться.
7. Пристегнуть заранее подготовленные дверцы к ответным планкам петель.
   Дома сверлить, пилить, шлифовать и регулировать винты не предполагается.

ПРОВЕРКИ В МОДЕЛИ
• Все 54/48 деталей замкнуты и представляют по одному связанному объёму.
• Проверены все 1431 пары деталей в 03 и 1128 пар в 04. Непредусмотренных
  объёмных пересечений в собранном положении нет.
• Проверены 1337 положений сборки 03 и 1203 положения сборки 04: панели,
  пустые шары, установка и поворот ключей, вставка задника, установка стопоров.
  В последних миллиметрах хода проверки сгущены. Найденных пересечений нет.
  Это дискретные геометрические проверки; перекосы, деформации и непрерывное
  движение между всеми положениями не моделировались.
• После запирания попытки сдвинуть каждый шар на 4 мм вдоль направления снятия
  упираются в деревянные детали/ключ. Это проверка формы, не усилия удержания.
• У обоих стопоров проверены запреты: вытащить вверх на 2 мм или повернуть
  на 30° без нажатия. Подъём задника на 4 мм упирается в стопоры. Все эти
  намеренно запрещённые движения дают положительное геометрическое препятствие.
• Каждая дверца проверена в 44 положениях от 0 до 86° вокруг условной оси.
  В этих положениях столкновений с корпусом нет. Коммерческая петля имеет
  собственную многозвенную кинематику, поэтому эта проверка не подтверждает
  окончательную совместимость конкретной петли.

ФУРНИТУРА ДВЕРЕЙ
Рабочий кандидат — предварительно установленные CLIP top/CLIP top BLUMOTION
для вкладных фасадов, с ограничением открывания до 86°. В каталоге Blum для
110° петель есть ограничитель 70T3553 на 86°. Совместимость точной петли,
монтажной планки, крепежа и ограничителя должен подтвердить цех.
В модели предусмотрены чашки Ø35 мм глубиной 13 мм, но не выпущены окончательные
сверловки ответных планок и крепёжных отверстий. До полного раскроя обязательны
проверка CAD выбранной петли или реальная примерка на боковине/фасаде.
https://www.blum.com/gb/en/products/hingesystems/clip-top/assembly/
https://ea.blum.com/en/opening-angle-stops-for-110-and-107-hinges/

ОПЫТНЫЕ ОБРАЗЦЫ
pilot-samples/01-side-corner — угол: боковая рама, выступ полки, шар и ключ.
pilot-samples/02-back-stop — верх рамы, кусок задника и поворотный стопор.
pilot-samples/03-inner-T — внутренний Т-узел с одной перегородкой.
pilot-samples/04-inner-X — узел варианта 04 с двумя перегородками и двумя ключами.
Разумно начать с 01 и 02, затем проверить Т и X до заказа всей партии.
Образцы вырезаны из актуальных моделей корпуса; их собранные положения
проверены на пересечения. Использовать файлы этой версии 03, а не старые
винтовые модели версии 01 или отдельный ранний узел версии 02.

STL с суффиксом -print-mm — только печатные детали, перемещённые на уровень
стола. Это не рекомендация окончательной ориентации печати: её выбирает
печатник с учётом прочности и удаления поддержек/порошка из внутренних каналов.
STL с -assembly-mm — детали в общей системе координат образца. Деревянные
детали фрезеровать из настоящей фанеры, а не печатать для проверки посадки.
sample-assembled.glb — образец в сборе. Все STL заданы в миллиметрах,
GLB — в метрах согласно формату.

ДО ПОЛНОГО ПРОИЗВОДСТВА
• Измерить фактическую толщину готовой фанеры и скорректировать посадки.
  Текущие пазы 18,6 мм рассчитаны под номинальные 18 мм и ещё не испытаны.
• Согласовать печать, очистку внутренних каналов, направления слоёв и материал.
• Проверить усилия сборки/разборки руками и доступ пальцев у каждого типа узла.
• Испытать срез и изгиб ключей, разрушение корпуса, вырыв древесины вокруг окон,
  износ байонетных дорожек, случайное отпирание в разных ориентациях и ползучесть
  пластика под длительным нагружением. Допустимая нагрузка под книги НЕ назначена.
• Собрать целый опытный корпус и проверить жёсткость задника, качание и устойчивость.
• Проверить точные петли, крепёж, ограничители и движение настоящей дверцы.
• Подготовить производственные чертежи/развёртки под инструмент выбранного цеха.
  3D-сетки STL/GLB в этом архиве не выдаются за готовую управляющую программу ЧПУ.
• Крепление от опрокидывания к стене — отдельная монтажная работа с подходящим
  крепежом. Его установка не входит в домашнюю сборку корпуса без инструмента.

ФАЙЛЫ КОРПУСОВ
assembled.png — актуальный вид обоих вариантов.
exploded.png — разнесённые детали; это не одновременное направление их установки.
open.png — условное открывание фасадов на 86°.
back-stop-detail.png — стопор задника крупно, оранжевый для пояснения.
variant-03 / variant-04 — GLB сборки и разнесённого вида, отдельные STL,
parts.csv, параметры и подробный отчёт проверок.
В GLB корпуса металлическая фурнитура петель не представлена точной моделью.
Цвет условный, по пользовательскому требованию взято тёмное дерево.
