padington/cambusa-cabinet/history/outputs/cambusa-direction-v07/READ-ME-RU.txt

CAMBUSA — ВЫСОКАЯ ВЕРСИЯ 07
3 ноября 2026. Эскиз, не выпуск в производство.

АКТУАЛЬНЫЕ РЕШЕНИЯ ПОЛЬЗОВАТЕЛЯ
Ширина 1000, высота с колёсами 1800, глубина 500 мм.
Высота 1200 мм сохранена в предыдущих версиях, но больше не является текущей.
Разрешены ключ и отвёртка. Заказываются отдельные подготовленные детали;
пользователь самостоятельно собирает корпус, основание и короба ящиков.
Сверление, пиление и подгонка дома не предполагаются.

ИДЕЯ ИЗ CAMBUSA FLY
Деревянный закрытый корпус, две высокие дверцы с хранением, внутренние
полки и ящики, отдельное тёмное металлическое основание. Исходный референс:
https://www.riva1920.it/it/prodotti/mobili-zona-giorno/mobili-contenitori/cambusa-fly
Это наша адаптация под заказ отдельных деталей. Материалы, механизм дверей,
нагрузки и фабричные чертежи Riva1920 на эту конструкцию не переносятся.

НАША КОМПОНОВКА
Тёмная фанера, две дверцы и шесть неглубоких лотков на их внутренней стороне.
Два внутренних ящика внизу справа. Полки открыты при раскрытых дверях.
Тонкий чёрный профиль только в низком основании. Двенадцать отдельных
отрезков, без сварной рамы и без предварительной сборки за пользователя.
На всю правую деревянную боковину — 270 отверстий Ø12 с шагом 50 мм.
В отдельных нижних зонах за отверстиями находятся направляющие и ящики:
возможность применения навесов там должна быть отдельно ограничена.
Габариты боковины: 480 × 1544 × 18 мм; глубина корпуса вместе с дверями 500.
Колёса Ø75 / монтажная высота 100 показаны условно. Точный артикул не выбран.
Добавлены четыре отдельные условные пластины-переходника под колёса;
отверстия, способ фиксации и допустимая нагрузка пока не определены.

ЧТО В ФАЙЛАХ
closed.glb, open.glb, exploded.glb — геометрия в метрах, Y вверх.
PNG — изображения той же геометрии; книги добавлены только как масштаб.
CSV — предварительные габариты 50 фанерных деталей, 12 отрезков профиля
и четырёх пластин. Это не конечный раскрой и не список для покупки.
geometry-checks.json — объёмные и геометрические проверки.

ВАЖНОЕ ИЗМЕНЕНИЕ ЯЩИКОВ
Для лотков на обеих дверцах оставлено место спереди. Поэтому предварительно
взята направляющая номиналом 350 мм, а глубина короба 340 мм вместо 390.
Ширина проёма 473 мм, наружная ширина короба 455, стенки 12, внутренняя
ширина 431 мм. Формулу, вырезы, фиксаторы и днище нужно сверить с точным
артикулом направляющей до выпуска чертежей присадки.

ПРОВЕРКА ДВИЖЕНИЯ
В упрощённой геометрии нет пересечений крупных деталей в закрытом виде,
в проверенных положениях дверей от 0 до 155 градусов и при выдвижении
каждого ящика до 280 мм с дверями, открытыми на 145 градусов.
Это проверки отдельных положений с идеальной осью вращения; они не
подтверждают траекторию реальных многозвенных петель и полный ход механизма.
Перед выдвижением ящика в просмотре дверцы автоматически открываются.
Такое ограничение изображения не является механической блокировкой.
Разнесённый вид показывает состав, но не доказывает монтажную последовательность.

ДО ПОЛНОГО ЗАКАЗА
Нужно выбрать точные крепления основания и корпуса, петли и направляющие,
назначить количество петель под массу дверей с лотками, подготовить всю
присадку и проверить пробные узлы. Для высоты 1800 мм на колёсах отдельно
проверяются устойчивость с открытыми дверями и нагруженным ящиком, фиксация
при эксплуатации и нагрузка. Тормоз колеса сам по себе не предотвращает
опрокидывание. Пределы нагрузки пока не назначены.
3D-печать в несущей конструкции этой версии не требуется.
