padington/cambusa-cabinet/history/outputs/cambusa-pegboard-v05/READ-ME-RU.txt

ВНИМАНИЕ: СПОСОБ СБОРКИ ВЕРСИИ 05 ОТМЕНЁН ПОЛЬЗОВАТЕЛЕМ.
Тумба должна собираться пользователем дома из отдельных заказанных деталей,
без готового каркаса и готовых собранных коробов. Исходная цель — без инструментов.
Версия 05 остаётся эскизом формы; прежняя схема с участием мастера не согласована.

ТУМБА С ПЕРФОРИРОВАННОЙ БОКОВИНОЙ И ЯЩИКАМИ — ВЕРСИЯ 05
3 ноября 2026

СОГЛАСОВАНО
Корпус: ширина 1000, высота 1200 с колёсами, глубина 500 мм.
Последний выбор глубины пользователя — 50 см; предварительные 55 см отменены.
Тёмное дерево, алюминиевый каркас, готовые колёса, полки под книги,
дверца и открытые ниши, перфорация на ВСЕЙ правой боковине.
Шарообразных узлов нет. Для корпуса 3D-печать не требуется.

ЧТО ИЗМЕНИЛОСЬ ПО ИДЕЕ CAMBUSA FLY
Два небольших деревянных ящика собраны в блок внизу справа.
Слева одна высокая дверца с двумя неглубокими внутренними лотками.
Выше ящиков и дверцы остаются открытые полки.
Тонкая тёмная металлическая рама сочетается с тёмными фасадами.
Это адаптация компоновки, а не копия Riva и не их конструктивные чертежи.
Настоящая Cambusa Fly выше, имеет металлическую подставку без наших колёс
и другие материалы и узлы. Не переносить её характеристики на наш проект.

ДВА ВАРИАНТА
outside-closed.glb / outside-open.glb — ящики доступны прямо с фасада.
inside-closed.glb / inside-open.glb — два ящика за отдельной правой дверцей.
Внутренние ящики ближе к идее Cambusa, наружные удобнее для частого доступа.
Лотки только на левой дверце: они не перекрывают выдвижение правых ящиков.
GLB в метрах, Y вверх. Декоративные книги в GLB не включены.
Навесная полка и крючки включены; в просмотре их можно скрыть.

ЯЩИКИ
Номинальная длина кандидата-направляющей — 400 мм.
Пример семейства: скрытые направляющие TANDEM 560H с фиксаторами и доводчиком.
Короб в модели: наружная ширина 417, наружная глубина 390 мм,
стенки 12 мм, дно 9 мм. При этих стенках внутренняя ширина около 393,
внутренняя глубина около 366 мм. Это предварительные габариты коробов.
Высота стенок 100 мм; фасады 136 мм; в блоке два ящика.
Выдвижение в демонстрации ограничено 280 мм для понятного показа.
Это не обещание реального хода выбранного направляющего механизма.
Для направляющих нужны точные сверления, вырезы и фиксаторы по инструкции
выбранного артикула; в этой модели они не проработаны.
Мастер делает и собирает сами короба, ставит направляющие на винты,
крепит фиксаторы и регулирует фасады. Дома устанавливаются готовые ящики.
Инструменты нужны для изготовления и установки фурнитуры в мастерской.

ПЕТЛИ И ДВЕРЦЫ
Петли заранее ставит мастер; дома дверцы пристёгиваются руками.
Для внутренних ящиков нужна дверь, которая после открытия освобождает
весь путь ящика. Кандидат — подходящая петля без выступания двери в проём,
например вариант CLIP top 155° zero protrusion при совместимой схеме наложения.
Точный артикул, площадка, наложение и траектория НЕ выбраны и НЕ проверены.
Нельзя ставить произвольную петлю 110° и считать, что ящики точно пройдут.
Условное открывание в просмотре — вокруг одной оси, до 110°.
В просмотре перед выдвижением внутреннего ящика дверцы открываются минимум
на 95°. Это защита изображения от пересечения, не механическая блокировка.
Одновременно показано выдвижение только одного ящика.

ПЕРФОРИРОВАННАЯ БОКОВИНА
Одна панель из фанеры 18 мм, габарит 500 × 1096 мм, от высоты 104 до 1200 мм.
Панель занимает наружную правую плоскость x=982..1000 мм.
Номинальные отверстия Ø12 мм, шаг 50 мм, 9 колонок и 21 ряд = 189 отверстий.
Координаты центров приложены в pegboard-hole-centres-mm.csv; высоты от пола.
Сетка предварительная и не заявлена как совместимая с IKEA или другим брендом.
За панелью оставлена зона для концов штырей; правые промежуточные боковые
профили убраны из этой зоны. Панель крепится к раме в мастерской.
Крепления панели, допуски для штырей, защита от выпадения и допустимая
нагрузка на отверстия ещё требуют пробного образца.
Показана навесная полка и два крючка. Их крепёж — эскиз; он не готов к печати.
Нельзя нагружать эти навесы книгами, пока узел не испытан.
Навесная полка выступает за корпус на 135 мм: с ней общая ширина около
1135 мм, без навесов — 1000 мм. Ручки выступают вперёд на 7 мм.

ИЗГОТОВЛЕНИЕ И СБОРКА
1. Согласовать точную фурнитуру и её наличие с исполнителем.
2. Испытать один узел подвеса и один ящик в пробном коробе.
3. Мастерская режет профиль, фрезерует фанеру, шлифует кромки и отделывает.
4. Мастер собирает раму, задник, основание и крепления колёс, устанавливает
   полки/перегородки, направляющие и ответные части петель, регулирует корпус.
5. Дома поставить готовые ящики, пристегнуть дверцы, добавить лёгкие навесы.
Так сохраняется сборка без инструментов дома за счёт заранее подготовленных
крупных узлов. Полностью разобранный алюминиевый каркас руками не собирается:
в нём остаются скрытые винтовые соединения, затянутые мастерской.

МАТЕРИАЛЫ
Фанера берёзовая 18 мм — видимые панели, полки, перегородки, фасады, pegboard.
Фанера 12 мм — короба ящиков; 9 мм — днища и дверные лотки; 6 мм — задник.
Алюминиевый профиль условного внешнего размера 30 × 30 мм.
Четыре готовых колеса Ø65 мм с тормозами; точный артикул ещё не подобран.
Общий расход листов для этой версии ещё не оптимизирован. Прежний раскрой
варианта глубиной 350 мм к новой модели глубиной 500 мм не применять.

ПРОВЕРКА И СТАТУС
Все отдельные сетки замкнуты. Проверены крупные панели в закрытом положении.
Приложены отдельные результаты дискретной проверки геометрических зазоров
при идеальном открывании дверей и прямом выдвижении каждого ящика.
Это не проверка реальных петель, направляющих, монтажа или силовых деформаций.
Не рассчитаны основание под колёсами, прочность профиля и его стыков,
усилие на pegboard, допустимая масса книг и устойчивость с открытым ящиком.
Нужны крепление от опрокидывания для стоянки и проверка тормозов.
Тормоз не заменяет защиту от опрокидывания. Перемещать с закрытыми ящиками
и дверцами, снять тяжёлые книги и навесное содержимое.
По этим файлам пока нельзя заказывать всю партию: это модель компоновки.

ПЕРВОИСТОЧНИКИ
Cambusa Fly: описание и фотографии, просмотренные на сайте Riva1920.
https://www.riva1920.it/it/prodotti/mobili-zona-giorno/mobili-contenitori/cambusa-fly
Фотография открытого шкафа:
https://www.riva1920.it/components/com_riva/files/product_gallery/76/cambusa-fly-1753679982.jpg
TANDEM: установка и фиксаторы
https://www.blum.com/eu/en/products/runnersystems/tandem/assembly/
Габариты и правила планирования TANDEM 560H:
https://publications.blum.com/2022/catalogue/en/451/
Петли CLIP top, включая 155° zero protrusion:
https://d2.blum.com/services/BEC003/concealedhinges_ep_dok_bus_%24sen-us_%24aof_%24v18.pdf

Закупки, заказы и сообщения исполнителям не выполнялись.
