padington/cambusa-cabinet/history/outputs/cambusa-proportions-v08/READ-ME-RU.txt

CAMBUSA — ПРОПОРЦИИ И ОСНОВАНИЕ, ВЕРСИЯ 08
3 ноября 2026. Эскиз для согласования, не для полного заказа.

ИСПРАВЛЕНИЕ ПО ЗАМЕЧАНИЮ ПОЛЬЗОВАТЕЛЯ
Предыдущая версия 07 чрезмерно растянула деревянный корпус при увеличении
общей высоты. Пользователь попросил сохранить пропорции Cambusa Fly
и убрать колёса. Версия 07 и её Git-тег сохранены без изменений.

НОВАЯ КОМПОЗИЦИЯ
Габарит: ширина 1000, общая высота 1800, глубина 500 мм.
Деревянный корпус: 1000 × 1000 × 500 мм, начинается на высоте 800 мм.
Высокое тонкое основание: 800 мм вместе с условными подпятниками 4 мм.
Колёс, площадок колёс и переходных пластин нет.
В основании нет нижней передней перекладины: передняя часть открыта.
Пропорции компактного верхнего объёма и высокого основания взяты за основу
по фотореференсу. Разбиение 1000 + 800 мм назначено для нашего эскиза:
это не утверждение об отдельных заводских размерах корпуса и основания Riva.
Исходный референс:
https://www.riva1920.it/it/prodotti/mobili-zona-giorno/mobili-contenitori/cambusa-fly

ВНУТРИ
Две дверцы высотой 992 мм, по три неглубоких лотка на каждой.
Два внутренних ящика в нижней правой секции. Две полки слева, две справа.
Правую деревянную боковину занимает сетка 171 отверстия Ø12 с шагом 50 мм.
Габарит боковины 480 × 964 × 18 мм. Отверстия в зоне направляющих и петель
не означают свободное место для любого навеса — такие зоны уточняются.
Ящики предварительно: наружная ширина 455, глубина 340 мм, стенки 12 мм.
Кандидат-направляющая номиналом 350 мм; точный артикул и присадка не выбраны.

САМОСТОЯТЕЛЬНАЯ СБОРКА
Прежнее решение пользователя сохраняется: ключ и отвёртка допустимы.
Весь корпус, основание и короба собирает пользователь из отдельных
заказанных деталей. Отверстия и пазы должны быть подготовлены заранее.
Основание показано как 11 отдельных отрезков профиля 30 × 30 мм, всего
7,164 м без запаса. Сварного собранного основания здесь не предполагается.
Форма профиля, угловые крепления, защита от перекоса, крепление к корпусу
и точные опоры требуют отдельной проработки. Геометрия не доказывает
жёсткость высокого разборного основания и устойчивость открытого шкафа.

ФАЙЛЫ И ПРОВЕРКИ
closed/open/exploded.glb — модели в метрах, Y вверх; PNG той же геометрии.
CSV — предварительные габариты 48 фанерных деталей и 11 отрезков профиля.
Присадка под крепления, узлы коробов, петли и направляющие не выпущены.
geometry-checks.json — результаты проверки объёмов, пересечений крупных
деталей и отдельных положений идеального движения. Пересечений в этих
проверках не обнаружено. Реальные многозвенные петли и силовая работа
соединений не моделировались. Предельная нагрузка не назначена.
При выдвижении ящика в просмотре дверцы раскрываются минимум на 145°;
это ограничение изображения, не механическая блокировка.
