padington/cambusa-cabinet/history/outputs/mobile-cabinet-options-v04/READ-ME-RU.txt

ТУМБА НА КОЛЁСАХ — ТРИ ВАРИАНТА БЕЗ ШАРОВ, ВЕРСИЯ 04
Дата: 3 ноября 2026

Это модели для выбора формы. Они заменяют шарообразные узлы в эскизе,
но ещё не являются проверенным комплектом для производства.

ОБЩЕЕ
Номинальные габариты: ширина 1000, общая высота 1200, глубина 350 мм.
В высоту входят колёса с условной монтажной высотой 104 мм.
Тёмная отделка условная; цвет стола по снимкам точно не определён.
Показаны четыре готовых поворотных колеса Ø65 мм с тормозными педалями.
Модель колеса не соответствует выбранному артикулу. Требуется подобрать
настоящие колёса, крепёж, усиление основания и доступ к тормозам.
Крепления колёс и петель устанавливает мастер до передачи деталей.
Ничего из металлической ходовой части печатать не предлагается.

ФАЙЛЫ
clean.glb — Скошенный корпус.
aluminium.glb — Тонкий алюминий.
wedge.glb — Рамы и плоские клинья.
GLB экспортирован в метрах, ось Y направлена вверх по стандарту glTF.
В интерактивном просмотре есть вращение, условное открывание дверец,
разнесение деталей и выбор варианта. Это иллюстрация движения,
не кинематическая проверка реальных многозвенных петель.
Книги в просмотре и PNG — условный масштаб; в GLB декор не включён.

1. СКОШЕННЫЙ КОРПУС
Боковины из фанеры 18 мм. Нижняя часть передней кромки вертикальна,
чтобы можно было использовать обычные мебельные петли; сверху контур
отступает назад, повторяя идею скоса из референсов стола.
Четыре горизонтальные панели, три отдельные центральные перегородки,
высокая левая дверца, нижняя правая дверца, открытые ниши и задник.
Чистая ширина половины полки около 473 мм; глубина горизонтальных панелей
318 мм, верхней панели — 270 мм. Реальная полезная глубина зависит от отделки
и выбранной фурнитуры. Запас под книги ещё требуется рассчитать и испытать.

Направление соединения: готовая скрытая мебельная защёлка, установленная
в мастерской, например OVVO V-1230R для материала от 15 мм.
Производитель подтверждает сборку системы без инструментов, винтов и клея.
В этой модели корпуса нет выбранной расстановки защёлок, их точной геометрии
или фрезеровок. Совместимость всех узлов и порядок сборки ещё не проверены.
Нужны специальный профиль фрезы, пробное соединение и подтверждение наличия
самой фурнитуры у исполнителя. Наличие OVVO в Санкт-Петербурге не установлено.
Для корпуса не требуется 3D-печать. Разборность — только с выбранной
разъёмной модификацией; не предполагается, что любая защёлка разборная.

ФАНЕРА И РАСКРОЙ ДЛЯ ЭТОГО ВАРИАНТА
Два листа берёзовой фанеры ФК 1525 × 1525 × 18 мм для 11 основных деталей.
Один отдельный лист 1525 × 1525 × 6 мм либо подходящий остаток для задника:
прямоугольная заготовка 964 × 1060 мм.
Контрольная прямоугольная раскладка приложена: cut-plan.png и JSON.
Отступ от края 10 мм, промежутки между заготовками 6 мм, поворот заготовок
при упаковке не разрешён. Основная ось текстуры боковин, дверей и перегородок
в эскизе раскроя направлена вдоль горизонтальной оси листа; полок — по ширине.
Ориентацию наружного шпона надо согласовать с фактическим листом у мастера.
Альтернатива — формат 2440 × 1220 мм. Приложена консервативная раскладка
на двух таких листах; это не доказательство минимально возможного количества.
Два квадратных листа в данном эскизе дают меньшую общую площадь закупки.
Все размеры в раскрое — заготовки для формы, не готовые команды для станка.
После выбора соединений размеры, припуски, пазы и их расположение уточняются.
На два других варианта количество листов автоматически не переносится.

2. ТОНКИЙ АЛЮМИНИЙ
Каркас из условного профиля 30 × 30 мм; в модели показан его внешний габарит,
а не точное поперечное сечение конкретного производителя.
Тёмная фанера — полки, перегородки, нижние боковые вставки и две дверцы.
Узел алюминиевого профиля обычно затягивается винтом: он не становится
безвинтовым от того, что винт скрыт. Здесь мастер привозит уже собранный
жёсткий каркас; дома устанавливаются подготовленные деревянные части.
Крепления этих частей, защита от подъёма и схема монтажа ещё не подобраны.
Для полностью плоской поставки потребуется сборка профиля инструментом
либо отдельная разработка ручных замков. Это компромисс по сравнению с
первоначальным требованием полностью собрать весь корпус руками.
В референсе Cheesign был алюминиевый каркас и фанерная перфорация:
https://www.instagram.com/p/DdYVaM4irWC/
У Jandin в ранее просмотренной публикации DYUIz5EFyHo были алюминиевые полки
и круглая металлическая стойка; это не доказательство алюминиевого T-профиля.
Публикация DUDbeApl1VM — сосновые стойки, фанерные ящики и мебель на колёсах.

3. РАМЫ И ПЛОСКИЕ КЛИНЬЯ
Ступенчатая композиция: левая рама ниже правой, открытые боковые окна,
полки с выступающими концами, небольшие плоские клинья вместо шаров.
Показанные клинья — указание на способ соединения, без окончательно
проработанных ответных окон, натяга и фиксации от выпадения.
Руками ли удастся посадить узел с нужным преднатягом, ещё неизвестно;
потребность в киянке нельзя исключить до пробного узла. Вариант пока не
отвечает доказанно требованию сборки без инструментов.
Для выбора внешнего вида он полезен; для первого изготовления сложнее №1.

ПРОВЕРКИ И ОГРАНИЧЕНИЯ
Все экспортированные сетки замкнуты. Все три габарита проверены.
У вариантов 1 и 2 нет статических пересечений крупных панелей и профилей
в закрытом положении. Вариант 3 на стыках клиньев намеренно схематичный.
Пути монтажа, работа фурнитуры, гибкость, прочность, ползучесть, устойчивость
на колёсах и предельная масса книг не проверены; грузоподъёмность не назначена.
Не следует заказывать полную партию по этим GLB или эскизам раскроя.

КОЛЁСА И УСТОЙЧИВОСТЬ
Тормоза должны блокировать качение и поворот. Они не предотвращают
опрокидывание высокой неглубокой тумбы. Для стоянки у стены нужен съёмный
страховочный упор/ремень с креплением к стене; его ставит мастер инструментом.
Перед перемещением снять тяжёлые книги и декор, закрыть дверцы.
Для свободно стоящей и постоянно перемещаемой мебели стоит увеличить
глубину базы; размеры 350 мм пока сохранены из исходного задания.
Колёса подбираются по полной массе с запасом и с учётом возможной
неравномерной нагрузки, а не простым сложением четырёх паспортных чисел.

ИСТОЧНИКИ
Системы OVVO и их требования к обработке:
https://ovvotech.com/
https://ovvotech.com/faqs/
https://ovvotech.com/furniture-connector-types/milling-connectors/
Профиль 30 × 30 и стандартный винтовой узел item:
https://www.item24.com/en-cz/profile-6-30x30-light-natural-45107
https://www.item24.com/en-cz/standard-fastening-set-6-one-sided-71618
Размеры листов и толщина фанеры у производителя:
https://www.sveza.com/products/sveza-fk/
Как выбирать грузоподъёмность колёс:
https://www.blickle.us/en-us/guide/load-capacity
Защита мебели от опрокидывания:
https://www.cpsc.gov/Safety-Education/Safety-Education-Centers/AnchorItgov

С исполнителями никто не связывался. Цены и наличие не запрашивались.
