padington/cambusa-cabinet/history/outputs/sphere-bayonet-v02/READ-ME-RU.txt

ШАРОВОЙ УЗЕЛ БЕЗ БОЛТОВ — ПЕРВЫЙ ГЕОМЕТРИЧЕСКИЙ ПРОТОТИП
Версия 02, 3 ноября 2026.

РЕЗУЛЬТАТ
Вместо нескольких винтов — две печатные детали:
1. Корпус шара с посадочными пазами под две панели.
2. Один поворотный ключ с гладким стержнем и двумя выступами.
Металлического крепежа, резьбы и наружных барашков в этом узле нет.

Это концепция для одного внутреннего Т-образного соединения. Она ещё не
распространена на весь корпус тумбы: угловые узлы, другие направления панелей,
дверцы и задник потребуют отдельной компоновки и проверки.

КАК УСТРОЕНО
• Нижний торец перегородки садится на 6 мм в деревянный паз полки.
• Сфера надвигается спереди на совпадающие передние кромки панелей.
• Через обе панели и направляющую в сфере проходит один диагональный ключ.
• В отличие от отверстия под диагональное сверление, в каждой деревянной
  панели сделано сквозное окно перпендикулярно её плоскости. Их можно получить
  обычной плоской фрезеровкой: специальное угловое сверление не заложено.
• Два выступа ключа входят в продольные пазы корпуса. После поворота на 90°
  и небольшого вытягивания попадают в углубления стопорного паза.
• Стопорный паз геометрически препятствует вытягиванию и обратному повороту.
  Для разборки сначала нажать ключ примерно на 0,8 мм, затем повернуть обратно
  на 90° и вытащить. Автоматической пружины или защёлки в этой версии НЕТ.
• Головка ключа расположена снизу сбоку и повторяет кривизну шара. По бокам
  головки предусмотрены углубления в корпусе для захвата пальцами.

СМЫСЛ 3D-ПЕЧАТИ
Корпус задаёт взаимное расположение панелей, направляет ключ и содержит
внутренние поворотные дорожки с удерживающими уступами. Это рабочая геометрия
соединения, не декоративная накладка поверх обычных мебельных стяжек.
Ключ удерживает панели от выхода через окна в фанере. Печатный ключ и корпус
нужно испытать на срез, изгиб и длительное нагружение. Паз в фанере задаёт
деревянную опору, но сам по себе не подтверждает прочность всей тумбы.

РАЗМЕРЫ ПЕРВОЙ ВЕРСИИ
• Сфера Ø90 мм. Она крупнее прежних эскизов. Это пробный габарит выбранного
  механизма под фанеру 18 мм, окончательный внешний вид тумбы не утверждён.
• Фанера номинально 18 мм. Пазы корпуса 18,6 мм.
• В полке паз шириной 18,6 мм и глубиной 6,3 мм; перегородка заходит на 6 мм.
• Гладкая часть ключа Ø6 мм. Направляющая в корпусе Ø6,8 мм.
• Окно полки: 21,2 × 8 мм, x=11,4…32,6 мм от плоскости середины перегородки.
• Окно перегородки: 26,2 × 8 мм, z=12,3…38,5 мм от середины толщины полки.
• Оба окна центрированы на расстоянии 20 мм от передней кромки панелей.
  Закругление внутренних углов — R2 мм.
Эти размеры номинальные. Реальную фанеру и покрытие сначала измерить.

ЧТО ПРОВЕРЕНО
Точные объёмные модели корпуса, ключа и обеих деревянных деталей замкнуты;
каждая деталь является одним связанным объёмом.
Непредусмотренных объёмных пересечений в собранном положении нет.
Проверены 17 положений надвигания корпуса, 15 положений вставки ключа,
46 положений его поворота при нажатии и 9 положений посадки в стопорный паз.
В проверенных положениях пересечений нет. Это дискретная геометрическая
проверка, а не непрерывная симуляция, расчёт прочности или физическое испытание.

Отдельно проверены намеренно запрещённые движения: вытягивание ключа на 2 мм
без отпирания и поворот на 30° без нажатия упираются в корпус. Попытки вынуть
панели на 4 мм упираются в ключ. Точные объёмы пересечений — в geometry-checks.json.
При выбранных зазорах первое препятствие со стороны ключа возникает примерно
после 0,5 мм перемещения полки и 0,7 мм перегородки. Это предварительный люфт,
его нужно сопоставить с реальной посадкой в корпусе и пазу. Узел не обещает
безлюфтовую силовую затяжку.

ЧТО ЕЩЁ НУЖНО ПРОВЕРИТЬ НА ОБРАЗЦЕ
1. Возможность напечатать и очистить внутренние каналы без повреждения уступов.
   Технологию, ориентацию и материал согласовать с печатником.
2. Совпадение пазов с реальной толщиной фанеры, отсутствие расслоения у окон.
3. Удобство вставки, поворота, нажатия и извлечения пальцами без инструмента.
4. Износ дорожек и выступов при многократной сборке, возможное заклинивание.
5. Удержание от случайного нажатия/поворота, работа в разных ориентациях.
6. Изгиб и срез ключа, разрушение корпуса и фанеры, ползучесть под длительной
   нагрузкой. Допустимая нагрузка пока НЕ установлена.
7. После этого — другие типы узлов и полный прототип корпуса с задником.

ФАЙЛЫ
mechanism-overview.png — общая схема с собранным узлом и разрезом.
assembled.png, removed.png, section.png — отдельные крупные виды.
assembled.glb — узел в сборе для 3D-просмотра.
key-removed.glb — ключ вынут для просмотра.
section.glb — только поясняющий разрез, не файл для печати.
body-prototype-mm.stl — корпус для обсуждения опытной печати.
key-prototype-mm.stl — ключ для обсуждения опытной печати.
shelf-prototype-mm.stl, divider-prototype-mm.stl — ДЕРЕВЯННЫЕ образцы для
фрезеровки. Не печатать вместо фанеры при проверке реальной посадки.
STL имеют размеры в мм; GLB — в метрах согласно формату.

Оранжевый цвет ключа на схемах нужен для объяснения механизма. Корпус и ключ
могут быть одного цвета. Показаны геометрические модели, физического образца нет.

ИСТОЧНИКИ ОБЩИХ ПРИНЦИПОВ, НЕ ПОДТВЕРЖДЕНИЕ ЭТОГО ПРОТОТИПА
Пример промышленной фиксации поворотом на 90°:
https://southco.com/latches/cam-latches
Общие рекомендации к защёлкам и необходимости проверки материала/ориентации:
https://www.hubs.com/knowledge-base/how-design-snap-fit-joints-3d-printing/
Расчётные нагрузки и испытания других изделий к нашему узлу не применены.
