padington/cambusa-cabinet/TODO.md

# Очередь работ

[Аудит 3D #1](https://github.com/padington/cambusa-cabinet/issues/1) · [Двери 270° #2](https://github.com/padington/cambusa-cabinet/issues/2) · [Пегборд слева #3](https://github.com/padington/cambusa-cabinet/issues/3) · [Хранение #4](https://github.com/padington/cambusa-cabinet/issues/4)

- [ ] Подобрать крепления профилей и проверить жёсткость каркаса. Указать тип паза и поставщика выбранного профиля.
- [ ] Проверить полный ход HES3D-120BL на образце с профилем. Проверить фиксацию дверных полок и устойчивость при открытых нагруженных дверях.
- [ ] Проработать крепление стоек петель, корпуса и задника к раме. Проверить доступ инструмента, допуски и крепление шкафа от опрокидывания.
- [ ] Ящики отложены. Для двух направляющих Blum TANDEM 560H3500B и левого и правого замков T51.1700.04 проверить монтажный CAD. Пересчитать короб и фасад под проход **424 мм** между стойкой и перегородкой. В v15 было 455 мм.
- [ ] Заполнить цены, материалы и обработку по предложениям поставщиков. Проверить обработку на одном образце.
