padington/cambusa-cabinet/history/outputs/joinery-review-v12/ПРИСАДКА.md

# Присадка и новые референсы

В v10 были только заготовки и перфорация. В этом выпуске появился отдельный контрольный ящик с отверстиями Rastex, каналами штоков, отверстиями шкантов, пазами дна, отверстиями задних зацепов и креплением внутреннего фасада. Это отдельный узел, а не производственный комплект шкафа.

## Что открыть

- [Пазы и отверстия ящика](Пазы-и-отверстия-ящика-v12.pdf).
- [3D ящик с обработкой](drawer-drilled.glb) и [разнесённые детали](drawer-exploded.glb).
- [Все координаты и стороны обработки](operations.json).
- [Проверки геометрии и открытые операции](ПРОВЕРКИ.json).
- [Разбор новых фотографий](РЕФЕРЕНСЫ.md).

## Изменения относительно v10

Задние стенки W40 и W46 имеют высоту 97 вместо 110 мм; их нижние торцы подняты на 13 мм. Днища W41 и W47: 436,6 × 318,6 вместо 437 × 322 мм. Дно удерживается тремя пазами; задняя стенка без паза и не мешает задним зацепам. Существующая закупка материала пока не увеличивается: новые контуры меньше прежних, но окончательная раскладка требует синхронизации.

Принятый для образца паз 9,2 × 3 мм рассчитан на фактическое дно 9 мм. Это наша посадка с зазором, её нужно проверить на образце после отделки. Хват внутреннего фасада предлагается фрезеровать сзади у верхнего края, 100 × 14 × 6 мм; покупная ручка для него не требуется.

Ширина отсека LW473 относится к текущему корпусу с фанерой 18 мм. Новый вариант рамочных дверей может изменить ширину отсека; тогда ширина ящика, днища и фасада пересчитывается. Старые файлы не исправляются задним числом.

## Что ещё не выпущено

Четыре наклонных пилота замков на ящик предусмотрены как операция по подлинному шаблону Blum T65.1000.02 и реальным замкам в цеху. Их числовых координат здесь нет. Не выпущены присадка направляющих в корпусе, новые дверные петли и конкретные крепления лотков. Нельзя передавать этот файл как полный комплект для изготовления шкафа.

## Основания размеров

Rastex 15/12: Ø15, глубина 10; канал штока Ø8; ось в 6 от пласти. Для Twister DU319T 20 центр эксцентрика находится в 24 от торца; отверстие под резьбу Ø5 глубиной 9. Это подтверждено отдельными листами Hettich. Привязки по высоте и расстояния между соединениями — наша компоновка.

TANDEM 560H: длина короба NL−10, внутренняя ширина LW−42; утопление дна 12–15. Для задних зацепов Ø6 глубиной 10, 7 от внутренней боковой грани и 11 над нижним торцом укороченного задника. Раскладка стенок и крепление дна в трёх пазах — наша конструкция контрольного образца.

Источники: [Hettich Rastex](https://catalog.hettich.com/General/TuI/ru_RU/catalogs/TuI_ru_RU/pdf/save/bk_1265.pdf), [Hettich Twister](https://catalog.hettich.com/General/TuI/ru_RU/catalogs/TuI_ru_RU/pdf/save/bk_1267.pdf), [Blum TANDEM](https://d2.blum.com/services/BEC003/me16460573_ep_dok_bau_%24sru_%24aof_%24v4.pdf), [инструкция к шаблону Blum](https://www.axminstertools.com/media/downloads/505186_manual.pdf).

Геометрическая проверка подтвердила совпадение 12 пар осей соединений и отсутствие пересечений шести деревянных деталей в номинальном собранном положении. Она не проверяла материал, прочность, физическую посадку, реальные замки, корпус направляющих, монтаж с инструментом или кинематику дверей. В GLB зенковки и окончания пазов показаны цилиндрическими и прямоугольными огибающими; радиусы и углы берутся из технологической карты.
