padington/cambusa-cabinet/history/outputs/joinery-review-v12/РЕФЕРЕНСЫ.md

# Новые фотографии Cambusa Fly

## Что видно на фотографиях

Двери имеют деревянное обрамление и глубину для хранения. Петли утоплены в торцы деревянных деталей и отличаются от накладных чашечных Blum 71B7550, выбранных в прежнем эскизе. Точный изготовитель и артикул по фотографии не установлены.

В показанном интерьере две стопки ящиков, по два с каждой стороны. Есть сплошная задняя стенка и вертикальная центральная перегородка. На освещённом общем виде видна вертикальная полоса света. Полки дверей и держатели бокалов закреплены в деревянной рамочной конструкции. По снимкам нельзя снять размеры пазов или толщину деталей без масштаба.

Петли и внутренние детали

Общий вид с освещением

Общий вид без освещения

## Что это меняет для нашего проекта

Следующий дверной вариант следует разрабатывать с рамочными дверями и врезными петлями, сохраняя выбранные внешние пропорции. Это рабочее направление по референсам, не утверждённый артикул. Форма v08 остаётся сохранённой. Старые чашечные петли и планки больше нельзя автоматически переносить в новую присадку.

Сначала выбираем совместимую с толщиной дерева и полной массой нагруженной двери петлю, затем проектируем её карманы, рамку и соединения. Фотография не даёт оснований назначать скрытой петле отверстие Ø35: такие отверстия относятся к прежним чашечным петлям.

Как пример этого класса проверена Sugatsune HES3D-70: минимальная толщина двери 19 мм; у нас в старом варианте 18 мм. Поэтому это не прямая замена. Нужны другой артикул или новое сечение рамки; грузоподъёмность выбирается с учётом двери и содержимого. Точная модель петель Riva неизвестна.

Дополнительная пара ящиков, подсветка и держатели бокалов записаны как возможные опции. Они пока не добавлены к нашей закупке автоматически. Старые пять листов и смета относятся к варианту v10 и требуют пересчёта при смене конструкции дверей.

## Проверка описания оригинала

Фабрика Riva 1920 указывает для Cambusa Fly корпус из столярной плиты blockboard, ящики из массива с соединением «ласточкин хвост», железное основание, двери с хранением и автоматическую LED-подсветку. Берёзовая фанера и разборный алюминий — наши способы изготовления комплекта для самостоятельной сборки. Столярная плита не равна берёзовой фанере.

Размеры фабрики указаны как 90/180,6 × 52,2 × 180 см; наша выбранная ширина 100 см и глубина 50 см — адаптация. Точная марка петель и их присадка на странице фабрики не опубликованы. Угол 180° нельзя подтверждать одним общим описанием другой модели Cambusa.

Источники: [Riva 1920](https://www.riva1920.it/en/products/living-and-dining-furniture/display-and-storage-units/cambusa-fly), [технический лист Sugatsune HES3D-70](https://www.sugatsune.com/content/site-assets/201B_PDF/309.pdf). Фотографии предоставлены пользователем и сохранены без изменений.
