padington/cambusa-cabinet/history/outputs/tandem-review-v14/ПРОЧИТАТЬ-СНАЧАЛА.md

# v14. Ящик и направляющие Blum TANDEM

В проверочную 3D-сборку ящика v13 добавлены контуры левой и правой направляющих **560H3500B** из опубликованных DXF. При выбранной привязке выявлены попадания точек CAD в переднюю и заднюю стенки. **Заказывать присадку пока рано**: необходимо подтвердить высоту и положение установки и проверить узел с замками.

- [3D: ящик, обе направляющие и отмеченные места](ЯЩИК-И-НАПРАВЛЯЮЩИЕ.glb)
- [Проверочный вид](ПРОВЕРКА-ГЛУБИНЫ.png)
- [Числовой отчёт, входные файлы, контрольные суммы](ПРОВЕРКА.json)

## Что проверено

1. **Глубина в текущей компоновке.** От передней поверхности внутреннего фасада до задней стенки 488 − 122 = **366 мм**. Для внутреннего ящика без дополнительных аксессуаров схема Blum требует 350 + 12 + 3 = **365 мм**. Запас над минимумом — 1 мм. Если сместить весь узел вперёд на 4 мм, запас станет 5 мм, а расстояние до пустых дверных лотков v08 уменьшится с 39 до 35 мм. Это проверка старой геометрии дверей; наполненные объёмные двери и новые петли ещё нужно проверить. Сдвиг сам по себе не устраняет конфликт направляющей с ящиком, поскольку они движутся вместе.
2. **Ширина.** При фактической ширине отсека 473 мм допустимая внутренняя ширина ящика по схеме Blum — **429,5–431 мм**. Размер v13 равен 431 мм и находится на верхней границе. Для следующего расчёта разумно взять середину диапазона, 430,25 мм, при условии подтверждения фактической ширины отсека и точности обработки. Это пока не изменение размеров деталей.
3. **Крепление в боковины.** Отверстия выбранного ряда совпадают по продольному шагу с позициями 19 / 37 / 69 / 261 мм от базы направляющей по монтажной схеме. У металлического профиля свой передний край, сдвинутый на 2 мм относительно этой базы. Кандидаты не пересекают сетку перфорации Ø12 при проверочном положении: минимальное расстояние между окружностью перфорации и условным стержнем Ø4 — 8,5 мм, при сдвиге на 4 мм — около 8,3 мм. Головки, выступающие штифты аксессуаров и работа винтов не проверены.
4. **3D-посадка.** Для нижнего ящика проверочная высота выбрана по длинной верхней плоскости подвижной части CAD, совмещённой с нижней стороной дна. В этом положении точки передней части CAD попали в дерево примерно на 0,08 мм, а задней — до 0,45 мм. Это расстояние от точки до ближайшей поверхности дерева, не величина подрезки. В расчёте участвовали реальные деревянные тела v13 и вершины исходного CAD; полное пересечение сплошных тел и кинематика не проверены. На каждой направляющей в GLB показаны 640 прямых и 323 дуговых ребра; 8 сложных кривых пропущены. Красные отметки показывают места, которые надо перепроверить на подлинной сборке.

## Привязки для проверки, мм

У верхнего ряда винтов проверочная высота от нижней кромки панели составляет **51,8 мм** для нижнего ящика и **205,8 мм** для верхнего. Это положение из проверочной сборки, не подтверждённая карта сверления. Отступы по глубине считаются **от передней кромки конкретной панели**:

| Деталь | v08: фасад ящика на 122 мм | Кандидат: фасад на 118 мм |
|---|---:|---:|
| W04, правая перфорированная боковина | 133 / 151 / 183 / 375 | 129 / 147 / 179 / 371 |
| W06, центральная перегородка | 49 / 67 / 99 / 291 | 45 / 63 / 95 / 287 |

## Что нужно до выпуска присадки

- Взять согласованную сборочную модель Blum для **560H3500B + T51.1700.04 L/R** или провести примерку одной пары направляющих и двух замков. Отдельные DXF обеих направляющих получены. У двух скачанных DWG, подписанных как левый и правый замок, одна контрольная сумма; подтвердить по этим файлам две разные детали нельзя. Замки в 3D не добавлялись.
- Проверить места у заднего зацепа и передней стенки. После подтверждения установочной высоты определить, нужна ли корректировка дерева. Пробу наклонных пилотов сделать по шаблону **T65.1000.02** на деталях той же толщины; дома сверлить не нужно.
- Согласовать ширину после отделки, зазоры, доступ отвёртки и выдвижение при открытых дверях. Только затем обновить модель вырезов, ведомость и раскладку. Двери, корпус и основание остаются следующими узлами проекта.

Технические размеры взяты из [монтажной схемы Blum 560H](https://publications.blum.com/2024/catalogue/en/435/). Исходные DXF направляющих доступны в разделе Downloads [карточки 560H3500B](https://swshardware.com/products/tandem-full-extension-runner-plus-blumot?variantId=12052). Все ссылки на CAD и контрольные суммы записаны в отчёте.
