padington/cambusa-cabinet/history/outputs/drawer-proof-v13/Размерные-привязки-v13.pdf

## 3D-модель задаёт обработку и размерные привязки

Это исправление способа проверки v12; общая модель шкафа v08 не заменяется.


v13 | 04.11.2026 | мм | GLB SHA256 09c1738a831d | НЕ ДЛЯ ИЗГОТОВЛЕНИЯ | Лист 1

6 деревянных деталей с вычтенной обработкой.

50 операций: проверены вырезы в материале.

12 пар осей стяжек и шкантов совпадают.

4 оси шурупов фасада совпадают.

Пазы боковин имеют реальные концы R3.

Зенковки построены конусами 90 градусов.

Проверены 101 положение на каждом из 5 шагов.

Проверка сборки относится только к дереву.

Реальная фурнитура пока не смоделирована.

Пилоты замков и направляющих ещё не заданы.

Правила чтения

Операции имеют те же номера, что в просмотре 3D и JSON. Каждый лист показывает отдельную группу обработки.

Отступы показаны размерными линиями от баз U0 и V0. У отверстия привязан центр; у паза - нижний левый угол.

U0/V0 - физические кромки с общей системой координат детали. На обратном виде U0 может находиться справа.

Виды выполнены с учётом стороны обработки; положение базы подписано. Глубина всегда отсчитывается от указанной пласти.

Размеры номинальные. Допуски и фактическая толщина фанеры должны быть назначены до технологического выпуска.

Врезные петли новых дверей пользователем выбраны как направление; точный артикул и их присадка пока отсутствуют.

## W37, W43 | Левая боковина

340 × 110 × 12 | обработка: B | left-01, left-02, left-04, left-05

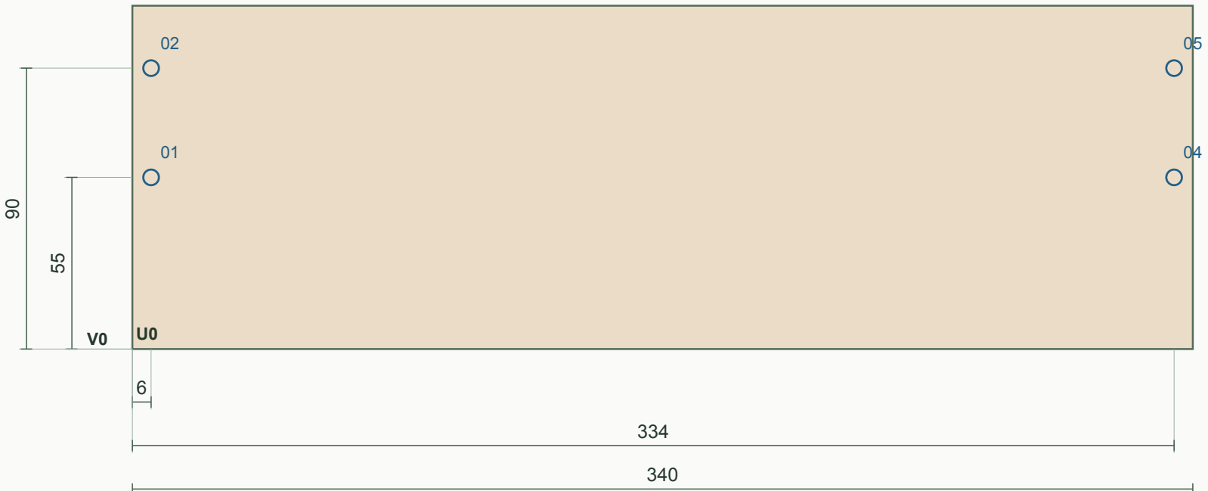
[picture p87: figure]

v13 | 04.11.2026 | мм | GLB SHA256 09c1738a831d | НЕ ДЛЯ ИЗГОТОВЛЕНИЯ | Лист 2

Вид на пласть B; U0 слева, V0 снизу

110

Сечение / глубина

гл. 9

толщ. 12

Ø5

Глубина от пласти B; A = w0, B = w12.

Шток Twister DU319T 48037

## W37, W43 | Левая боковина

340 × 110 × 12 | обработка: B | left-03, left-06
v13 | 04.11.2026 | мм | GLB SHA256 09c1738a831d | НЕ ДЛЯ ИЗГОТОВЛЕНИЯ | Лист 3

Вид на пласть B; U0 слева, V0 снизу

03 | 06

U0 V0

6

334

340

35

110

Сечение / глубина

гл. 8

толщ. 12

Ø8

Глубина от пласти B; A = w0, B = w12.

Шкант 8×30; сопряжение с торцом стенки

## W37, W43 | Левая боковина

340 × 110 × 12 | обработка: B | left-07
v13 | 04.11.2026 | мм | GLB SHA256 09c1738a831d | НЕ ДЛЯ ИЗГОТОВЛЕНИЯ | Лист 4

Вид на пласть B; U0 слева, V0 снизу

07

U0 V0

6

334

340

12.9

22.1

110

Сечение / глубина

гл. 3

толщ. 12

Паз 328 × 9.2

Глубина от пласти B; A = w0, B = w12.

Паз дна; концы R3. При фактической толщине дна ≠9 пересчитать ширину.

## W38, W44 | Правая боковина

340 × 110 × 12 | обработка: A | right-01, right-02, right-04, right-05

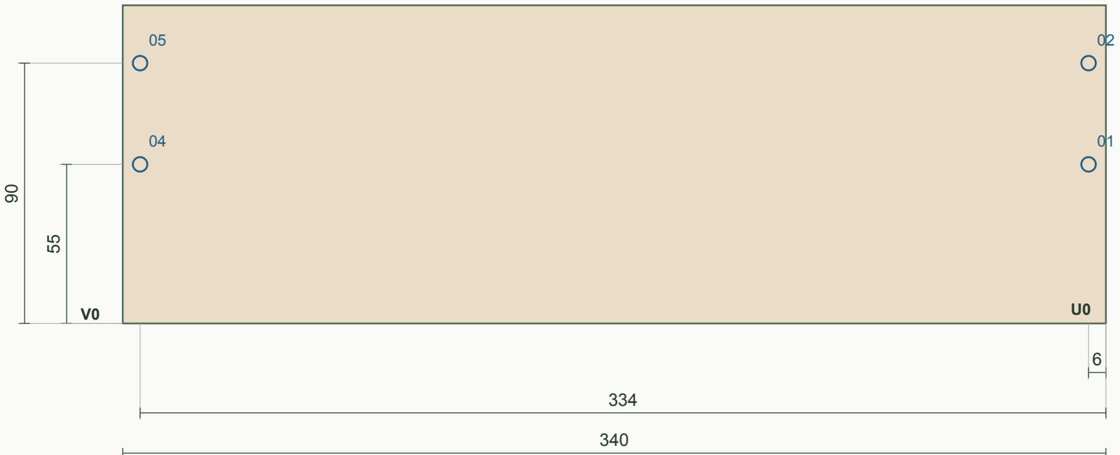
[picture p88: figure]

v13 | 04.11.2026 | мм | GLB SHA256 09c1738a831d | НЕ ДЛЯ ИЗГОТОВЛЕНИЯ | Лист 5

Вид на пласть A; U0 справа, V0 снизу

110

Сечение / глубина

гл. 9

толщ. 12

Ø5

Глубина от пласти A; A = w0, B = w12.

Шток Twister DU319T 48037

## W38, W44 | Правая боковина

340 × 110 × 12 | обработка: A | right-03, right-06
v13 | 04.11.2026 | мм | GLB SHA256 09c1738a831d | НЕ ДЛЯ ИЗГОТОВЛЕНИЯ | Лист 6

Вид на пласть A; U0 справа, V0 снизу

06 | 03

U0 V0

6

334

340

35

110

Сечение / глубина

гл. 8

толщ. 12

Ø8

Глубина от пласти A; A = w0, B = w12.

Шкант 8×30; сопряжение с торцом стенки

## W38, W44 | Правая боковина

340 × 110 × 12 | обработка: A | right-07
v13 | 04.11.2026 | мм | GLB SHA256 09c1738a831d | НЕ ДЛЯ ИЗГОТОВЛЕНИЯ | Лист 7

Вид на пласть A; U0 справа, V0 снизу

07

U0 V0

6

334

340

12.9

22.1

110

Сечение / глубина

гл. 3

толщ. 12

Паз 328 × 9.2

Глубина от пласти A; A = w0, B = w12.

Паз дна; концы R3. При фактической толщине дна ≠9 пересчитать ширину.

## W39, W45 | Передняя стенка короба

431 × 110 × 12 | обработка: B | front-01, front-03, front-06, front-08

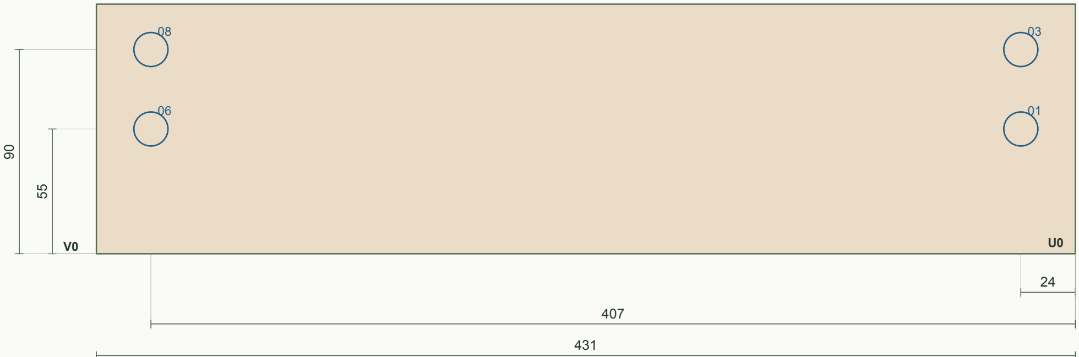
[picture p89: figure]

v13 | 04.11.2026 | мм | GLB SHA256 09c1738a831d | НЕ ДЛЯ ИЗГОТОВЛЕНИЯ | Лист 8

Вид на пласть B; U0 справа, V0 снизу

110

Сечение / глубина

гл. 10

толщ. 12

Ø15

Глубина от пласти B; A = w0, B = w12.

Карман Rastex15/12 9116019; центр 24 от торца

## W39, W45 | Передняя стенка короба

431 × 110 × 12 | обработка: U0/U1 | front-02, front-04, front-05, front-07, front-09, front-10
v13 | 04.11.2026 | мм | GLB SHA256 09c1738a831d | НЕ ДЛЯ ИЗГОТОВЛЕНИЯ | Лист 9

Вид на пласть B; U0 справа, V0 снизу

02

04

05

07

09

10

U0 V0

431

35

55

90

110

Сечение / глубина ось 6

гл. 24

12

Торцевое отверстие Ø8, глубина 24

Сечение от торца внутрь детали; ось посередине толщины.

Канал штока; ось в 6 мм от пласти A

Шкант 8×30; ось в 6 мм от пласти A

## W39, W45 | Передняя стенка короба

431 × 110 × 12 | обработка: B | front-11
v13 | 04.11.2026 | мм | GLB SHA256 09c1738a831d | НЕ ДЛЯ ИЗГОТОВЛЕНИЯ | Лист 10

Вид на пласть B; U0 справа, V0 снизу

11

U0 V0

431

12.9

22.1

110

Сечение / глубина

гл. 3

толщ. 12

Паз 431 × 9.2

Глубина от пласти B; A = w0, B = w12.

Сквозной по длине паз дна, выход в оба торца

## W39, W45 | Передняя стенка короба

431 × 110 × 12 | обработка: B | front-12, front-13, front-14, front-15, front-16, front-17, front-18, front-19

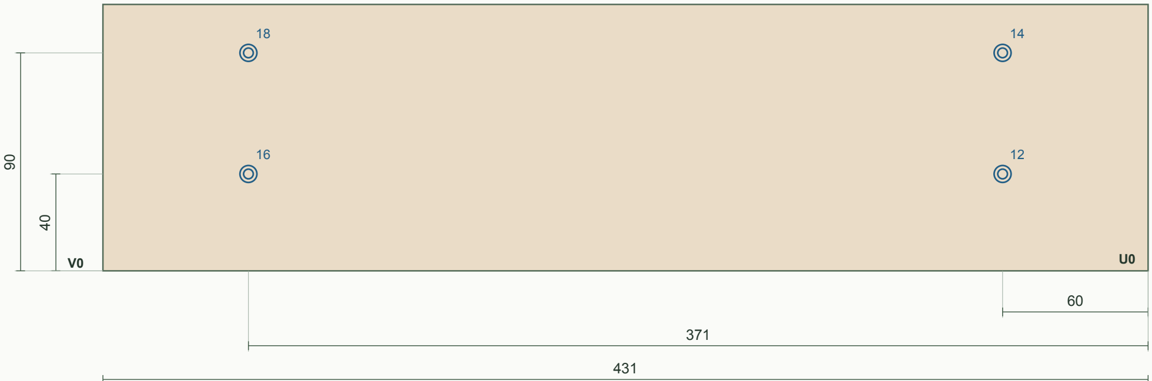
[picture p90: figure]

v13 | 04.11.2026 | мм | GLB SHA256 09c1738a831d | НЕ ДЛЯ ИЗГОТОВЛЕНИЯ | Лист 11

Вид на пласть B; U0 справа, V0 снизу

110

Сечение / глубина

гл. 12

толщ. 12

Сквозное Ø4 и зенковка Ø7 × 1,5; угол 90°

Глубина от пласти B; A = w0, B = w12.

Сквозной под шуруп фасада 3,5×20

Зенковка 90°; головка шурупа

## W40, W46 | Задняя стенка короба

431 × 97 × 12 | обработка: A | rear-01, rear-03, rear-06, rear-08

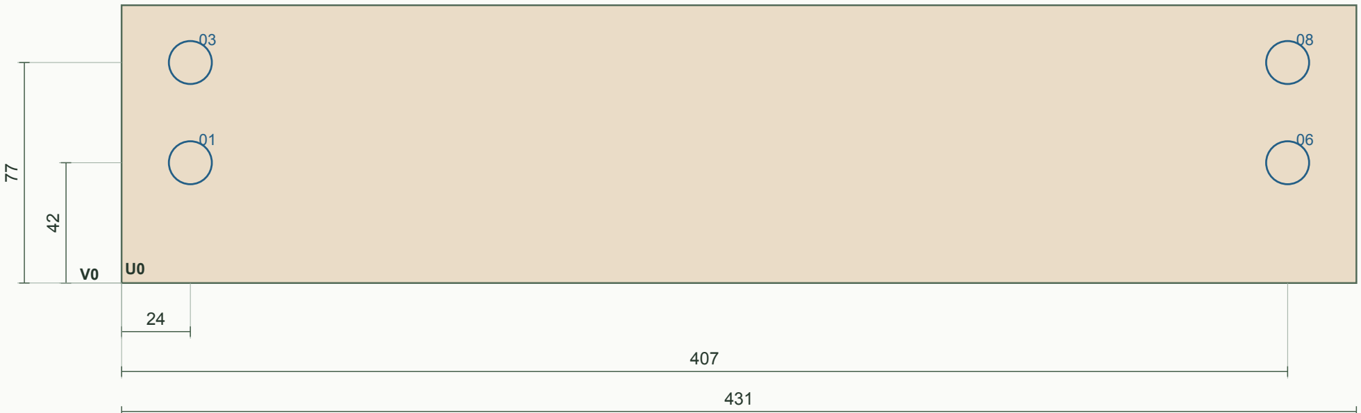
[picture p91: figure]

v13 | 04.11.2026 | мм | GLB SHA256 09c1738a831d | НЕ ДЛЯ ИЗГОТОВЛЕНИЯ | Лист 12

Вид на пласть A; U0 слева, V0 снизу

97

Сечение / глубина

гл. 10

толщ. 12

Ø15

Глубина от пласти A; A = w0, B = w12.

Карман Rastex15/12 9116019; центр 24 от торца

## W40, W46 | Задняя стенка короба

431 × 97 × 12 | обработка: U0/U1 | rear-02, rear-04, rear-05, rear-07, rear-09, rear-10
v13 | 04.11.2026 | мм | GLB SHA256 09c1738a831d | НЕ ДЛЯ ИЗГОТОВЛЕНИЯ | Лист 13

Вид на пласть A; U0 слева, V0 снизу

02

04

05

07

09

10

U0 V0

431

22

42

77

97

Сечение / глубина ось 6

гл. 24

12

Торцевое отверстие Ø8, глубина 24

Сечение от торца внутрь детали; ось посередине толщины.

Канал штока; ось в 6 мм от пласти A

Шкант 8×30; ось в 6 мм от пласти A

## W40, W46 | Задняя стенка короба

431 × 97 × 12 | обработка: B | rear-11, rear-12
v13 | 04.11.2026 | мм | GLB SHA256 09c1738a831d | НЕ ДЛЯ ИЗГОТОВЛЕНИЯ | Лист 14

Вид на пласть B; U0 справа, V0 снизу

12 | 11

U0 V0

7

424

431

11

97

Сечение / глубина

гл. 10

толщ. 12

Ø6

Глубина от пласти B; A = w0, B = w12.

Зацеп TANDEM: 7 от внутренней боковой грани, 11 над нижним торцом задней стенки

## W41, W47 | Дно

436.6 × 318.6 × 9 | обработка: A | контур без отверстий
v13 | 04.11.2026 | мм | GLB SHA256 09c1738a831d | НЕ ДЛЯ ИЗГОТОВЛЕНИЯ | Лист 15

Вид на пласть A; U0 справа, V0 снизу

U0 V0

436.6

318.6

Дно без сверлений; окончательный размер задаёт посадку в трёх пазах.

## W42, W48 | Внутренний фасад

465 × 142 × 12 | обработка: B | face-01, face-02, face-03, face-04

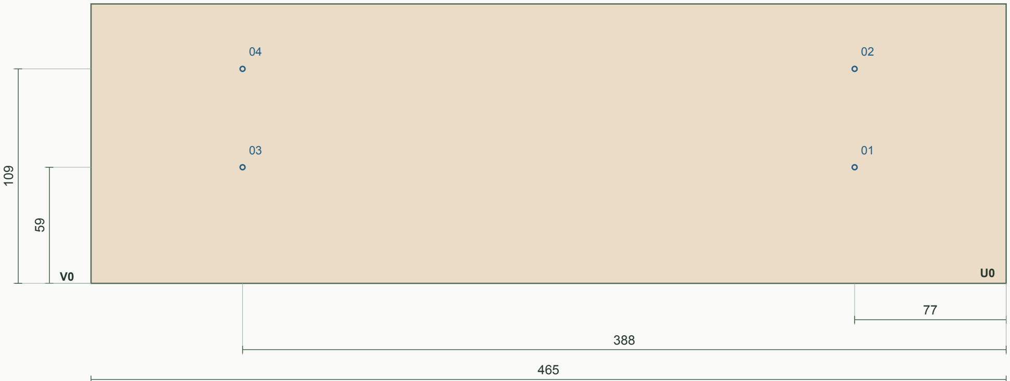
[picture p92: figure]

v13 | 04.11.2026 | мм | GLB SHA256 09c1738a831d | НЕ ДЛЯ ИЗГОТОВЛЕНИЯ | Лист 16

Вид на пласть B; U0 справа, V0 снизу

142

Сечение / глубина

гл. 8

толщ. 12

Ø2.5

Глубина от пласти B; A = w0, B = w12.

Пилот шурупа 3,5×20; размер проверить на образце

## W42, W48 | Внутренний фасад

465 × 142 × 12 | обработка: B | face-05
v13 | 04.11.2026 | мм | GLB SHA256 09c1738a831d | НЕ ДЛЯ ИЗГОТОВЛЕНИЯ | Лист 17

Вид на пласть B; U0 справа, V0 снизу

05

U0 V0

182.5

282.5

465

128

142

142

Сечение / глубина

гл. 6

толщ. 12

Паз 100 × 14

Глубина от пласти B; A = w0, B = w12.

Предложенный фрезерованный хват сзади, открыт к верхней кромке; без покупной ручки
