padington/cambusa-cabinet/history/outputs/joinery-review-v12/Пазы-и-отверстия-ящика-v12.pdf

# Пазы и отверстия контрольного ящика

### Размер ящика 455 × 340; боковины 12; дно 9; внутренний фасад 465 × 142 × 12

v12 · контрольный ящик для LW473 · 03.11.2026 · размеры мм · не полный комплект шкафа | Лист 1

Это первый узел с заданными координатами обработки. Он не заменяет присадку всего шкафа.

LW473 - ширина отсека текущей версии. Если дверная конструкция изменит отсек, ящик пересчитывается.

Одинаковый образец применён к двум ящикам: W37-W42 и W43-W48.

## Ключевые размеры

Внутренняя ширина: 473 - 42 = 431. Наружная: 431 + 2 × 12 = 455.

Длина боковин: NL350 - 10 = 340. Высота боковин и передней стенки: 110.

Нижний просвет: 13. Задняя стенка укорочена снизу на 13: высота 97.

Дно: 436,6 × 318,6. Зазор по краям 0,2; входит в два боковых и передний паз.

Задняя стенка без паза. Дно заканчивается перед ней с зазором, освобождая зацепы.

## Как читать координаты

Пласть A = w0, пласть B = w толщины. Все U,V в таблицах заданы в одной системе A.

На чертеже B показана без зеркалирования: это координатная схема, не вид с обратной стороны.

U0/U1 - левый/правый торец. Торцевые отверстия идут на середине толщины, w6.

Глубина кармана - до плоского дна. Не добавлять длину острия сверла сверх глубины.

Синие окружности - отверстия; зелёные области - пазы; фиолетовые - зенковки.

## Что остаётся открытым

Четыре наклонных пилота замков на ящик - в цеху по T65.1000.02 и реальным замкам.

Крепление направляющих в корпусе и новый тип дверных петель ещё не выпущены.

Фактическая толщина фанеры и посадки должны быть проверены на одном образце.

# W37, W43 · Левая боковина

### 340 × 110 × 12 · две одинаковые детали · U вправо, V вверх

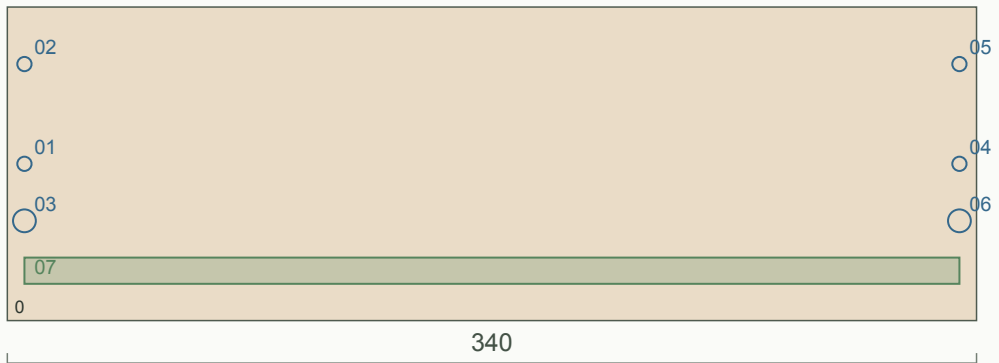
[picture p93: figure]

v12 · контрольный ящик для LW473 · 03.11.2026 · размеры мм · не полный комплект шкафа | Лист 2

## Пласть A

0
340

110

## Пласть B

110

## Операции · номера на схеме

№ | Сторона | U | V | Диаметр / размер | Глубина | Назначение
01 | B | 6 | 55 | 5 | 9 | Шток Twister DU319T 48037
02 | B | 6 | 90 | 5 | 9 | Шток Twister DU319T 48037
03 | B | 6 | 35 | 8 | 8 | Шкант 8×30; сопряжение с торцом стенки
04 | B | 334 | 55 | 5 | 9 | Шток Twister DU319T 48037
05 | B | 334 | 90 | 5 | 9 | Шток Twister DU319T 48037
06 | B | 334 | 35 | 8 | 8 | Шкант 8×30; сопряжение с торцом стенки
07 | B | 6 | 12.9 | 328 × 9.2 | 3 | Паз дна; концы R3. При фактической толщине дна ≠9 пересчитать ширину.

# W38, W44 · Правая боковина

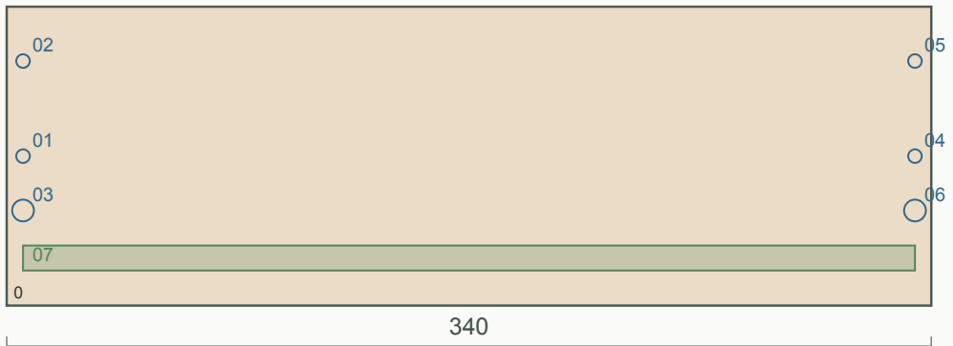
[picture p94: figure]

v12 · контрольный ящик для LW473 · 03.11.2026 · размеры мм · не полный комплект шкафа | Лист 3

## Пласть A

110

## Пласть B

0
340

110

## Операции · номера на схеме

№ | Сторона | U | V | Диаметр / размер | Глубина | Назначение
01 | A | 6 | 55 | 5 | 9 | Шток Twister DU319T 48037
02 | A | 6 | 90 | 5 | 9 | Шток Twister DU319T 48037
03 | A | 6 | 35 | 8 | 8 | Шкант 8×30; сопряжение с торцом стенки
04 | A | 334 | 55 | 5 | 9 | Шток Twister DU319T 48037
05 | A | 334 | 90 | 5 | 9 | Шток Twister DU319T 48037
06 | A | 334 | 35 | 8 | 8 | Шкант 8×30; сопряжение с торцом стенки
07 | A | 6 | 12.9 | 328 × 9.2 | 3 | Паз дна; концы R3. При фактической толщине дна ≠9 пересчитать ширину.

# W39, W45 · Передняя стенка короба

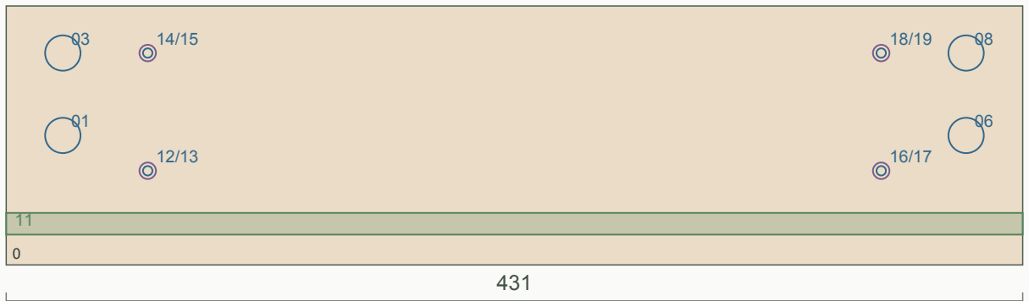
[picture p95: figure]

v12 · контрольный ящик для LW473 · 03.11.2026 · размеры мм · не полный комплект шкафа | Лист 4

## Пласть A

02

04

05

07

09

10

Торцевое сверление: проекция, ось w6

0
431

110

## Пласть B

110

## Операции · номера на схеме

№ | Сторона | U | V | Диаметр / размер | Глубина | Назначение
01 | B | 24 | 55 | 15 | 10 | Карман Rastex15/12 9116019; центр 24 от торца
02 | U0 | 0 | 55 | 8 | 24 | Канал штока; ось в 6 мм от пласти A
03 | B | 24 | 90 | 15 | 10 | Карман Rastex15/12 9116019; центр 24 от торца
04 | U0 | 0 | 90 | 8 | 24 | Канал штока; ось в 6 мм от пласти A
05 | U0 | 0 | 35 | 8 | 24 | Шкант 8×30; ось в 6 мм от пласти A
06 | B | 407 | 55 | 15 | 10 | Карман Rastex15/12 9116019; центр 24 от торца
07 | U1 | 431 | 55 | 8 | 24 | Канал штока; ось в 6 мм от пласти A
08 | B | 407 | 90 | 15 | 10 | Карман Rastex15/12 9116019; центр 24 от торца
09 | U1 | 431 | 90 | 8 | 24 | Канал штока; ось в 6 мм от пласти A
10 | U1 | 431 | 35 | 8 | 24 | Шкант 8×30; ось в 6 мм от пласти A
11 | B | 0 | 12.9 | 431 × 9.2 | 3 | Сквозной по длине паз дна, выход в оба торца
12 | B | 60 | 40 | 4 | 12 | Сквозной под шуруп фасада 3,5×20
13 | B | 60 | 40 | 7 | 1.5 | Зенковка 90°; головка шурупа
14 | B | 60 | 90 | 4 | 12 | Сквозной под шуруп фасада 3,5×20
15 | B | 60 | 90 | 7 | 1.5 | Зенковка 90°; головка шурупа
16 | B | 371 | 40 | 4 | 12 | Сквозной под шуруп фасада 3,5×20
17 | B | 371 | 40 | 7 | 1.5 | Зенковка 90°; головка шурупа
18 | B | 371 | 90 | 4 | 12 | Сквозной под шуруп фасада 3,5×20
19 | B | 371 | 90 | 7 | 1.5 | Зенковка 90°; головка шурупа

Пилоты замков: отдельно по шаблону T65.1000.02. Их координаты в этой карте не придуманы.

# W40, W46 · Задняя стенка короба

### 431 × 97 × 12 · две одинаковые детали · U вправо, V вверх

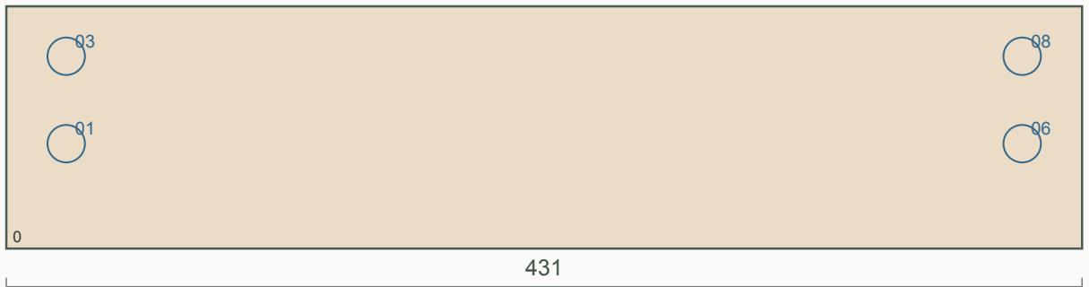
[picture p96: figure]

v12 · контрольный ящик для LW473 · 03.11.2026 · размеры мм · не полный комплект шкафа | Лист 5

## Пласть A

97

## Пласть B

11 | 12

02

04

05

07

09

10

Торцевое сверление: проекция, ось w6

0
431

97

## Операции · номера на схеме

№ | Сторона | U | V | Диаметр / размер | Глубина | Назначение
01 | A | 24 | 42 | 15 | 10 | Карман Rastex15/12 9116019; центр 24 от торца
02 | U0 | 0 | 42 | 8 | 24 | Канал штока; ось в 6 мм от пласти A
03 | A | 24 | 77 | 15 | 10 | Карман Rastex15/12 9116019; центр 24 от торца
04 | U0 | 0 | 77 | 8 | 24 | Канал штока; ось в 6 мм от пласти A
05 | U0 | 0 | 22 | 8 | 24 | Шкант 8×30; ось в 6 мм от пласти A
06 | A | 407 | 42 | 15 | 10 | Карман Rastex15/12 9116019; центр 24 от торца
07 | U1 | 431 | 42 | 8 | 24 | Канал штока; ось в 6 мм от пласти A
08 | A | 407 | 77 | 15 | 10 | Карман Rastex15/12 9116019; центр 24 от торца
09 | U1 | 431 | 77 | 8 | 24 | Канал штока; ось в 6 мм от пласти A
10 | U1 | 431 | 22 | 8 | 24 | Шкант 8×30; ось в 6 мм от пласти A
11 | B | 7 | 11 | 6 | 10 | Зацеп TANDEM: 7 от внутренней боковой грани, 11 над нижним торцом задней стенки
12 | B | 424 | 11 | 6 | 10 | Зацеп TANDEM: 7 от внутренней боковой грани, 11 над нижним торцом задней стенки

Снизу просвет 13 по всей ширине. Центры зацепов V11 относительно нового нижнего торца.

# W41, W47 · Дно

### 436.6 × 318.6 × 9 · две одинаковые детали · U вправо, V вверх

v12 · контрольный ящик для LW473 · 03.11.2026 · размеры мм · не полный комплект шкафа | Лист 6

## Пласть A

0
436.6

318.6

## Пласть B

0
436.6

318.6

## Операции · номера на схеме

№ | Сторона | U | V | Диаметр / размер | Глубина | Назначение

У дна нет отдельных сверлений. Контур уменьшен относительно v10; паз в задней стенке отменён.

# W42, W48 · Внутренний фасад

### 465 × 142 × 12 · две одинаковые детали · U вправо, V вверх

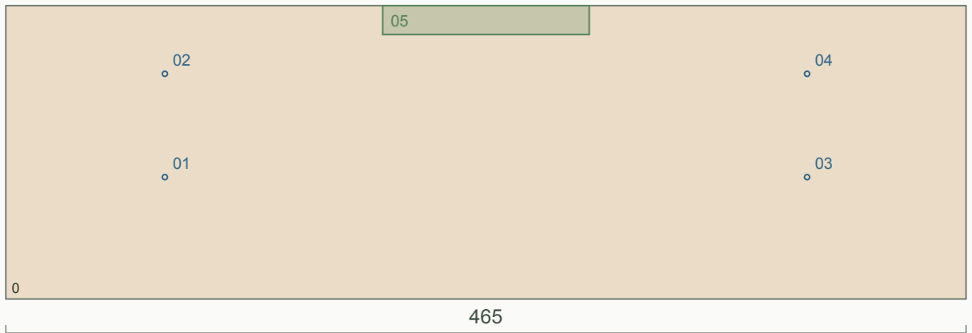
[picture p97: figure]

v12 · контрольный ящик для LW473 · 03.11.2026 · размеры мм · не полный комплект шкафа | Лист 7

## Пласть A

0
465

142

## Пласть B

142

## Операции · номера на схеме

№ | Сторона | U | V | Диаметр / размер | Глубина | Назначение
01 | B | 77 | 59 | 2.5 | 8 | Пилот шурупа 3,5×20; размер проверить на образце
02 | B | 77 | 109 | 2.5 | 8 | Пилот шурупа 3,5×20; размер проверить на образце
03 | B | 388 | 59 | 2.5 | 8 | Пилот шурупа 3,5×20; размер проверить на образце
04 | B | 388 | 109 | 2.5 | 8 | Пилот шурупа 3,5×20; размер проверить на образце
05 | B | 182.5 | 128 | 100 × 14 | 6 | Предложенный фрезерованный хват сзади, открыт к верхней кромке; без покупной ручки
