padington/cambusa-cabinet/history/outputs/boltfree-cabinet-v03/exploded.png

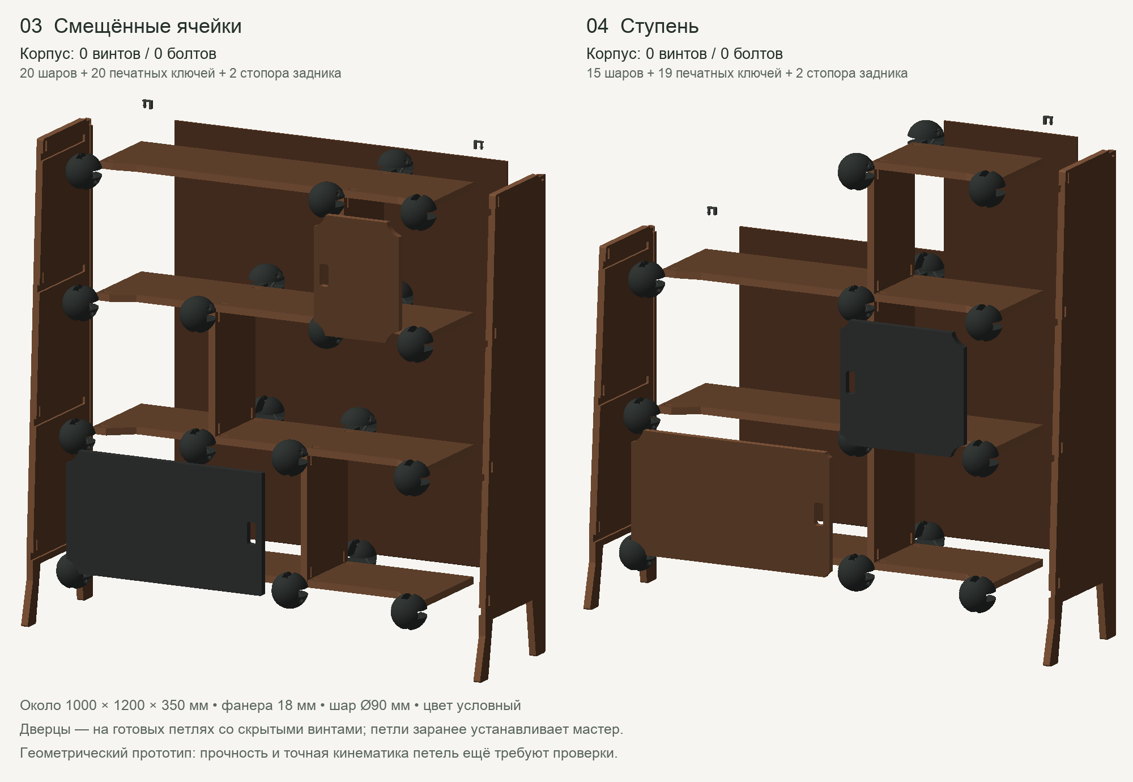
history/outputs/boltfree-cabinet-v03/exploded.png
