padington/cambusa-cabinet/history/outputs/boltfree-cabinet-v03/open.png

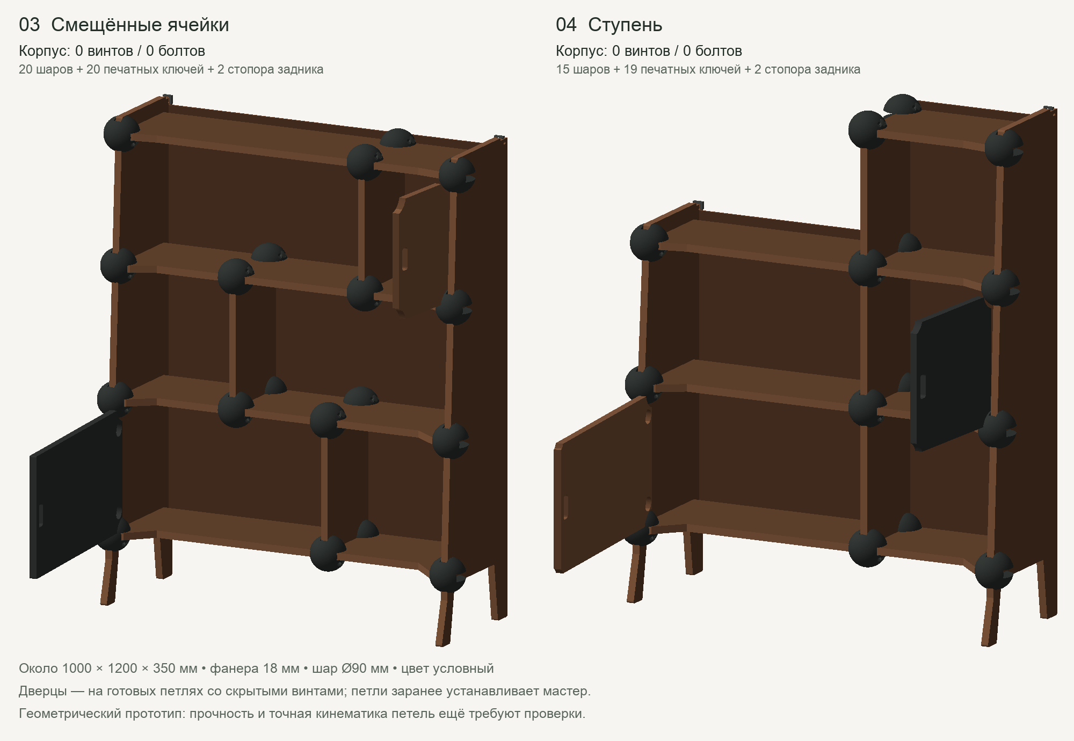
history/outputs/boltfree-cabinet-v03/open.png
