padington/cambusa-cabinet/history/outputs/boltfree-pilot-v03/back-stop-detail.png

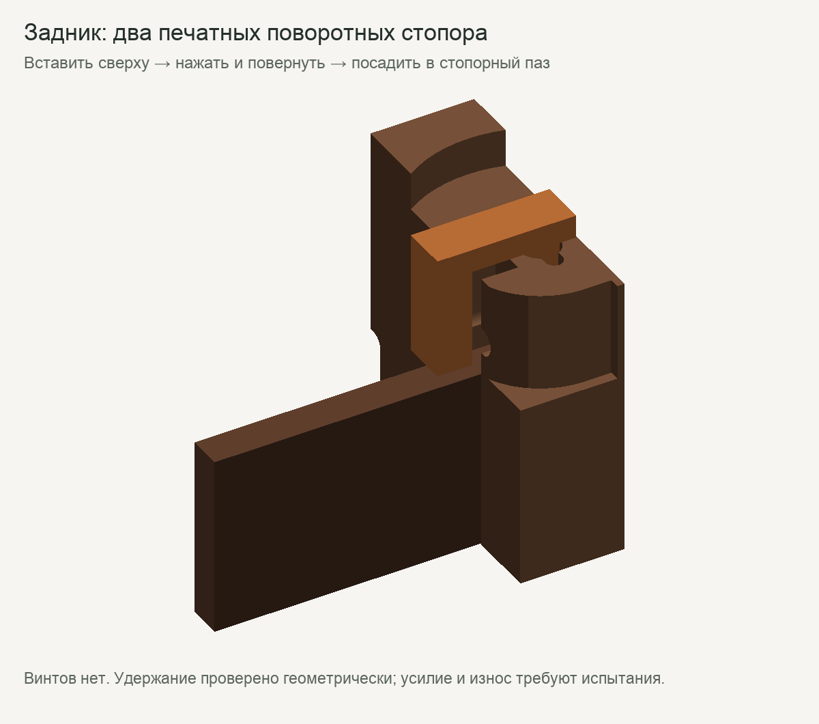
history/outputs/boltfree-pilot-v03/back-stop-detail.png
