padington/cambusa-cabinet/history/outputs/cabinet-03-04-engineering-v1/joint-prototype.png

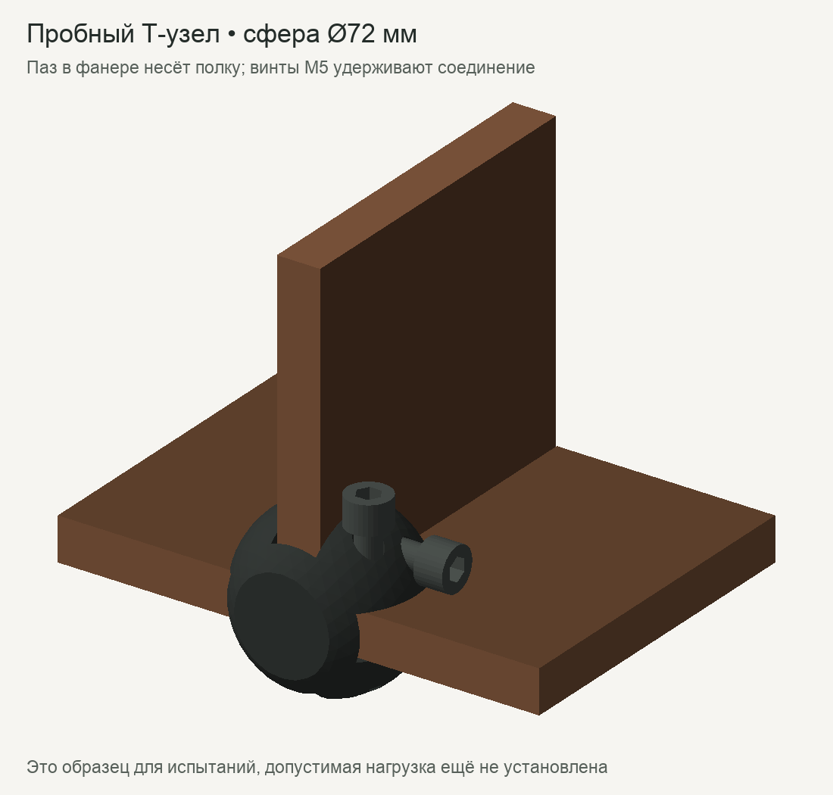
history/outputs/cabinet-03-04-engineering-v1/joint-prototype.png
