padington/cambusa-cabinet/history/outputs/cabinet-03-04-engineering-v1/open.png

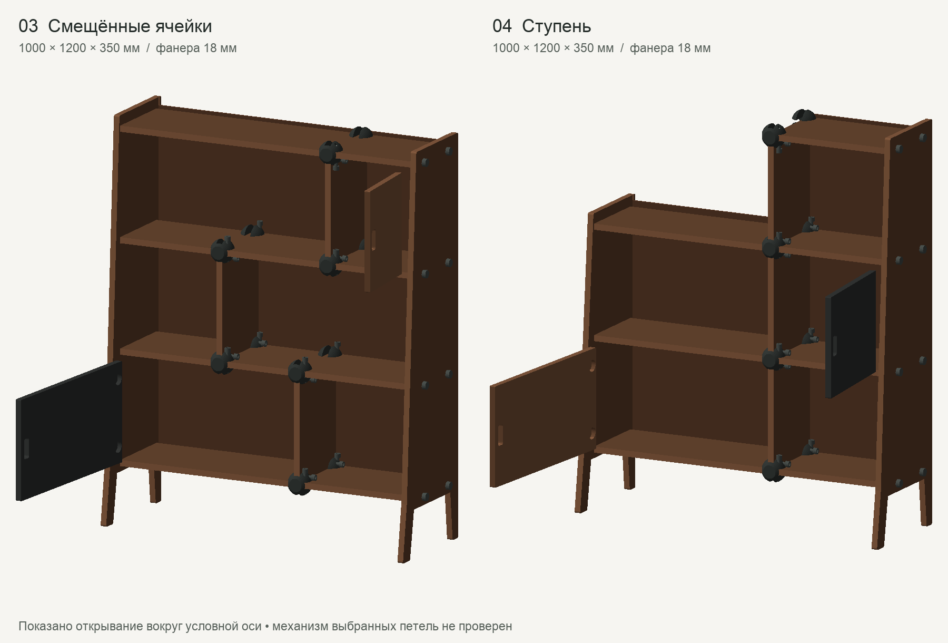
history/outputs/cabinet-03-04-engineering-v1/open.png
