padington/cambusa-cabinet/history/outputs/cambusa-direction-v07/closed.png

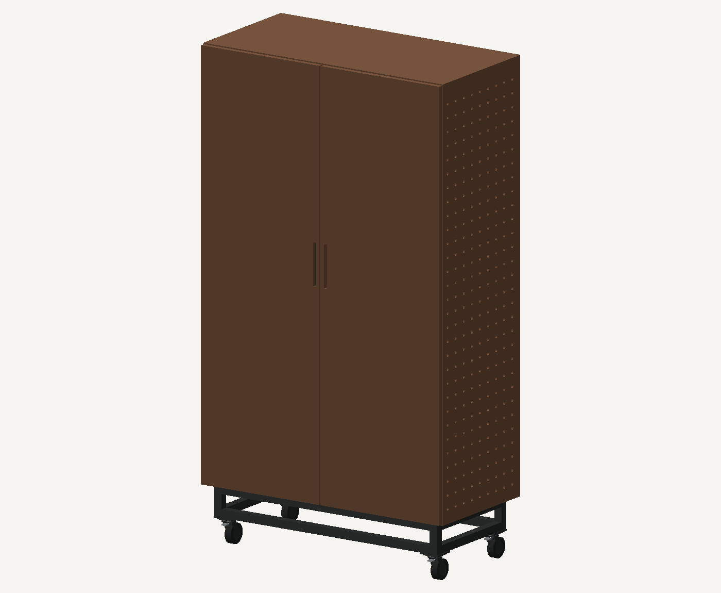
history/outputs/cambusa-direction-v07/closed.png
