padington/cambusa-cabinet/history/outputs/cambusa-direction-v07/exploded.png

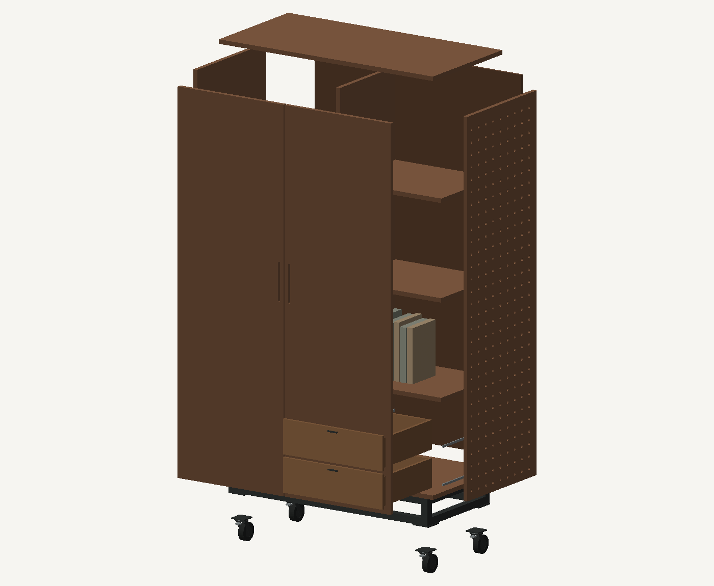
history/outputs/cambusa-direction-v07/exploded.png
