padington/cambusa-cabinet/history/outputs/cambusa-direction-v07/open.png

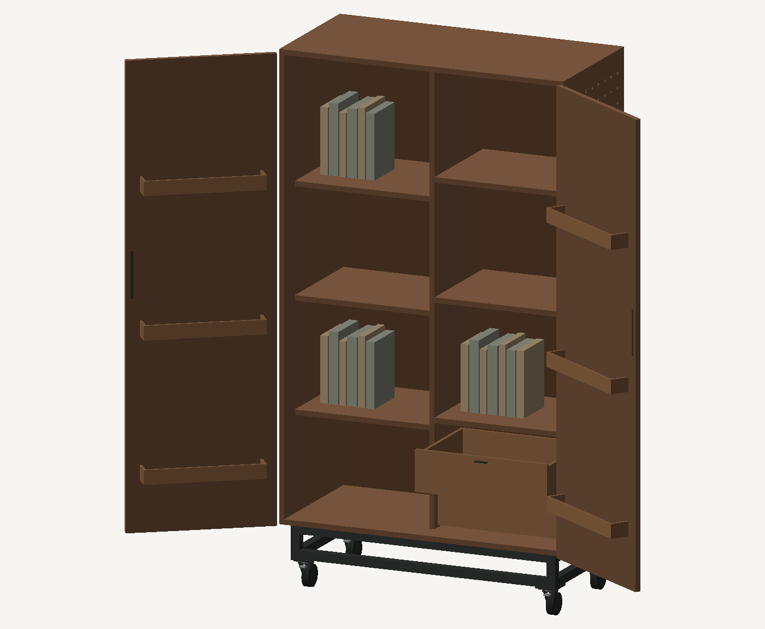
history/outputs/cambusa-direction-v07/open.png
