padington/cambusa-cabinet/history/outputs/cambusa-pegboard-v05/comparison.png

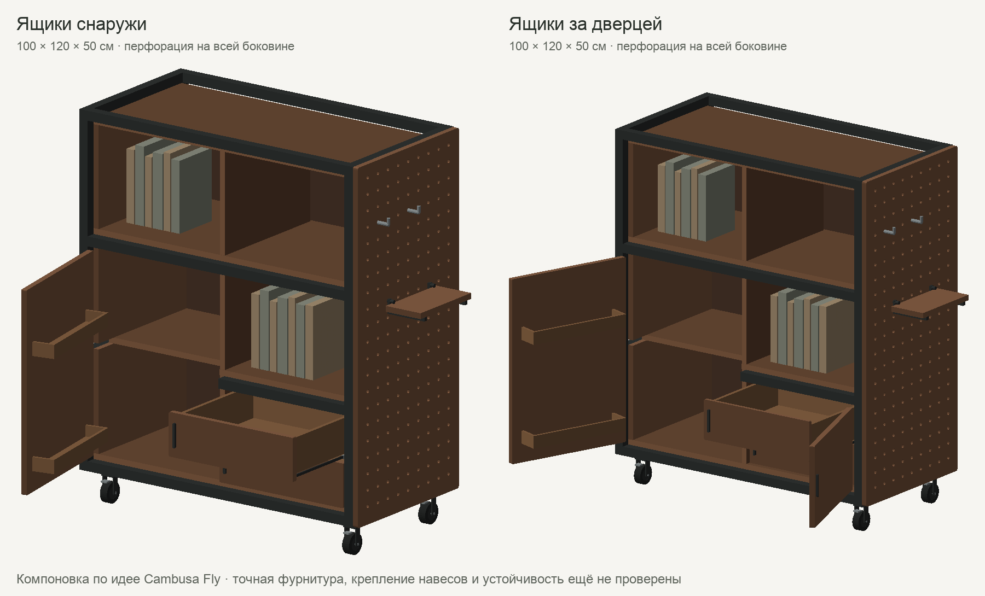
history/outputs/cambusa-pegboard-v05/comparison.png
