padington/cambusa-cabinet/history/outputs/cambusa-pegboard-v05/inside-closed.png

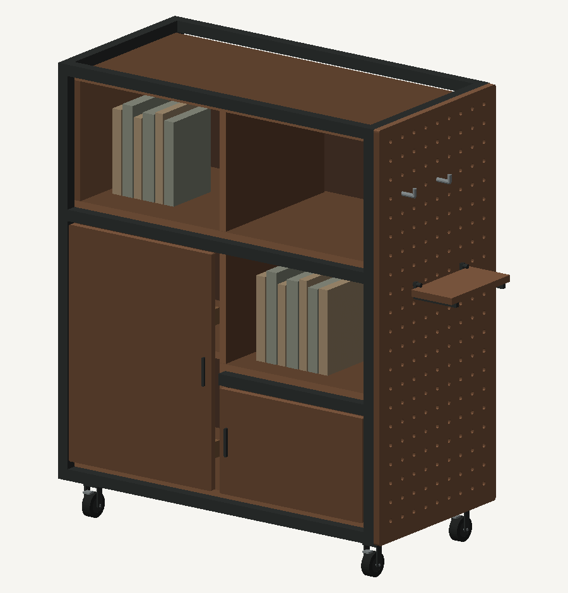
history/outputs/cambusa-pegboard-v05/inside-closed.png
