padington/cambusa-cabinet/history/outputs/cambusa-pegboard-v05/inside-open.png

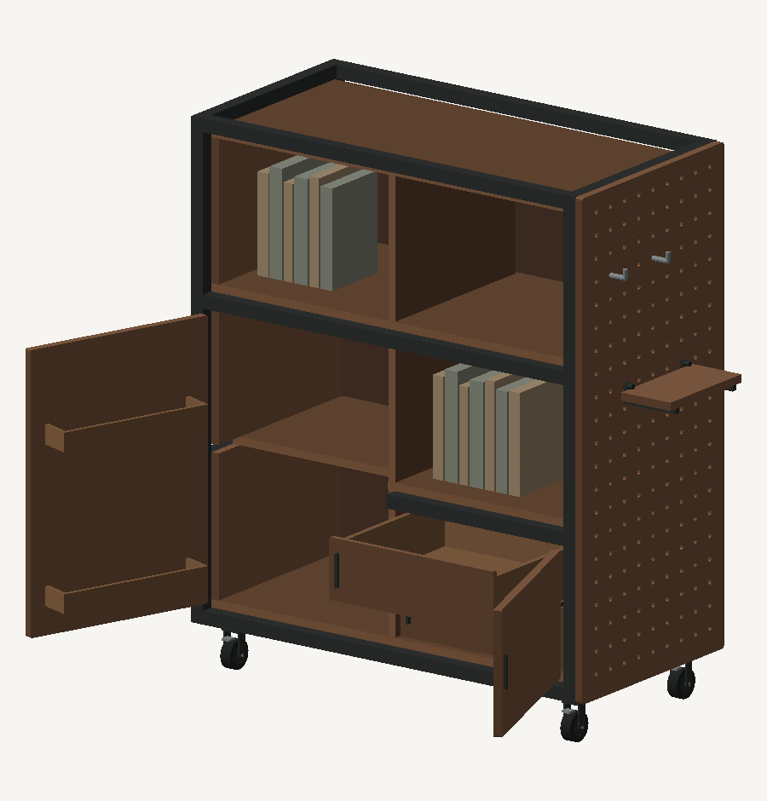
history/outputs/cambusa-pegboard-v05/inside-open.png
