padington/cambusa-cabinet/history/outputs/cambusa-pegboard-v05/outside-open.png

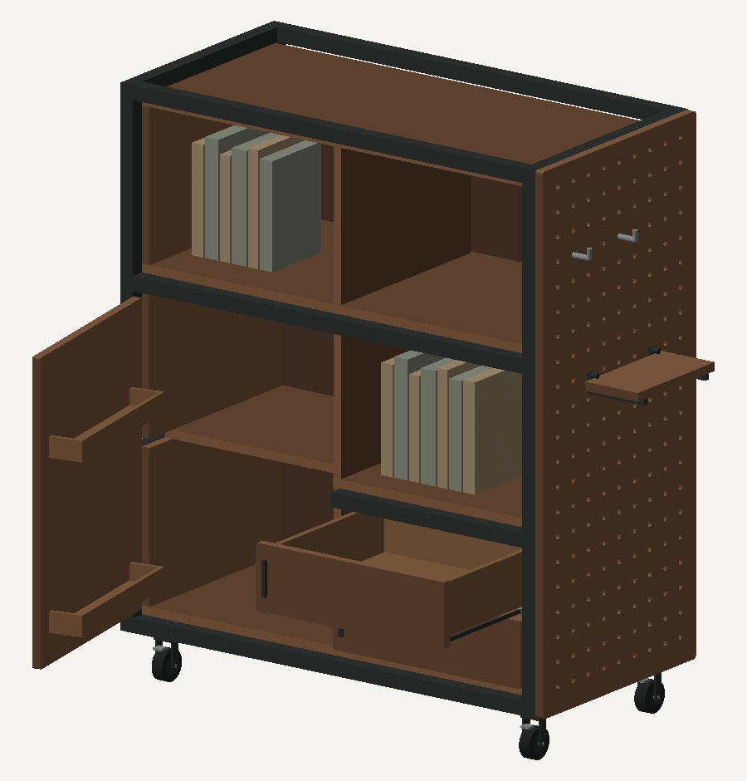
history/outputs/cambusa-pegboard-v05/outside-open.png
