padington/cambusa-cabinet/history/outputs/cambusa-proportions-v08/exploded.png

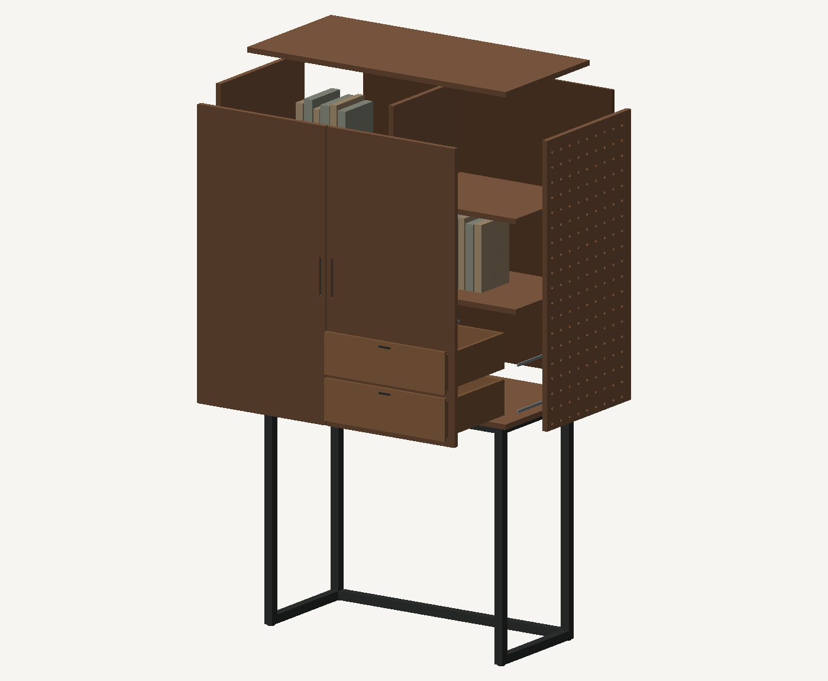
history/outputs/cambusa-proportions-v08/exploded.png
