padington/cambusa-cabinet/history/outputs/cambusa-proportions-v08/open.png

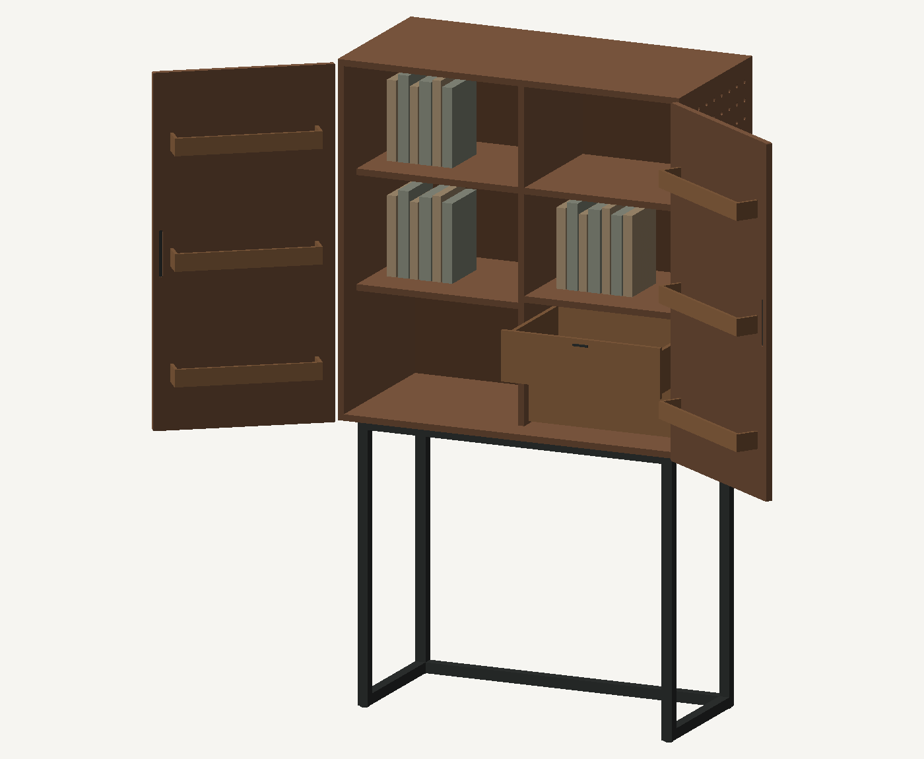
history/outputs/cambusa-proportions-v08/open.png
