padington/cambusa-cabinet/history/outputs/drawer-proof-v13/Просмотр-3D.png

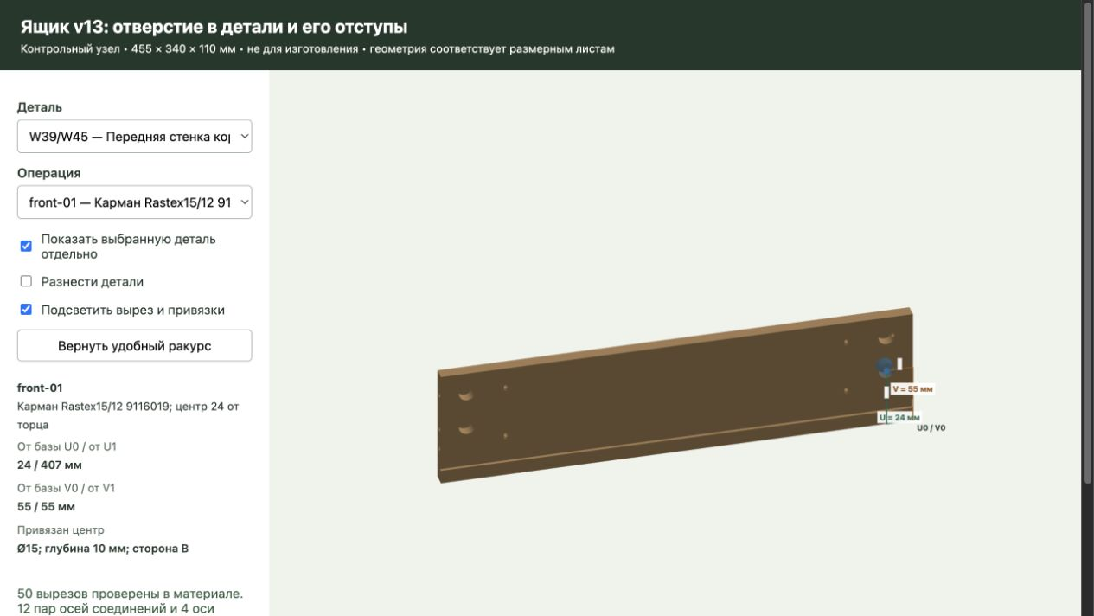
history/outputs/drawer-proof-v13/Просмотр-3D.png
