padington/cambusa-cabinet/history/outputs/mobile-cabinet-options-v04/aluminium.png

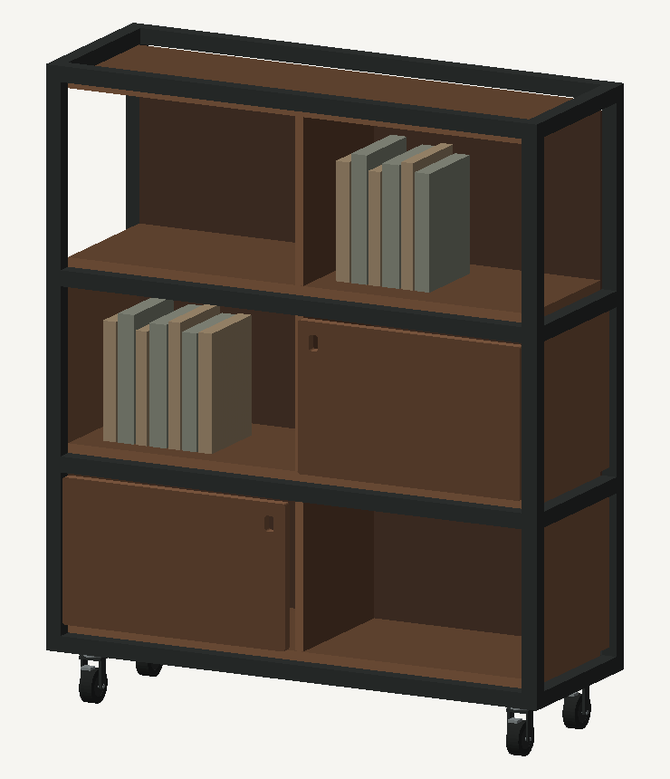
history/outputs/mobile-cabinet-options-v04/aluminium.png
