padington/cambusa-cabinet/history/outputs/mobile-cabinet-options-v04/clean.png

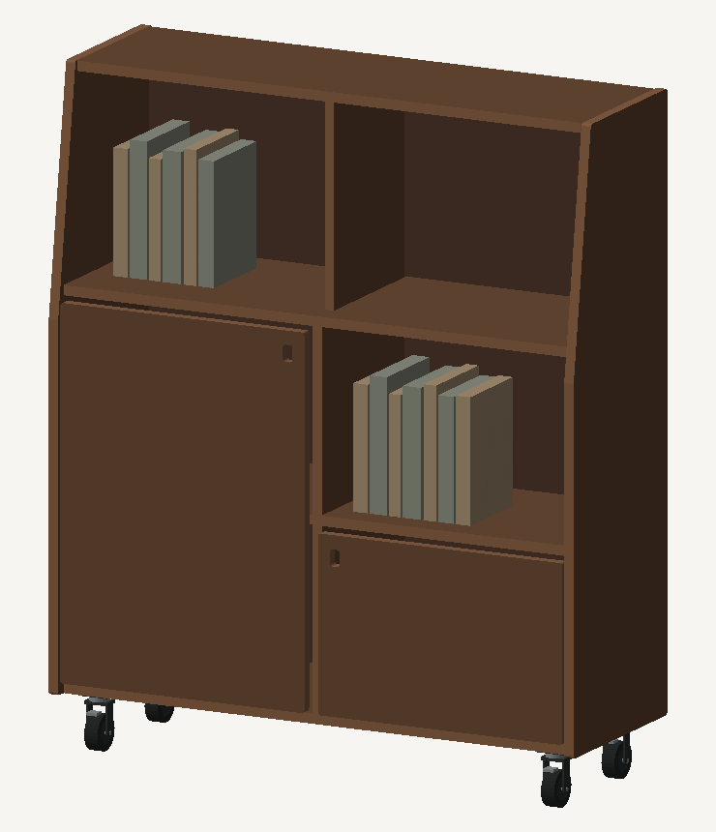
history/outputs/mobile-cabinet-options-v04/clean.png
