padington/cambusa-cabinet/history/outputs/mobile-cabinet-options-v04/comparison.png

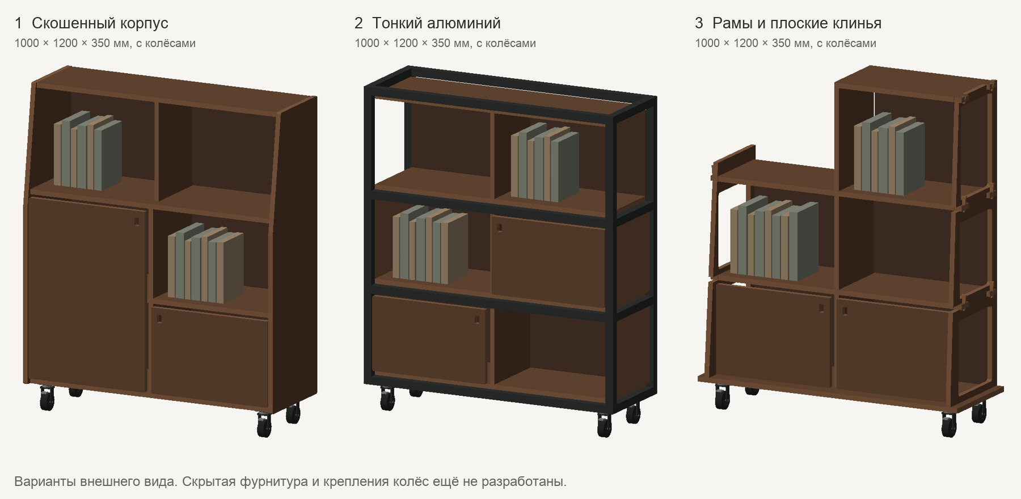
history/outputs/mobile-cabinet-options-v04/comparison.png
