padington/cambusa-cabinet/history/outputs/mobile-cabinet-options-v04/cut-plan.png

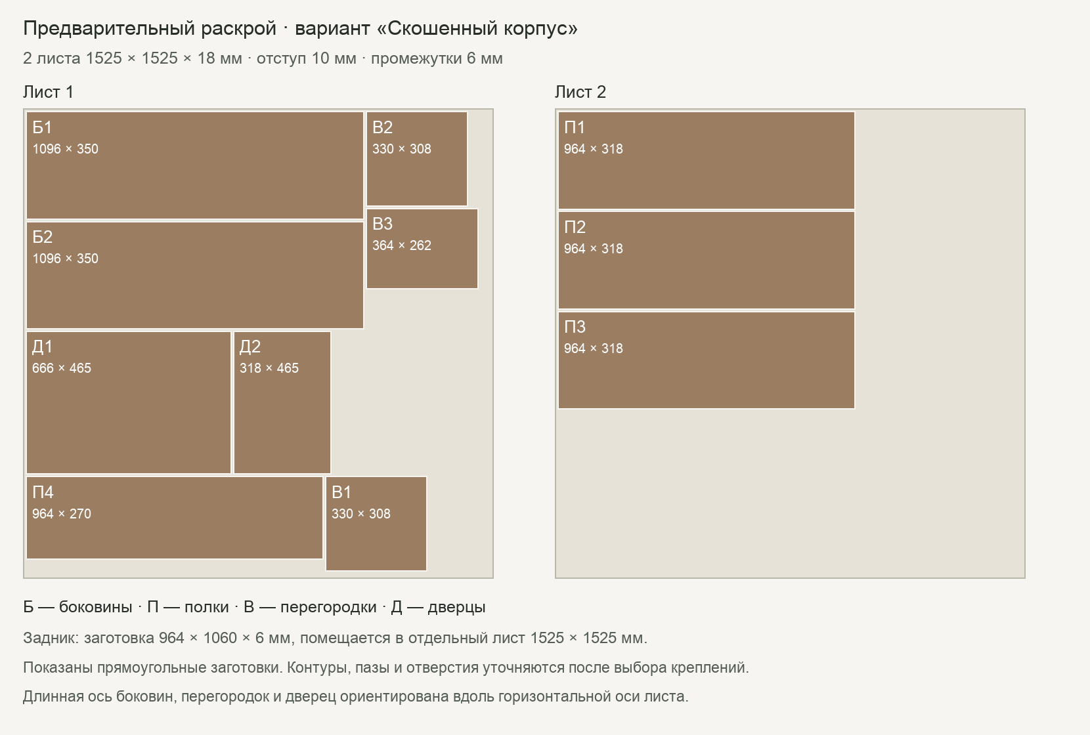
history/outputs/mobile-cabinet-options-v04/cut-plan.png
