padington/cambusa-cabinet/history/outputs/mobile-cabinet-options-v04/wedge.png

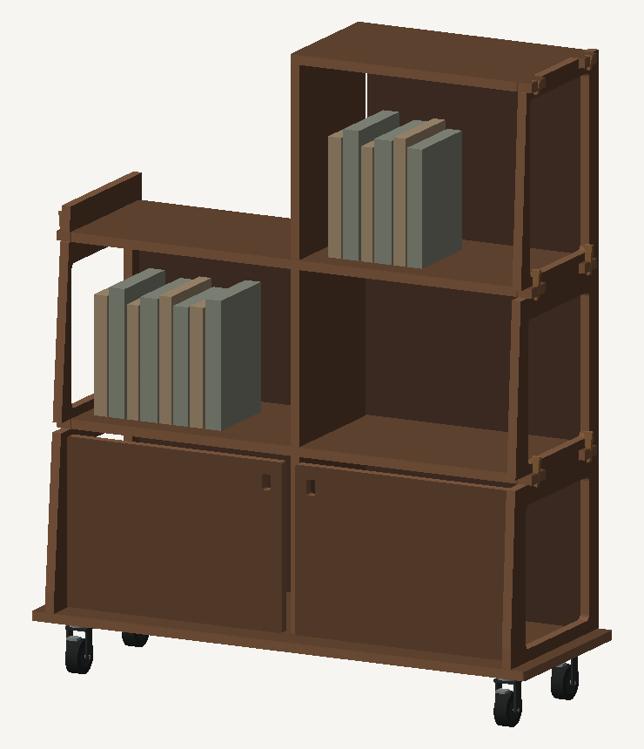
history/outputs/mobile-cabinet-options-v04/wedge.png
