padington/cambusa-cabinet/history/outputs/sphere-bayonet-v02/removed.png

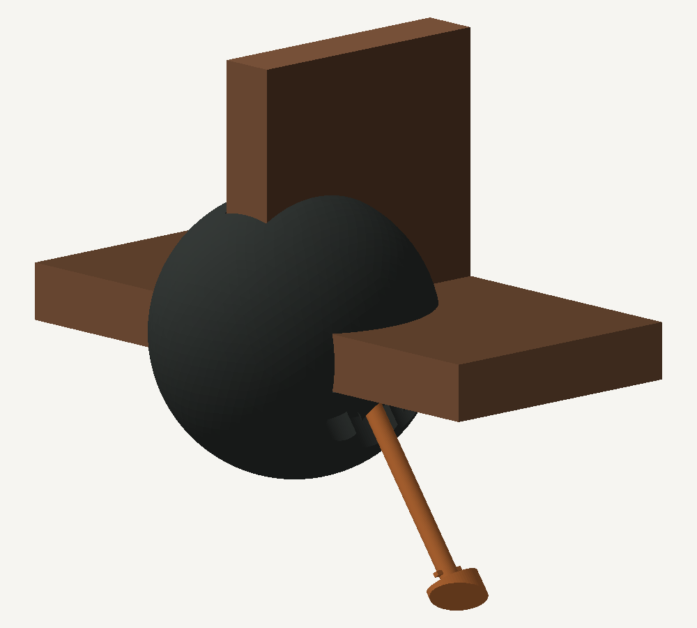
history/outputs/sphere-bayonet-v02/removed.png
