padington/cambusa-cabinet/history/outputs/sphere-bayonet-v02/section.png

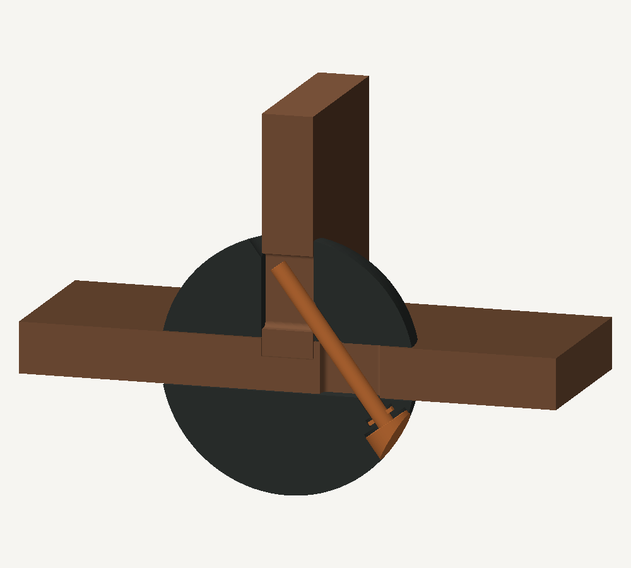
history/outputs/sphere-bayonet-v02/section.png
