padington/cambusa-cabinet/history/outputs/tandem-review-v14/ПРОВЕРКА-ГЛУБИНЫ.png

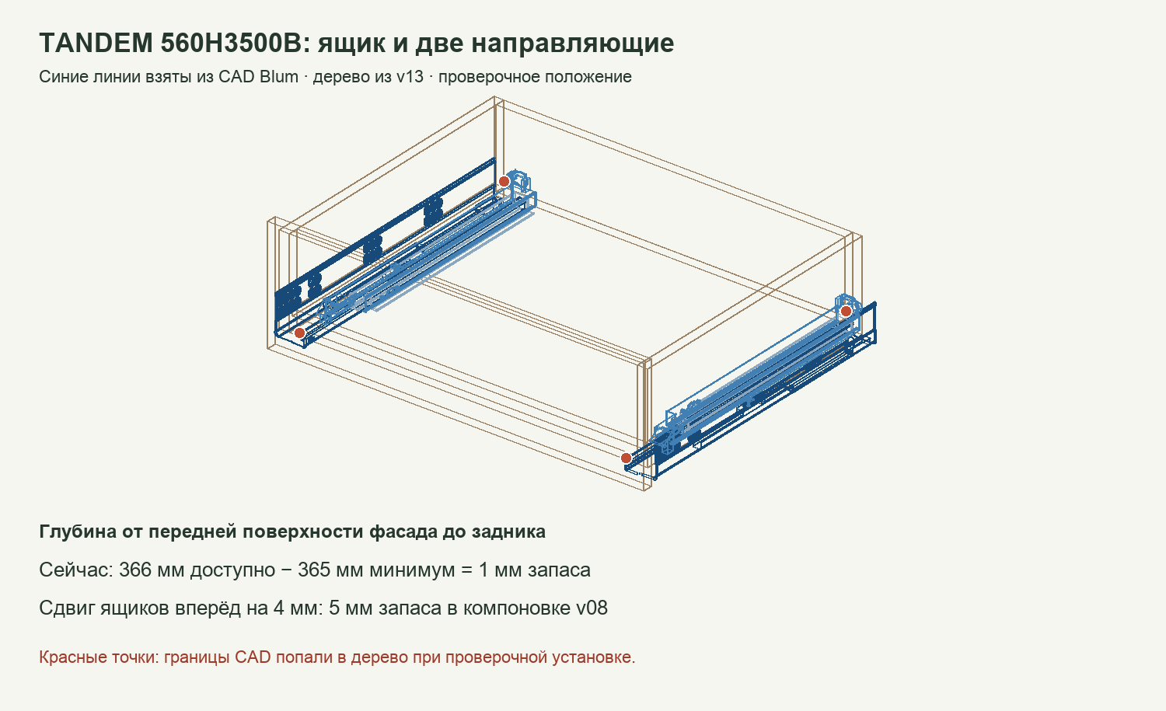
history/outputs/tandem-review-v14/ПРОВЕРКА-ГЛУБИНЫ.png
