padington/cambusa-cabinet/history/work/cabinet-closed.png

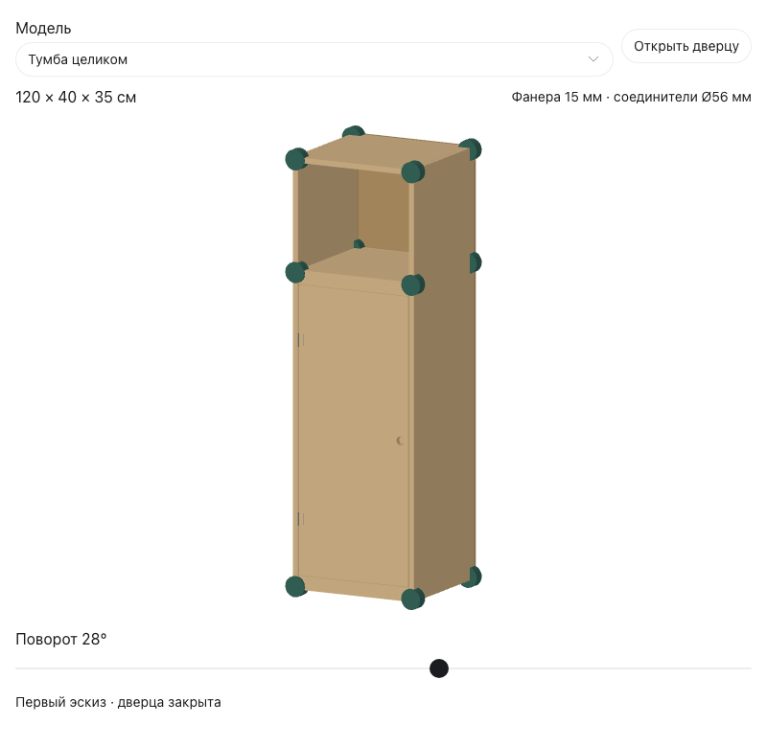
history/work/cabinet-closed.png
