padington/cambusa-cabinet/history/work/cabinet-mobile.png

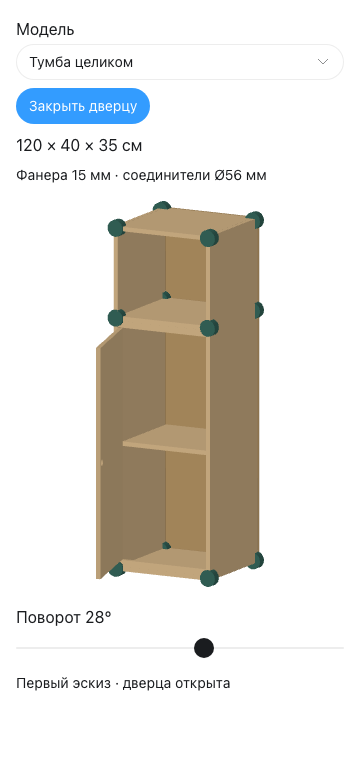
history/work/cabinet-mobile.png
