padington/cambusa-cabinet/history/work/connector-mobile.png

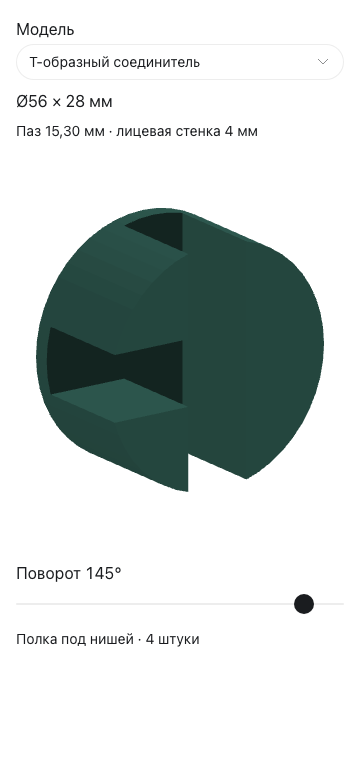
history/work/connector-mobile.png
