padington/cambusa-cabinet/history/work/connector-preview.png

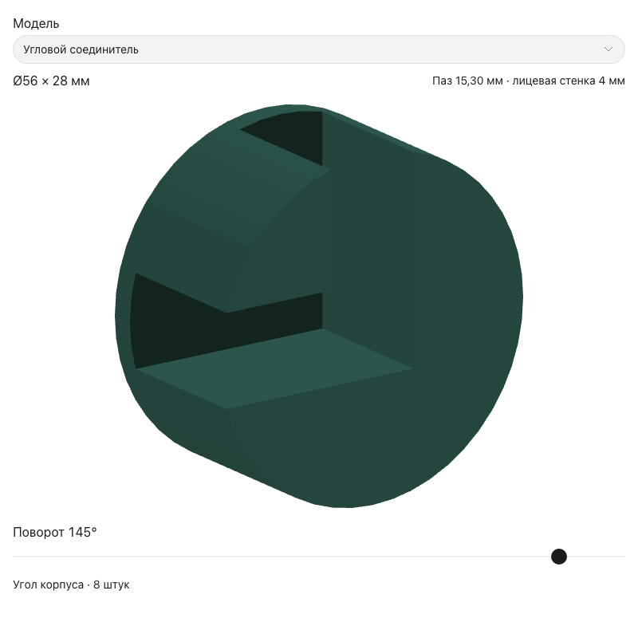
history/work/connector-preview.png
