padington/cambusa-cabinet/history/work/connector-t-preview.png

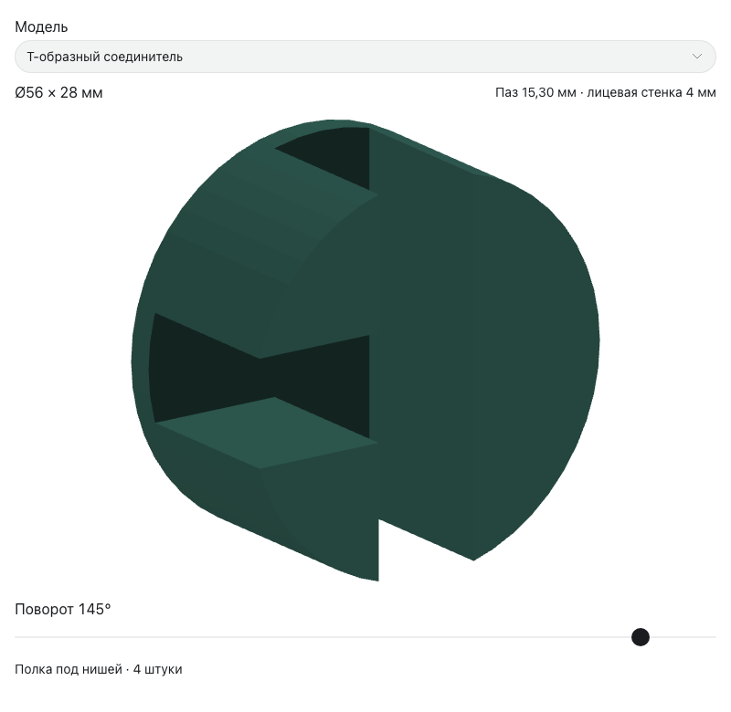
history/work/connector-t-preview.png
