padington/cambusa-cabinet/history/work/spherical-sketches-front.png

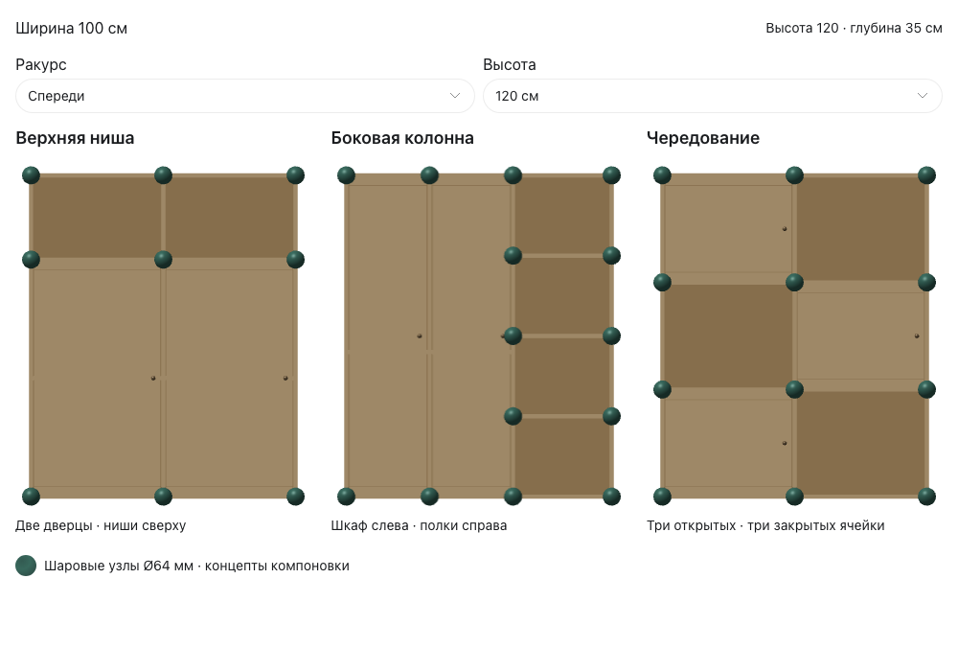
history/work/spherical-sketches-front.png
