padington/cambusa-cabinet/history/work/spherical-sketches-mobile.png

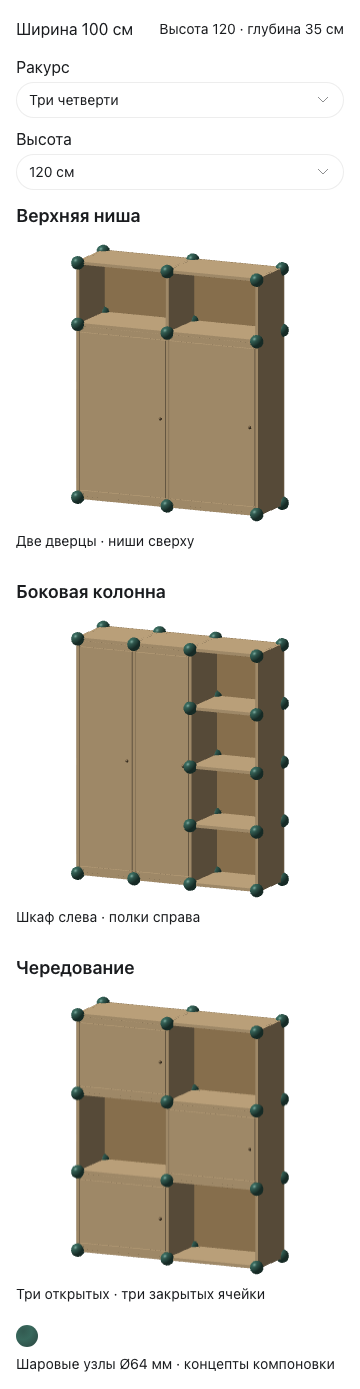
history/work/spherical-sketches-mobile.png
