padington/cambusa-cabinet/(commit log)

2026-11-04 v15: baseline with framed storage doors
2026-11-04 v16: full-height frame, browser viewer and reproducible planning
2026-11-04 v17: left pegboard, exported assembly audit and storage studies
